jmil/makerbot/trunk/firmware/README

This source for the firmware moved to: http://github.com/makerbot/G3Firmware

This directory instead now contains the firmware.makerbot.com website.
