jmil/makerbot/tags/filament-spindle-mk1/readme.txt

For full instructions, see: http://wiki.makerbot.com/spindle-mk1
