jmil/makerbot/tags/firmware-1.6/dist/readme.txt

For more info, see this page: http://wiki.makerbot.com/burn-custom-firmware-using-arduino
