jmil/makerbot/tags/firmware-1.6/SanguinoMaster/Readme.txt

=========================
SANGUINO 3G FIRMWARE v1.2
=========================

This is the v1.2 release of the firmware for Sanguino-based RepRap
motherboards and derivatives.  Right now, this includes:

* RepRap Motherboard v1.1
* RepRap Motherboard v1.2

============
INSTALLATION
============

Complete installation instructions can be found here:
http://www.reprap.org/bin/view/Main/Generation3Firmware

The important points to note are:
* You must have the Sanguino extensions to the Arduino software
properly installed
* Remember to install the libraries
* The RepRap Motherboards v1.1 and v1.2 have a flaw which prevents
them from resetting themselves when the Arduino software tries to
program them.  It's tricky to get the timing right; you may need to
try multiple times.  See the following link for more information:
http://wiki.makerbot.com/tips-and-tricks#rrmb-uploading

=======
LICENSE
=======

This program is free software; you can redistribute it and/or
modify it under the terms of the GNU General Public License
as published by the Free Software Foundation; either version 2
of the License, or (at your option) any later version.

This program is distributed in the hope that it will be useful,
but WITHOUT ANY WARRANTY; without even the implied warranty of
MERCHANTABILITY or FITNESS FOR A PARTICULAR PURPOSE.  See the
GNU General Public License for more details.

You should have received a copy of the GNU General Public License
along with this program; if not, write to the Free Software
Foundation, Inc., 51 Franklin Street, Fifth Floor, Boston, MA  02110-1301, USA.
