jmil/makerbot/users/charles/bowden/retainingMechanism-0.1.png

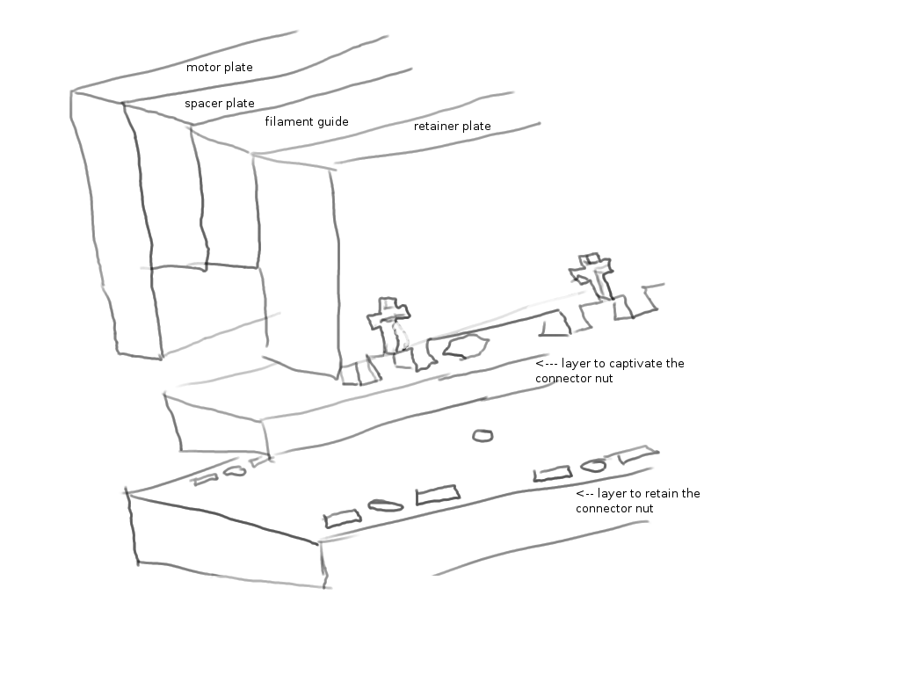
users/charles/bowden/retainingMechanism-0.1.png
