jmil/makerbot/users/charles/bowden/retainingMechanism-0.2.png

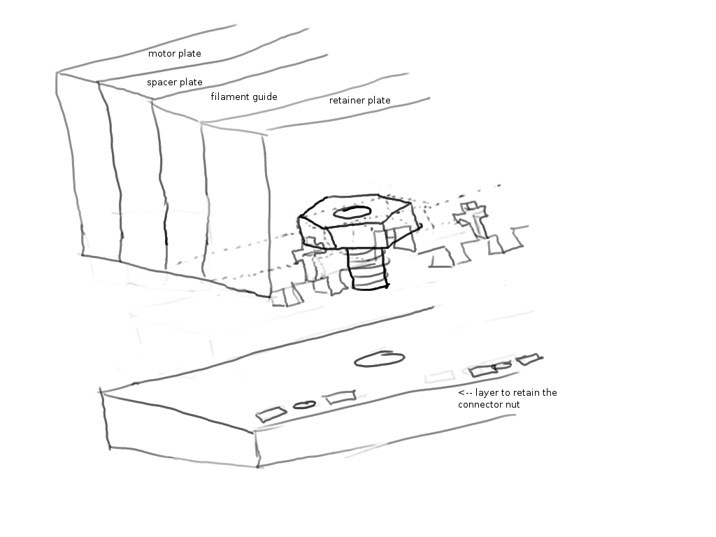
users/charles/bowden/retainingMechanism-0.2.png
