jmil/makerbot/tags/electronics/motherboard-2.4/motherboard-1.2.xls

RepRap Motherboard v1.2
Item # | Quantity | Designator | Part Number | Description | Package | Type
1 | 1 | IC1 | mouser: 595-SN75176AD | SN75176A SOIC | SOIC | SMT
2 | 1 | IC2 | digikey: ATMEGA644P-20AU-ND | Atmega644p tqfp | TQFP | fine pitch
3 | 2 | C1, C2 | mouser: 77-VJ12A100V150J | 15pF ceramic capacitor 1206 | 1206 | SMT
4 | 3 | C3, C5, C8 | mouser: 80-C1206C104K5R | 100nF ceramic capacitor 1206 | 1206 | SMT
5 | 1 | C6 | mouser: 647-UUT1H100MCL1GS | 10uF electrolytic capacitor | ??? | SMT
6 | 1 | DEBUG | mouser: 645-598-8210-107F | Red LED 1206 | 1206 | SMT
7 | 1 | POWER | mouser: 645-598-8270-107F | Green LED 1206 | 1206 | SMT
8 | 1 | Q2 | mouser: 695-HC49US-16-U | 16Mhz crystal | crystal | Thru-hole
9 | 4 | R1, R13, R14, R18 | mouser: 290-10K-RC | 10K ohm resistor 1206 | 1206 | SMT
10 | 2 | R2, R3 | mouser: 290-1.0K-RC | 1K ohm resistor 1206 | 1206 | SMT
11 | 5 | R4, R5, R6, R11, R12 | mouser: 263-1.8K-RC | 1.8K ohm resistor 1206 | 1206 | SMT
12 | 3 | R7, R8, R9 | mouser: 263-3.3K-RC | 3.3K ohm resistor 1206 | 1206 | SMT
13 | 2 | R10, R15 | mouser: 263-4.7K-RC | 4.7K ohm resistor 1206 | 1206 | SMT
14 | 1 | R16 | mouser: 263-180-RC | 180 ohm resistor 1206 | 1206 | DNS
15 | 1 | R17 | digikey: 30W-5-ND | 30 ohm resistor 5W | resistor | Thru-hole
16 | 4 | X, Y, Z, JTAG | mouser: 649-75869-101LF | 10 pin IDC header | header | Thru-hole
17 | 1 | ICSP | mouser: 649-75869-131LF | 6 pin IDC header | header | Thru-hole
18 | 1 | SD CARD | digikey: 3M5646CT-ND | 3M sd card socket | ??? | SMT
19 | 1 | Reset | mouser: 653-B3F-1000 | Omron B3F-1000 Button | button | Thru-hole
20 | 4 | J1-J4 | Mouser: 571-5555164-1 | RJ45 Jack | connector | Thru-hole
21 | 1 | ON/OFF | mouser: 10SP001 | SPDT switch | switch | Thru-hole
22 | 6 | Serial | Mouser: 571-9-146304-0 | .100 breakaway header (right-angle) | header | Thru-hole
23 | 4 |  | digikey: S7008-ND | 10 pin female header | header | DNS
24 | 4 |  | digikey: S7037-ND | 4 pin female header | header | DNS
25 | 1 |  | Mouser: 538-39-29-3206 | ATX Motherboard Header | header | Thru-hole
