jmil/makerbot/tags/electronics/stepper-motor-driver-3.3/stepper-motor-driver-2.3.xls

Stepper Motor Driver v2.3
Item # | Quantity | Designator | Part Number | Description | Package | Type
1 | 1 | DRIVER | digikey: 620-1082-ND | A3982 | SOIC | SMT
2 | 1 | C2 | mouser: 80-C1206C102K5R | 1nF ceramic capacitor 1206 | 1206 | SMT
3 | 5 | C1, C4, C6, C8, C12 | mouser: 80-C1206C104K5R | 100nF ceramic capacitor 1206 | 1206 | SMT
4 | 1 | C3 | mouser: 80-C1206C224K5R | .22uF ceramic capacitor 1206 | 1206 | SMT
5 | 2 | C10, C11 | mouser: 647-UUX1H101MNL1GS | 100uF electrolytic capacitor D55 |  | SMT
6 | 2 | J1, J2 | mouser: 571-5555164-1 | RJ45 Jack | JACK | Thru-hole
7 | 1 | IC3 | mouser: 863-MC7805CDTRKG | 7805DT | DPAK | SMT
8 | 3 | LED1, LED2, LED3 | mouser: 645-598-8270-107F | Green LED 1206 | 1206 | SMT
9 | 2 | LED4, LED5 | mouser: 645-598-8210-107F | Red LED 1206 | 1206 | SMT
10 | 1 | POWER | mouser: 538-15-24-4745 | 4 pin molex connector | HEADER | Thru-hole
11 | 1 | R2 | mouser: 290-10K-RC | 10K ohm resistor 1206 | 1206 | SMT
12 | 2 | R3, R16 | mouser: 66-LR2512LF-01-R250 | 0.25 ohm resistor 2512 | 2512 | SMT
13 | 4 | R5, R7, R8, R17 | mouser: 290-1.0K-RC | 1K ohm resistor 1206 | 1206 | SMT
14 | 1 | R6 | mouser: 263-2.2K-RC | 2.2K ohm resistor 1206 | 1206 | SMT
15 | 1 | R15 | mouser: 72-T70YE-10K | 10K trimpot |  | Thru-hole
16 | 1 | INTERFACE | mouser: 649-75869-101LF | 10 pin IDC header | HEADER | Thru-hole
17 | 1 | ABCD | mouser: 538-26-48-1245 | .156" header | HEADER | Thru-hole
