jmil/makerbot/tags/automated-build-platform-v1/automated-build-platform.dxf

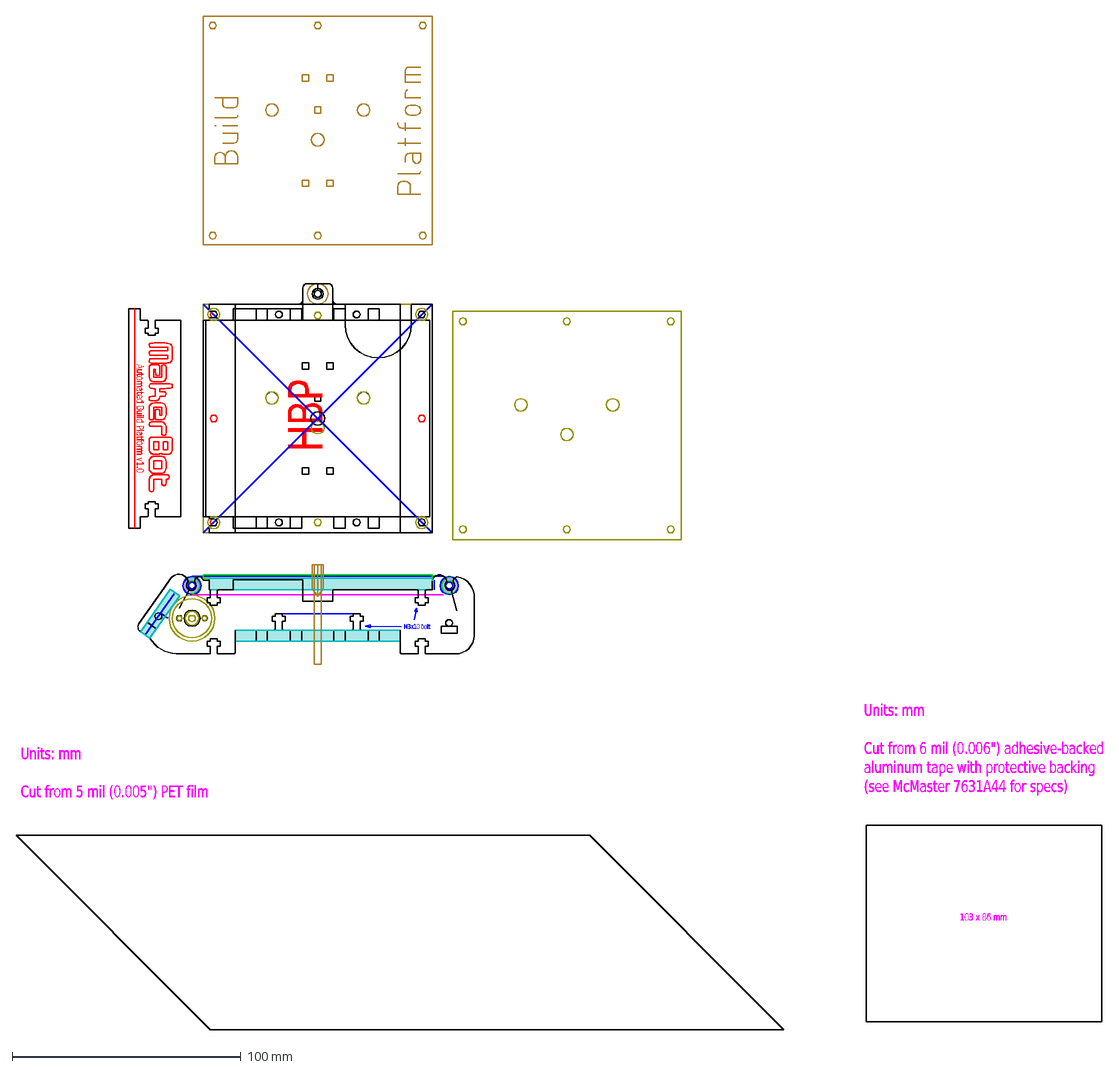
[picture p5: CAD file, 2010-09-10]
tags/automated-build-platform-v1/automated-build-platform.dxf
HBP
M3x10\~bolt
Units:\~mm Cut\~from\~5\~mil\~(0.005")\~PET\~film
Units:\~mm Cut\~from\~6\~mil\~(0.006")\~adhesive-backed aluminum\~tape\~with\~protective\~backing (see\~McMaster\~7631A44\~for\~specs)
103\~x\~86\~mm
Automated\~Build\~Platform\~v1.0
