jmil/makerbot/tags/cupcake-cnc-batch-3-4/build-surface.dxf

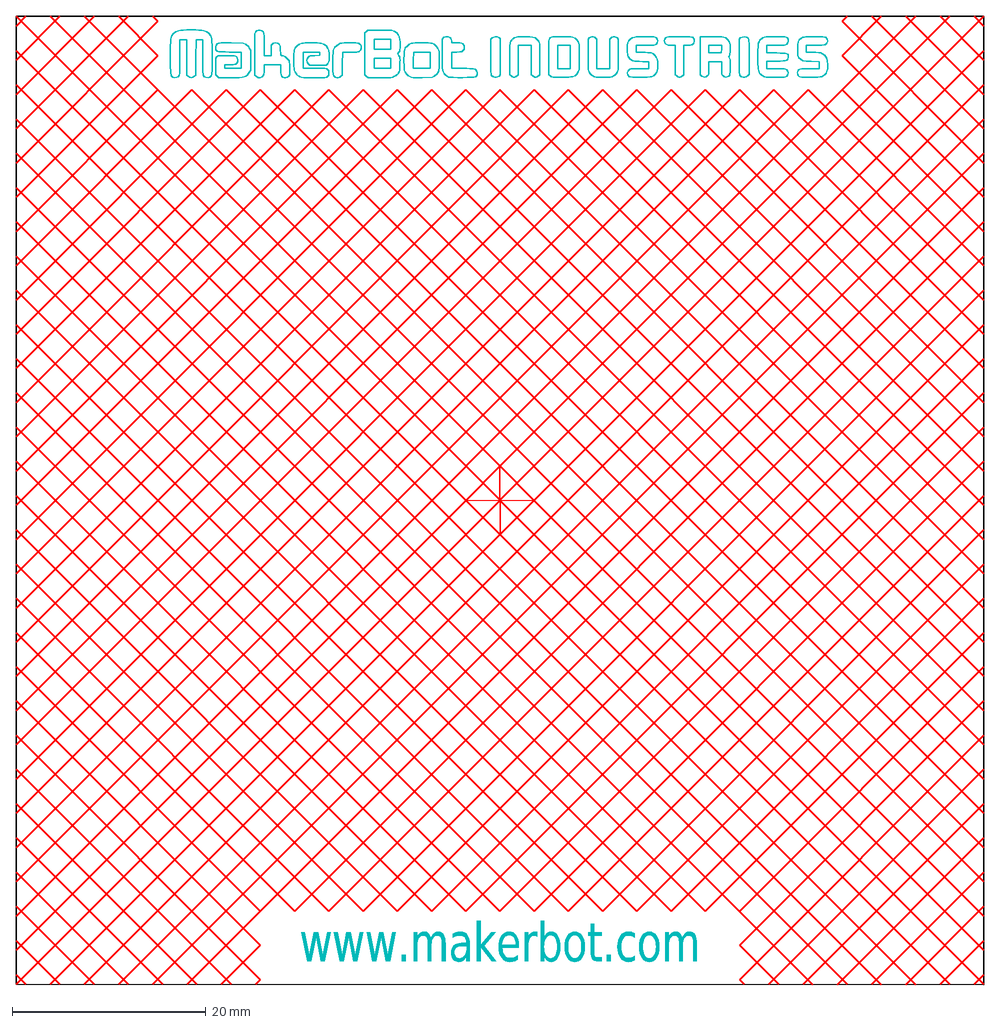
[picture p6: CAD file, 2009-05-25]
tags/cupcake-cnc-batch-3-4/build-surface.dxf
www.makerbot.com
