jmil/makerbot/tags/cupcake-cnc-batch-3-4/cutting_layouts/build-surfaces.dxf

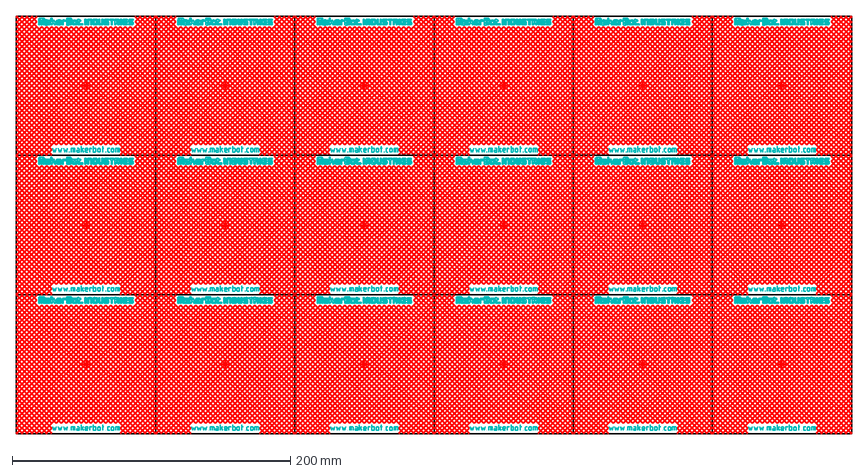
[picture p7: CAD file, 2009-05-25]
tags/cupcake-cnc-batch-3-4/cutting_layouts/build-surfaces.dxf
600.0 x 300.0 mm
