jmil/makerbot/tags/cupcake-cnc-batch-3-4/guides/bearing-sleeve-holes.dxf

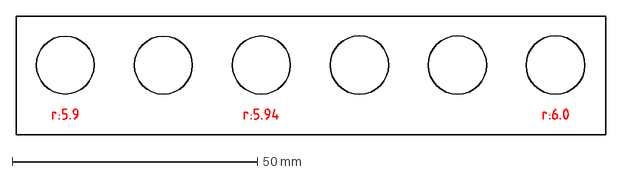
[picture p8: CAD file, 2009-04-12]
tags/cupcake-cnc-batch-3-4/guides/bearing-sleeve-holes.dxf
120.2 x 24.2 mm
