jmil/makerbot/tags/filament-spindle-mk1/filament-spindle.dxf

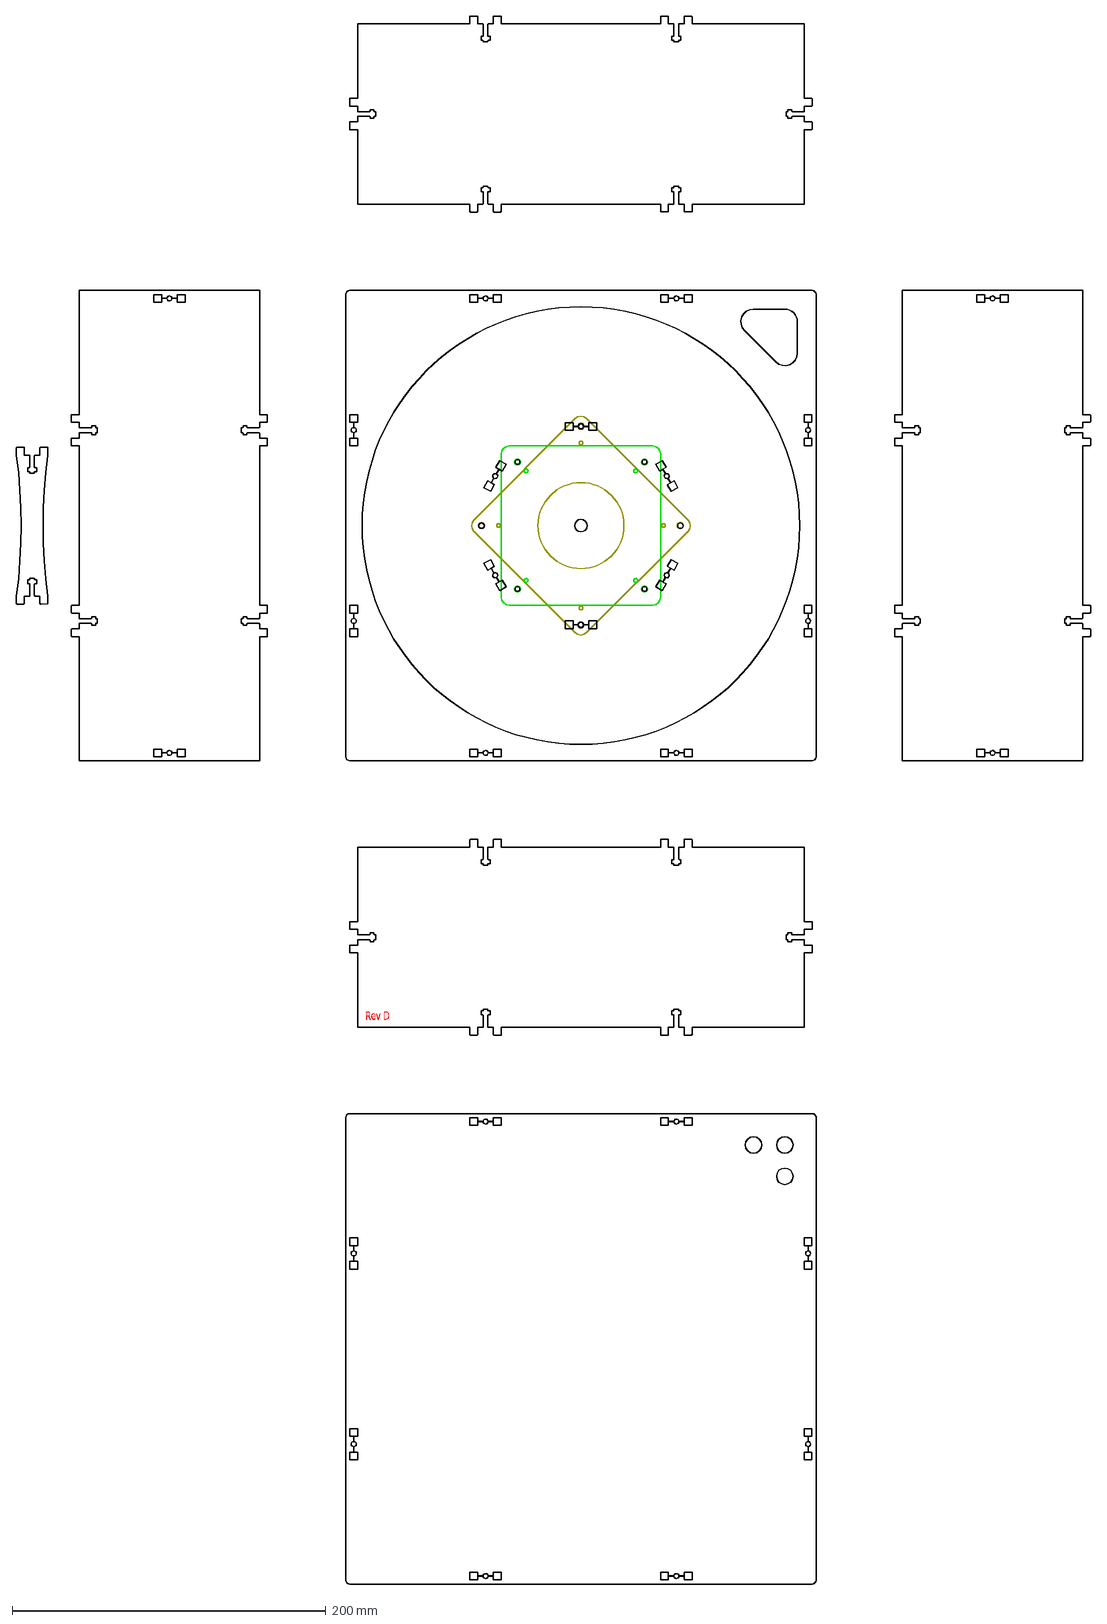
[picture p9: CAD file, 2010-05-13]
tags/filament-spindle-mk1/filament-spindle.dxf
Rev\~D
