jmil/makerbot/tags/frostruder-mk2/clamp.dxf

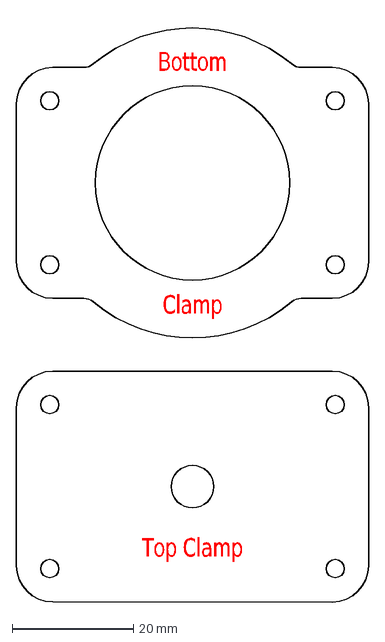
[picture p10: CAD file, 2009-11-02]
tags/frostruder-mk2/clamp.dxf
Top\~Clamp
Bottom
Clamp
