jmil/makerbot/tags/plastruder-mk5/filament-drive/filament-drive.dxf

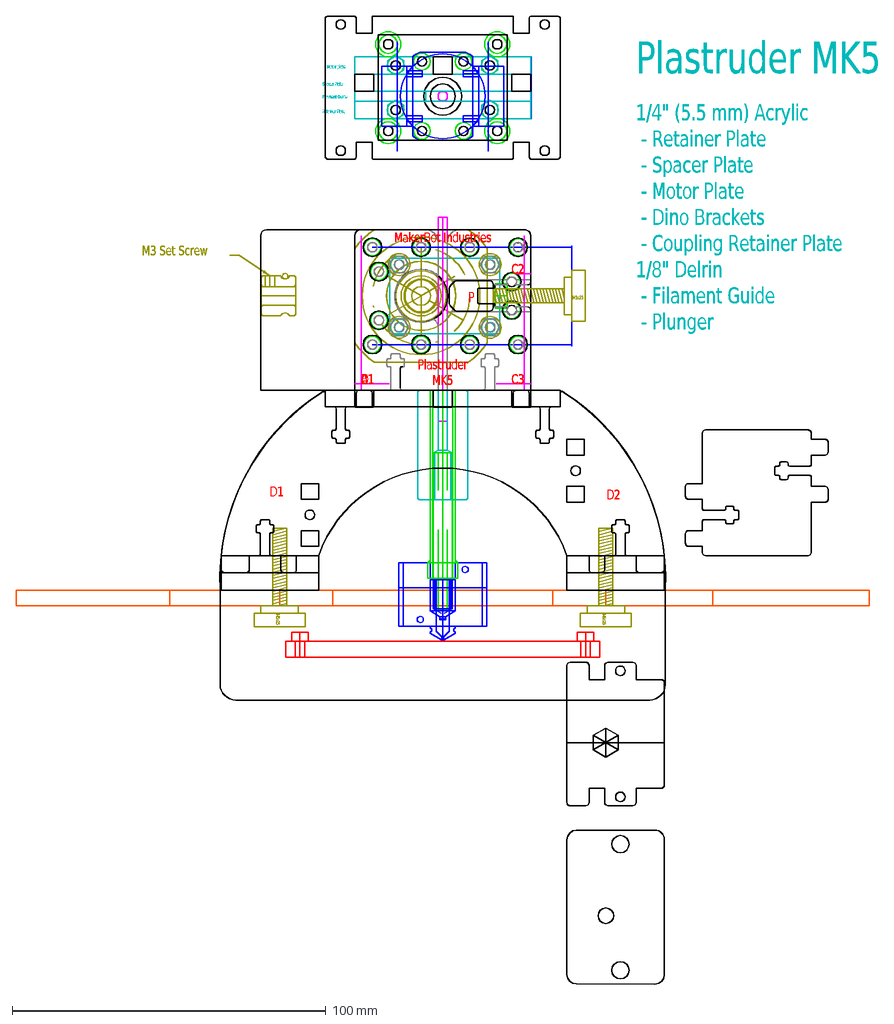
[picture p11: CAD file, 2010-06-04]
tags/plastruder-mk5/filament-drive/filament-drive.dxf
M5x25
M3\~Set\~Screw
Filament\~Guide
Spacer\~Plate
Retainer\~Plate
Motor\~plate
Plastruder\~MK5
1/4"\~(5.5\~mm)\~Acrylic \~-\~Retainer\~Plate \~-\~Spacer\~Plate \~-\~Motor\~Plate \~-\~Dino\~Brackets \~-\~Coupling\~Retainer\~Plate 1/8"\~Delrin \~-\~Filament
A
B
C1
C3
C2
P
D
MakerBot\~Industries
Plastruder MK5
D1
D2
