jmil/makerbot/tags/plastruder-mk5/hot-end/heater-block.dxf

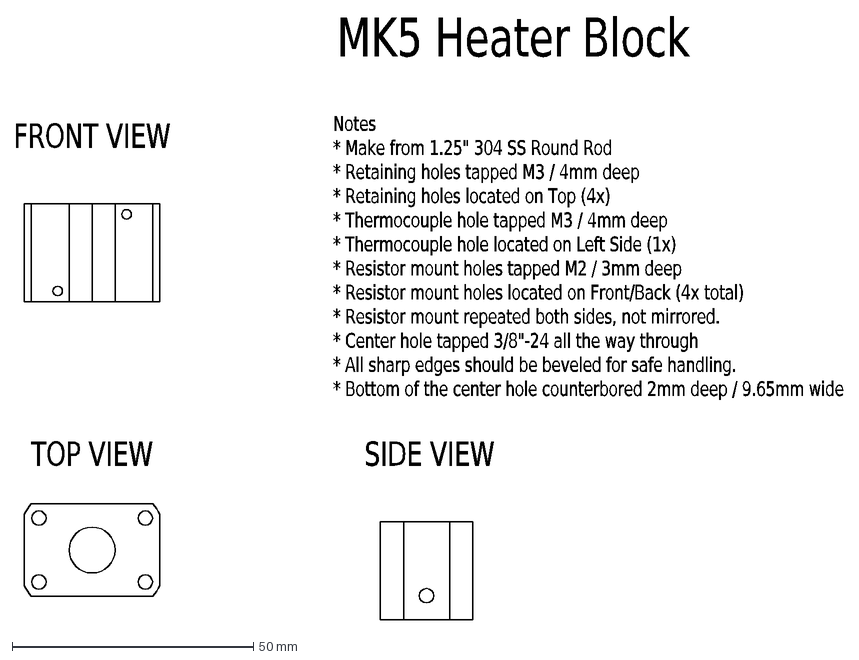
[picture p12: CAD file, 2010-06-06]
tags/plastruder-mk5/hot-end/heater-block.dxf
FRONT\~VIEW
TOP\~VIEW
SIDE\~VIEW
MK5\~Heater\~Block
Notes *\~Make\~from\~1.25"\~304\~SS\~Round\~Rod *\~Retaining\~holes\~tapped\~M3\~/\~4mm\~deep *\~Retaining\~holes\~located\~on\~Top\~(4x) *\~Thermocouple\~hole\
