jmil/makerbot/tags/thingomatic/primary-stage.dxf

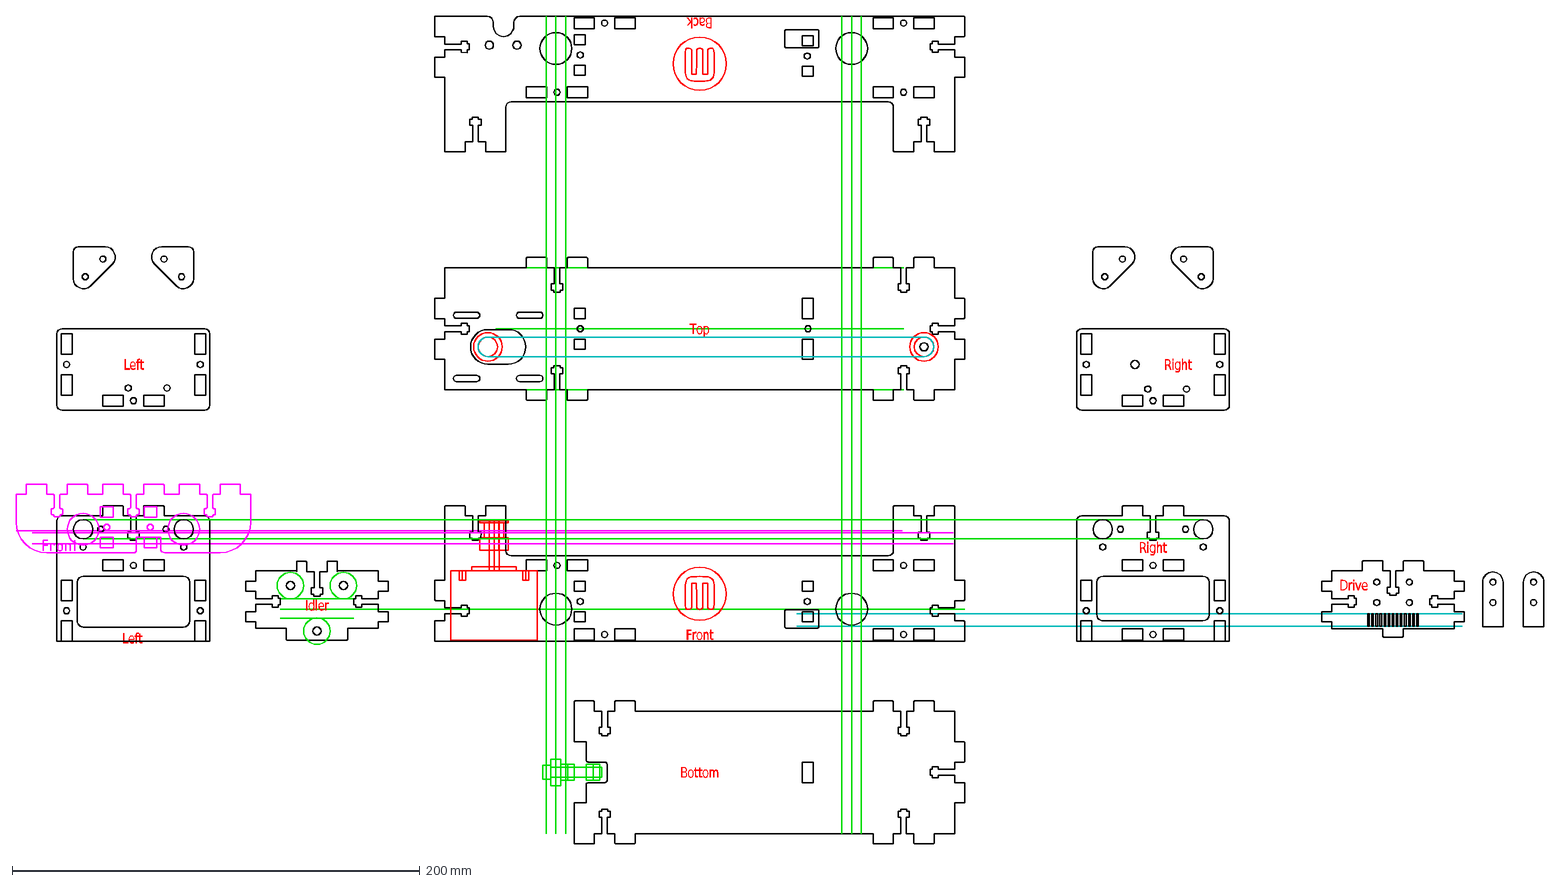
[picture p13: CAD file, 2010-11-30]
tags/thingomatic/primary-stage.dxf
Top
Bottom
Right
Left
Drive
Idler
Front
Back
