jmil/makerbot/trunk/cupcake/idler-pulley-608-cut.dxf

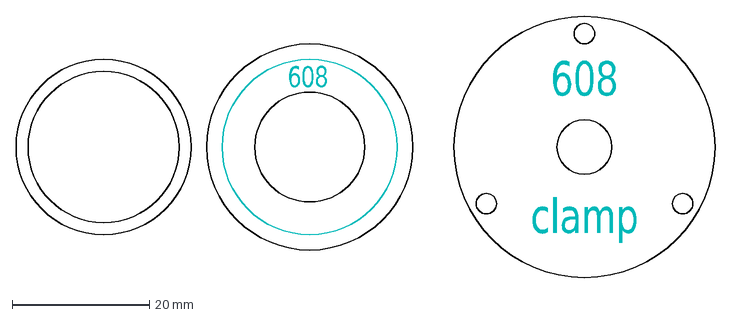
[picture p14: CAD file, 2009-04-04]
trunk/cupcake/idler-pulley-608-cut.dxf
608
clamp
