jmil/makerbot/trunk/cupcake/lasercut-parts/x-stage/cap-back.dxf

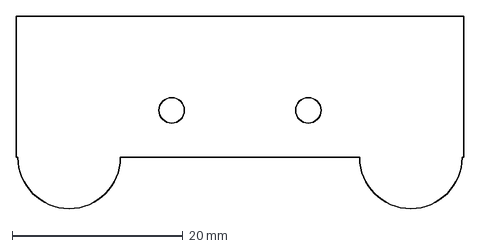
[picture p15: CAD file, 2010-04-20]
trunk/cupcake/lasercut-parts/x-stage/cap-back.dxf
52.4 x 22.5 mm
