jmil/makerbot/trunk/cupcake/lasercut-parts/y-stage/build-platform.dxf

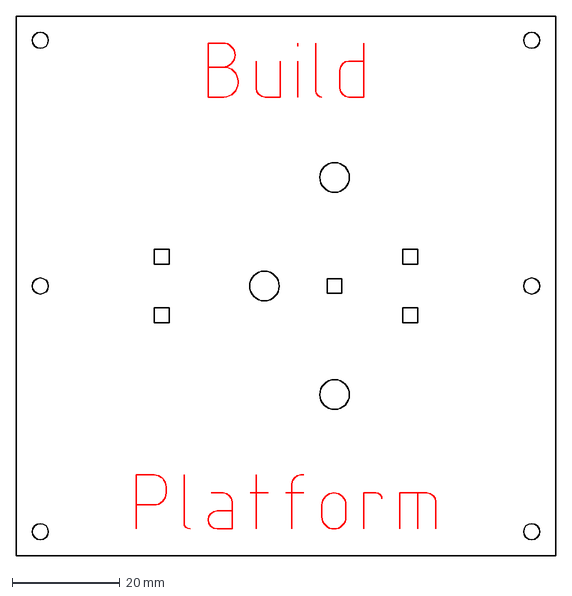
[picture p16: CAD file, 2010-04-16]
trunk/cupcake/lasercut-parts/y-stage/build-platform.dxf
100.0 x 100.0 mm
