jmil/makerbot/trunk/electronics/cupcake-heater-board/pre-batch 5 build platform.dxf

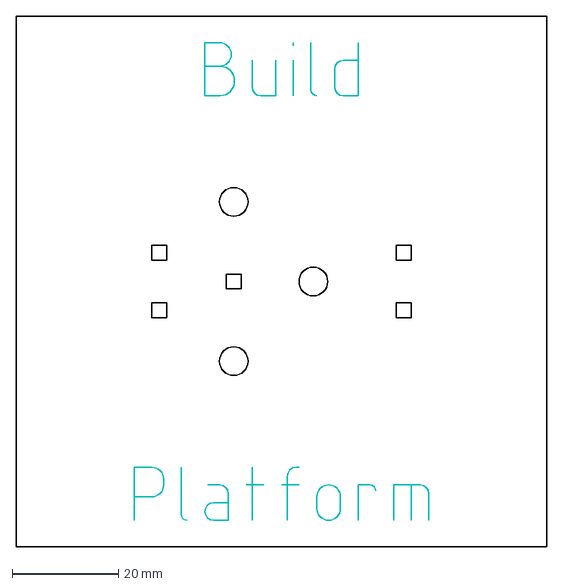
[picture p17: CAD file, 2010-04-20]
trunk/electronics/cupcake-heater-board/pre-batch 5 build platform.dxf
100.0 x 100.0 mm
