jmil/makerbot/trunk/electronics/dc-servo-controller/test-rig.dxf

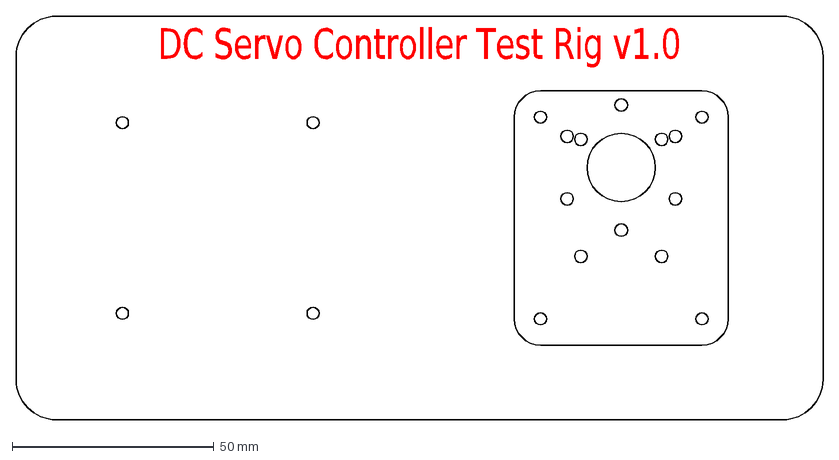
[picture p18: CAD file, 2010-08-24]
trunk/electronics/dc-servo-controller/test-rig.dxf
DC\~Servo\~Controller\~Test\~Rig\~v1.0
