jmil/makerbot/trunk/electronics/noise-suppressor/noise-suppressor.dxf

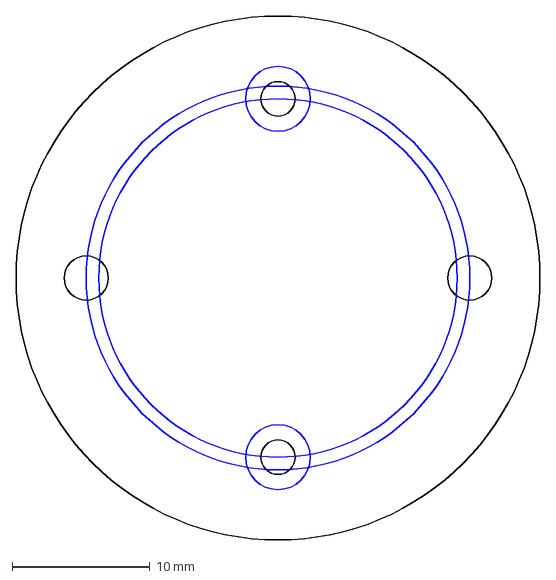
[picture p19: CAD file, 2010-05-26]
trunk/electronics/noise-suppressor/noise-suppressor.dxf
38.0 x 38.0 mm
