jmil/makerbot/trunk/frostruder/clamp.dxf

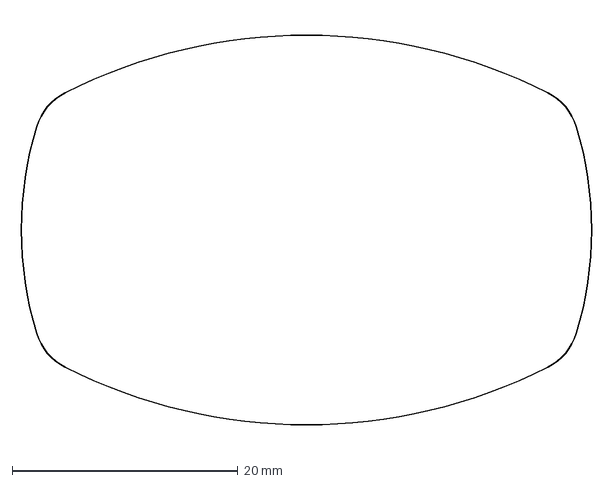
[picture p20: CAD file, 2009-11-16]
trunk/frostruder/clamp.dxf
51.4 x 37.9 mm
