jmil/makerbot/trunk/makerscan/test_platform.dxf

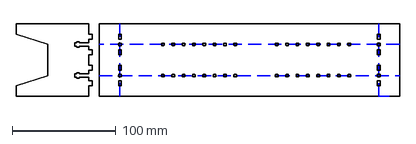
[picture p21: CAD file, 2009-11-14]
trunk/makerscan/test_platform.dxf
370.0 x 70.0 mm
