jmil/makerbot/users/bre/double-tall/doubletall.dxf

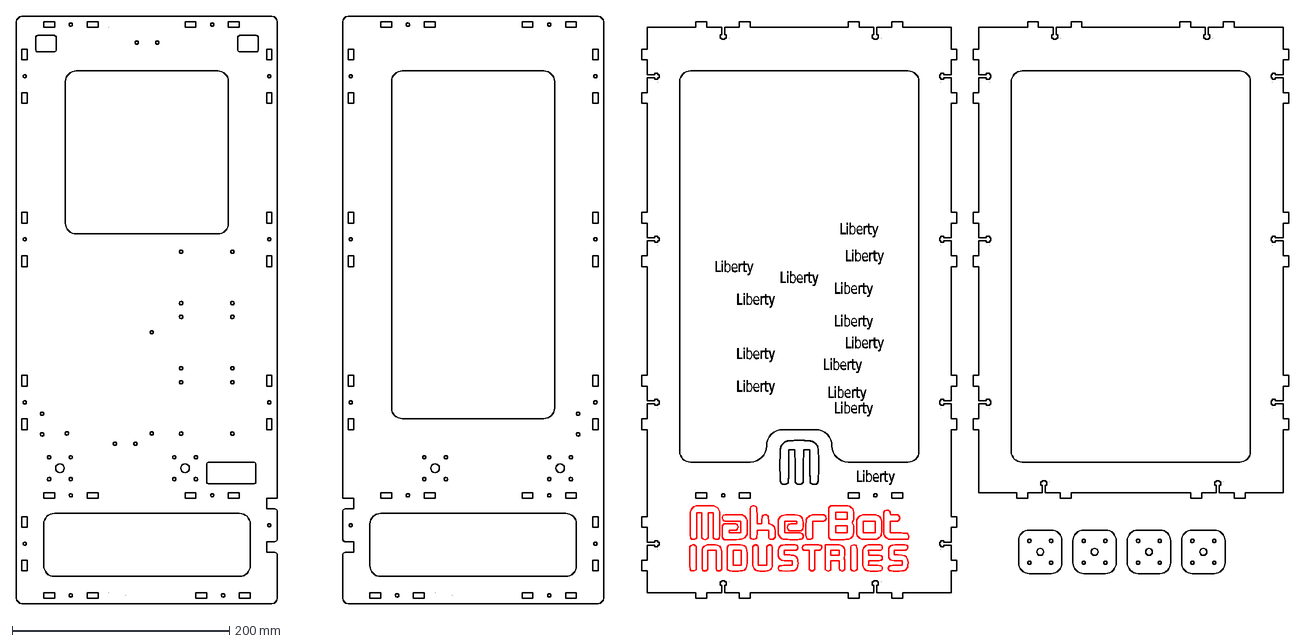
[picture p22: CAD file, 2009-09-01]
users/bre/double-tall/doubletall.dxf
Liberty
