jmil/makerbot/users/bre/double-wide/doublewide.dxf

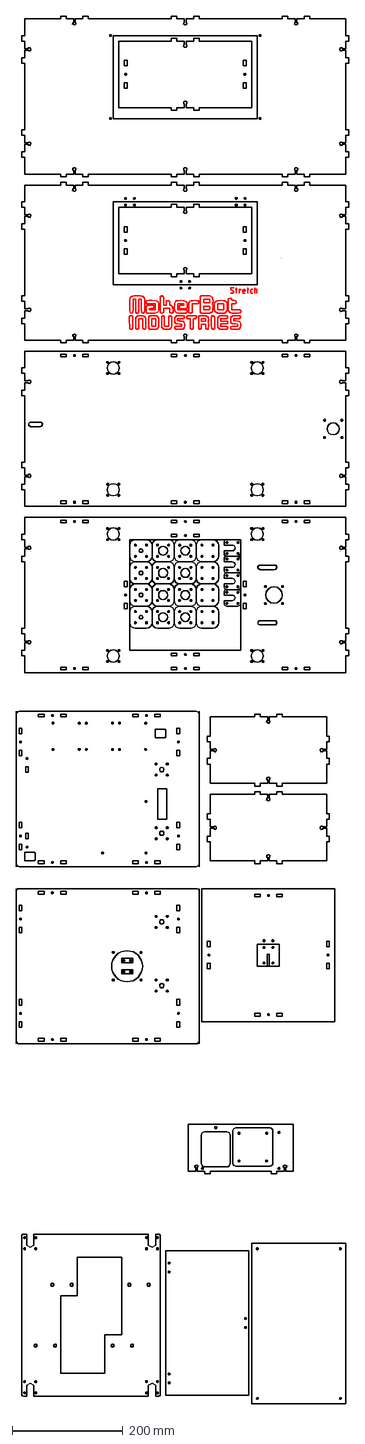
[picture p23: CAD file, 2009-09-01]
users/bre/double-wide/doublewide.dxf
600.0 x 2505.0 mm
