jmil/makerbot/users/bre/watchcase.dxf

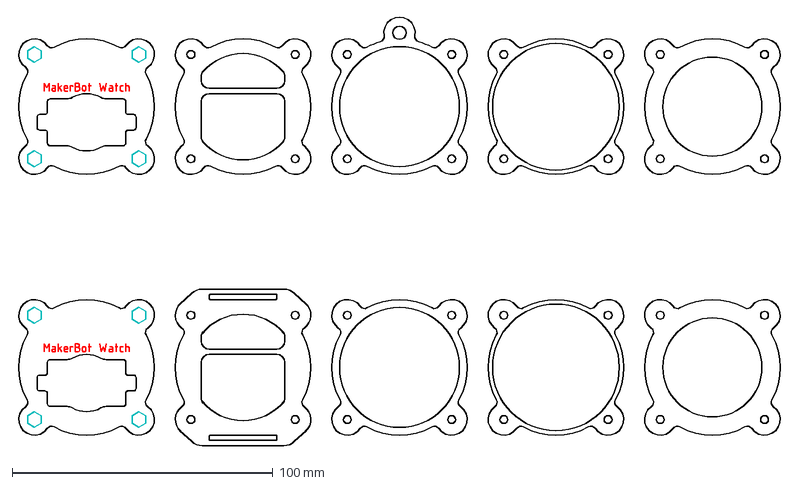
[picture p24: CAD file, 2009-12-07]
users/bre/watchcase.dxf
294.1 x 164.6 mm
