jmil/makerbot/users/charles/paxtruder/Paxtruder-0.4-2009.11.22.2233.dxf

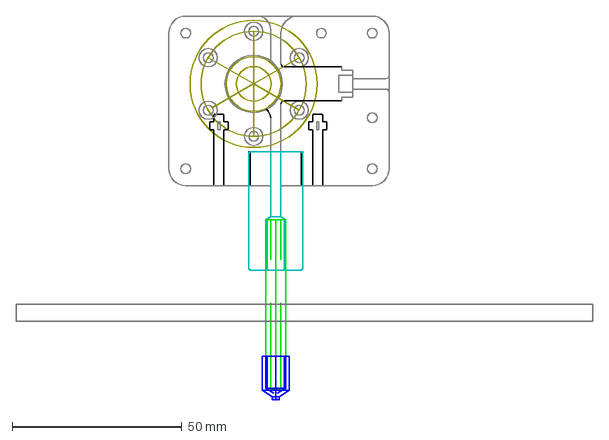
[picture p25: CAD file, 2010-02-21]
users/charles/paxtruder/Paxtruder-0.4-2009.11.22.2233.dxf
170.0 x 113.2 mm
