jmil/makerbot/users/charles/relay-adapter/relay-controller-adapter.dxf

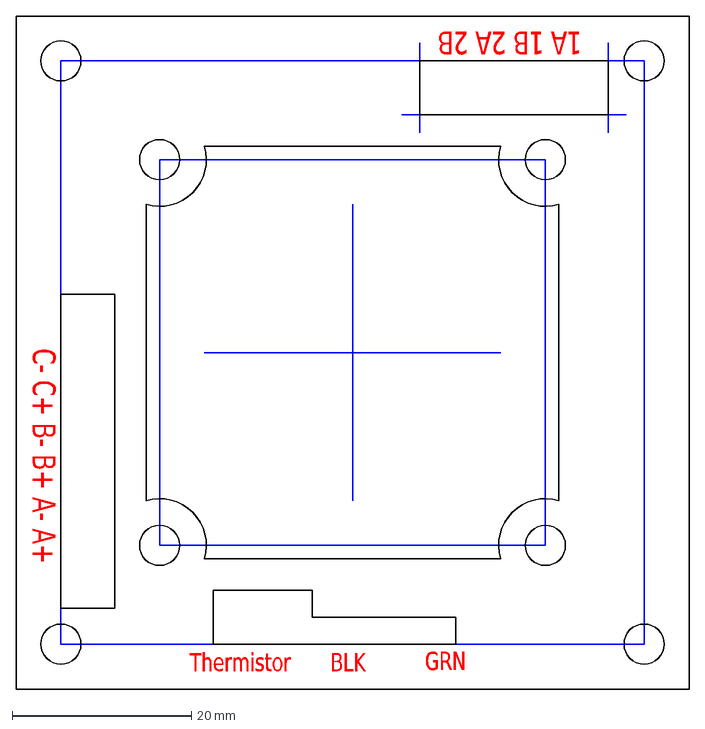
[picture p26: CAD file, 2010-09-17]
users/charles/relay-adapter/relay-controller-adapter.dxf
C-\~C+\~B-\~B+\~A-\~A+
Thermistor
GRN
BLK
1A\~1B\~2A\~2B
