jmil/makerbot/users/charles/test-rigs/gear-motor-test-rig.dxf

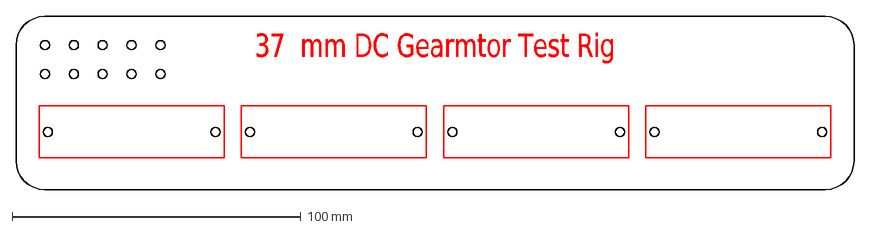
[picture p27: CAD file, 2010-10-28]
users/charles/test-rigs/gear-motor-test-rig.dxf
37\~\~mm\~DC\~Gearmtor\~Test\~Rig
