jmil/makerbot/users/hoeken/art/rose.dxf

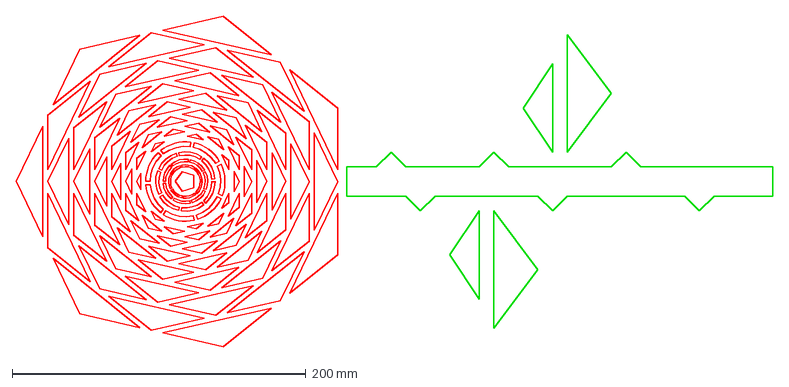
[picture p28: CAD file, 2010-05-12]
users/hoeken/art/rose.dxf
515.2 x 224.7 mm
