jmil/makerbot/users/hoeken/conveyor-table/arm.dxf

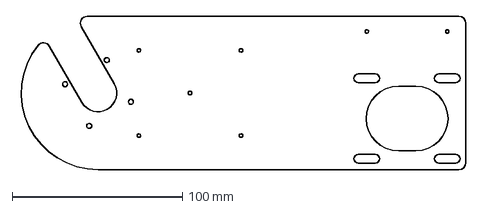
[picture p29: CAD file, 2010-03-30]
users/hoeken/conveyor-table/arm.dxf
264.0 x 90.0 mm
