jmil/makerbot/users/hoeken/flipped-b/x-stage.dxf

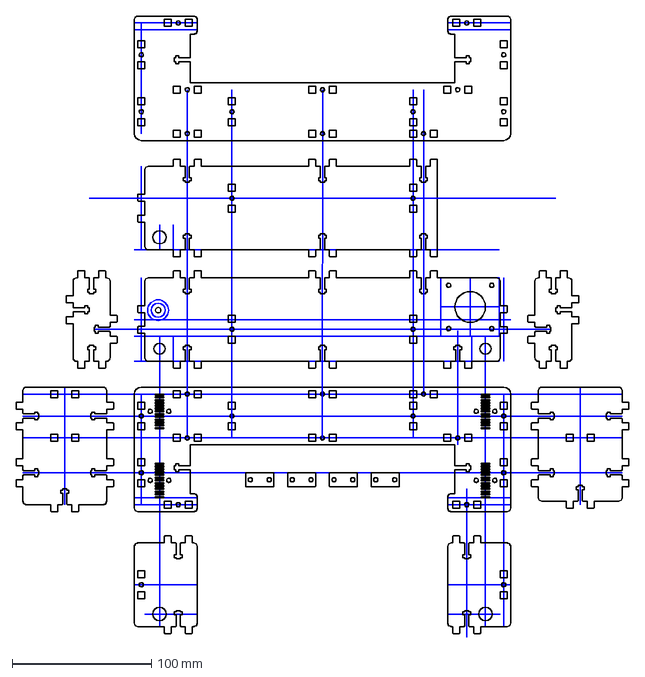
[picture p30: CAD file, 2009-11-30]
users/hoeken/flipped-b/x-stage.dxf
440.0 x 445.8 mm
