jmil/makerbot/users/hoeken/frostruder-mk2/frostruder.dxf

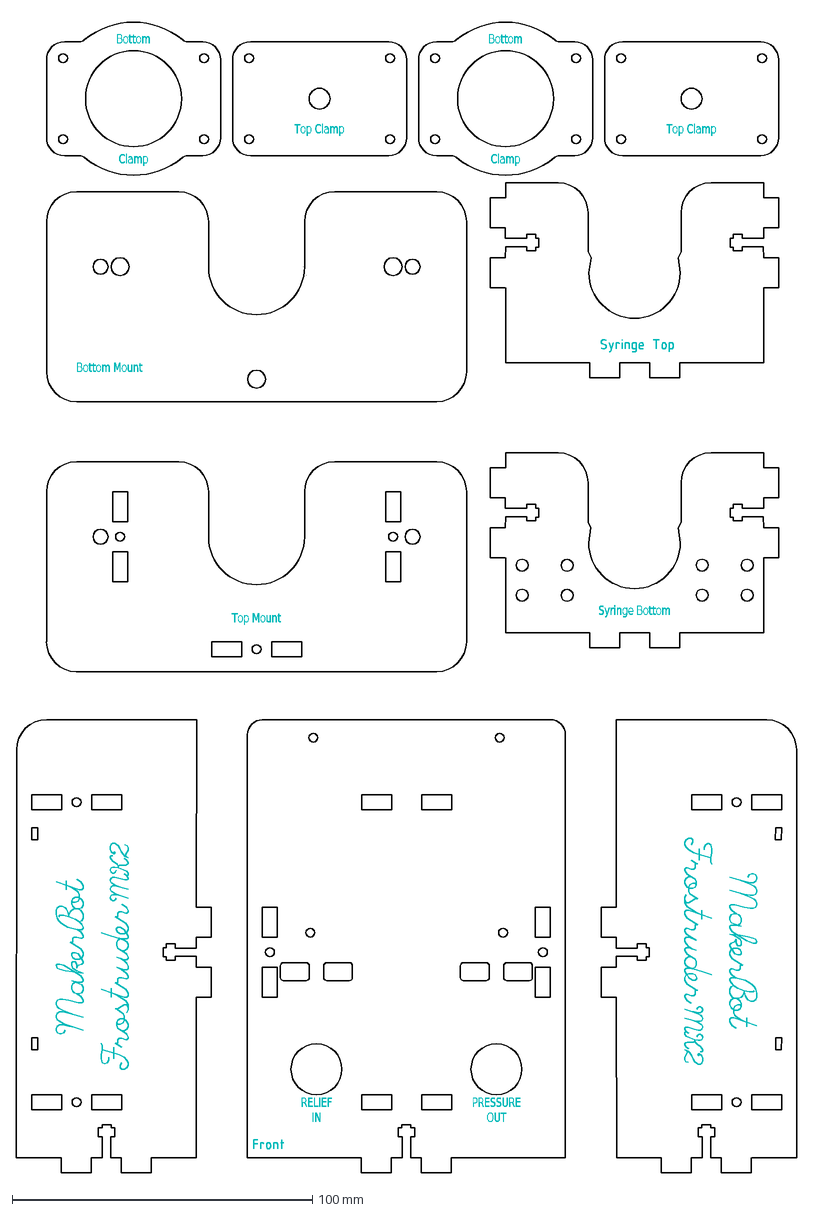
[picture p31: CAD file, 2009-10-11]
users/hoeken/frostruder-mk2/frostruder.dxf
Bottom\~Mount
Syringe\~Bottom
Top\~Mount
RELIEF IN
PRESSURE OUT
Bottom
Clamp
Top\~Clamp
