jmil/makerbot/users/hoeken/gen5/magnetic-rotary-encoder/magnetic-rotary-encoder.dxf

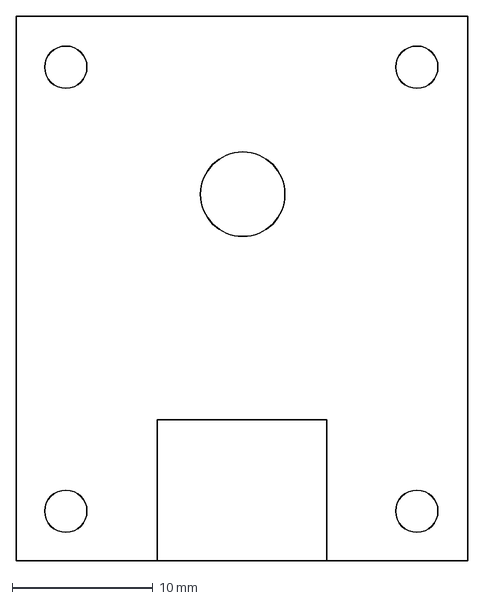
[picture p32: CAD file, 2009-10-25]
users/hoeken/gen5/magnetic-rotary-encoder/magnetic-rotary-encoder.dxf
32.0 x 38.6 mm
