jmil/makerbot/users/hoeken/kitten/sdp-si-xy-stage.dxf

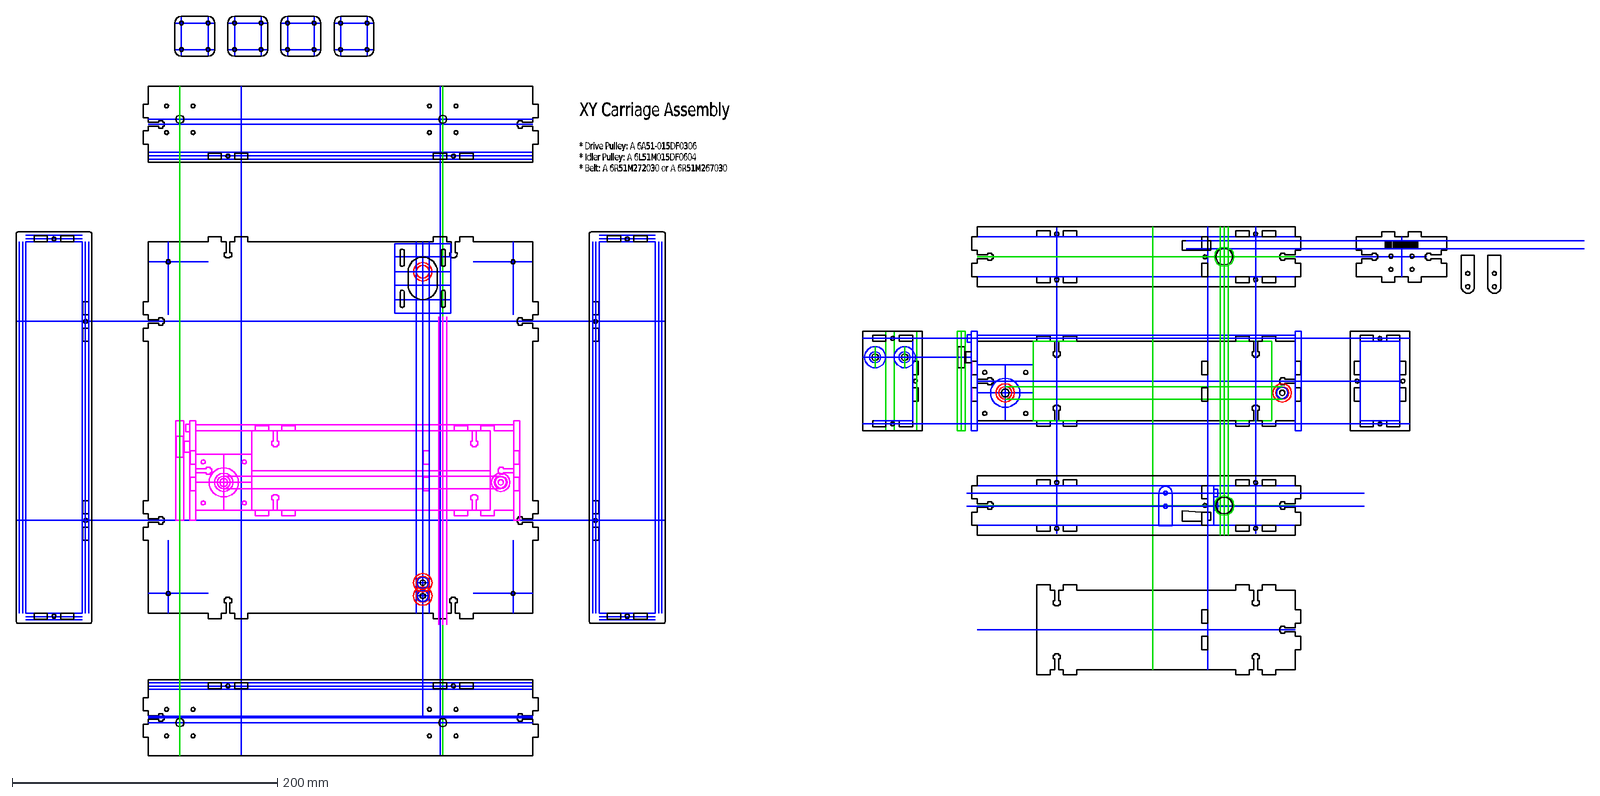
[picture p33: CAD file, 2010-06-18]
users/hoeken/kitten/sdp-si-xy-stage.dxf
*\~Drive\~Pulley:\~A\~6A51-015DF0306 *\~Idler\~Pulley:\~A\~6L51M015DF0604 *\~Belt:\~A\~6R51M272030\~or\~A\~6R51M267030
XY\~Carriage\~Assembly
