jmil/makerbot/users/hoeken/micro-cnc/micro-layout.dxf

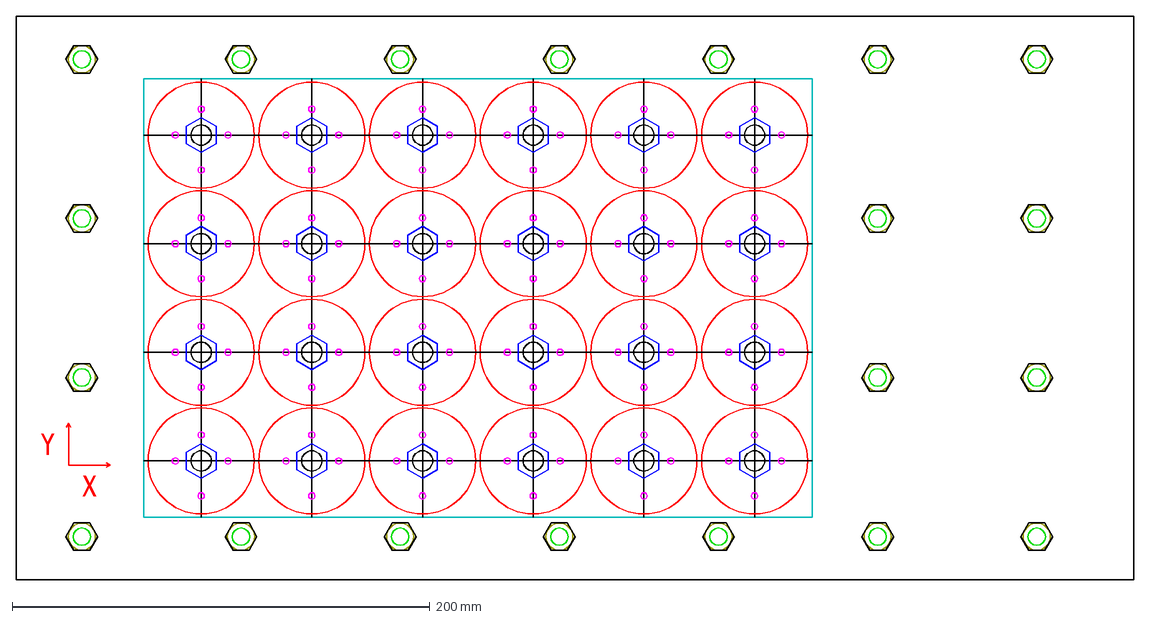
[picture p34: CAD file, 2009-09-17]
users/hoeken/micro-cnc/micro-layout.dxf
X
Y
