jmil/makerbot/users/hoeken/mk5-hot-end/hex-heater-block.dxf

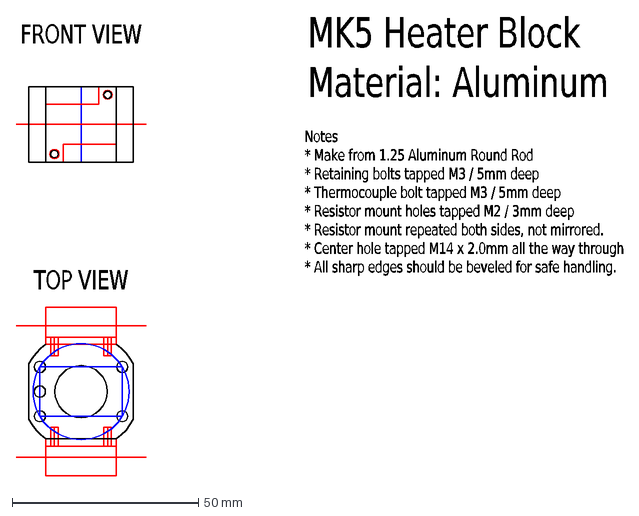
[picture p35: CAD file, 2010-02-26]
users/hoeken/mk5-hot-end/hex-heater-block.dxf
FRONT\~VIEW
TOP\~VIEW
MK5\~Heater\~Block Material:\~Aluminum
Notes *\~Make\~from\~1.25\~Aluminum\~Round\~Rod *\~Retaining\~bolts\~tapped\~M3\~/\~5mm\~deep *\~Thermocouple\~bolt\~tapped\~M3\~/\~5mm\~deep *\~Resistor\~mount
