jmil/makerbot/users/hoeken/openscad/botcube/cube.stl

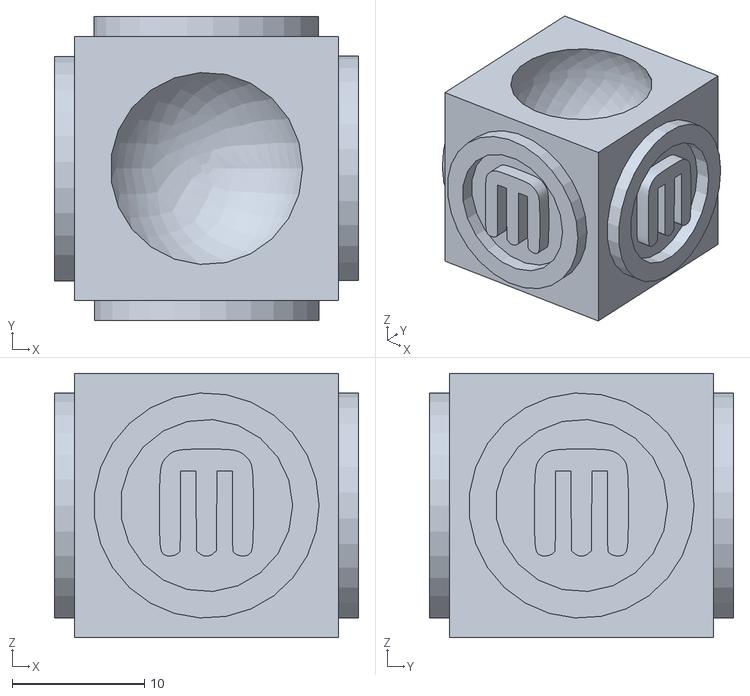
[picture p36: CAD file, 2010-05-23]
users/hoeken/openscad/botcube/cube.stl
23.0 x 23.0 x 20.0
