jmil/makerbot/users/hoeken/openscad/projector-mount/projector-mount.stl

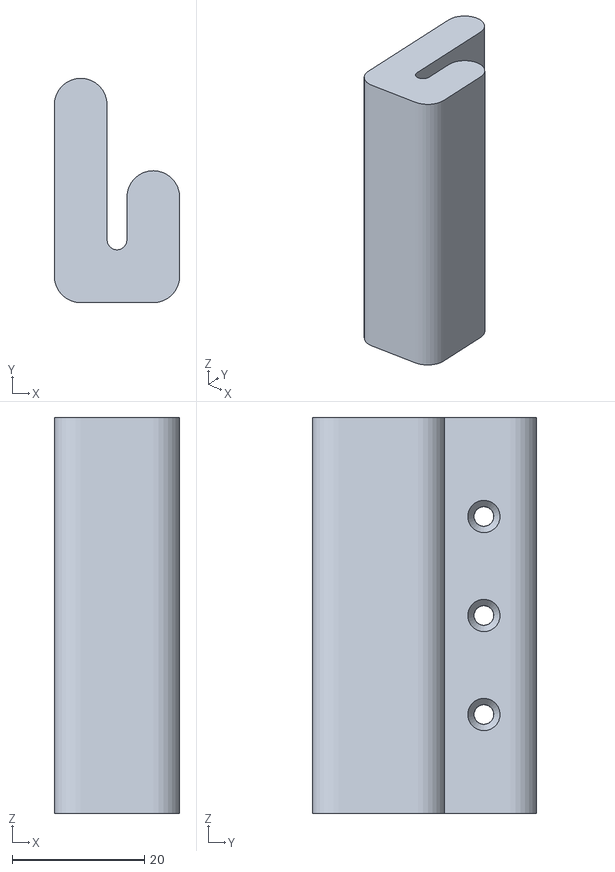
[picture p37: CAD file, 2010-05-12]
users/hoeken/openscad/projector-mount/projector-mount.stl
19.0 x 34.0 x 60.0
