jmil/makerbot/users/hoeken/openscad/tp-holder/inner-tube.stl

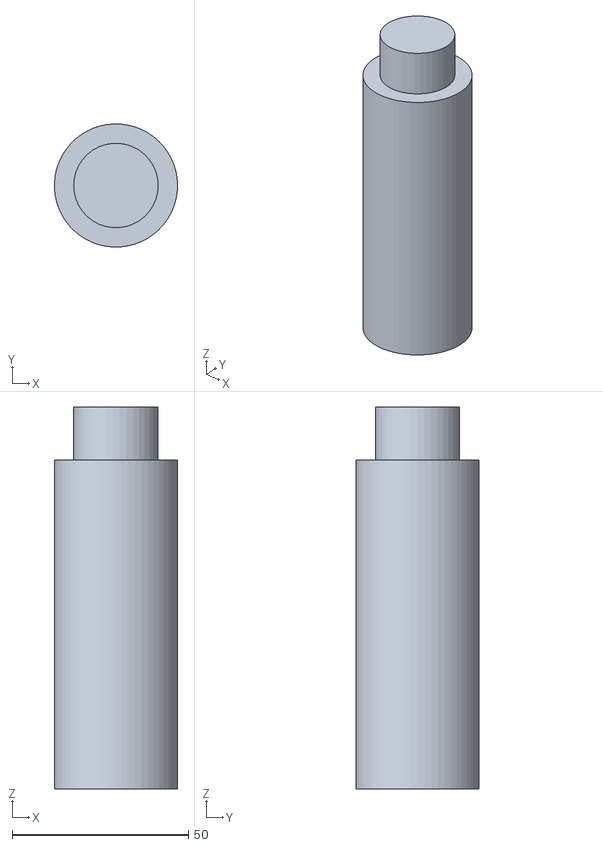
[picture p38: CAD file, 2010-05-12]
users/hoeken/openscad/tp-holder/inner-tube.stl
35.0 x 35.0 x 108.5
