jmil/makerbot/users/hoeken/openscad/wavy-shelf/strut-profile.dxf

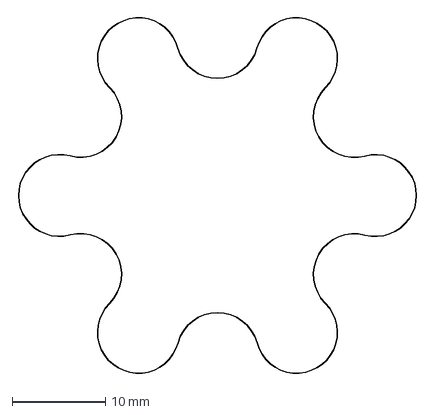
[picture p39: CAD file, 2010-05-12]
users/hoeken/openscad/wavy-shelf/strut-profile.dxf
43.2 x 38.5 mm
