jmil/makerbot/users/hoeken/parabola/foo.dxf

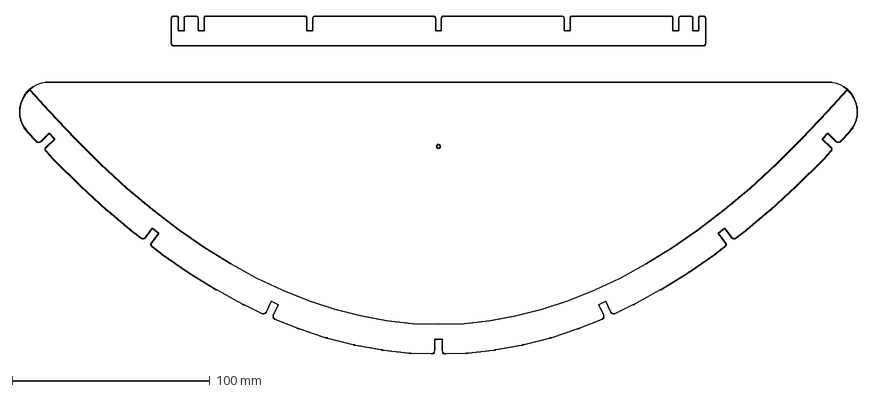
[picture p40: CAD file, 2010-04-15]
users/hoeken/parabola/foo.dxf
426.9 x 170.8 mm
