jmil/makerbot/users/hoeken/plastruder-mk6/sketch2.dxf

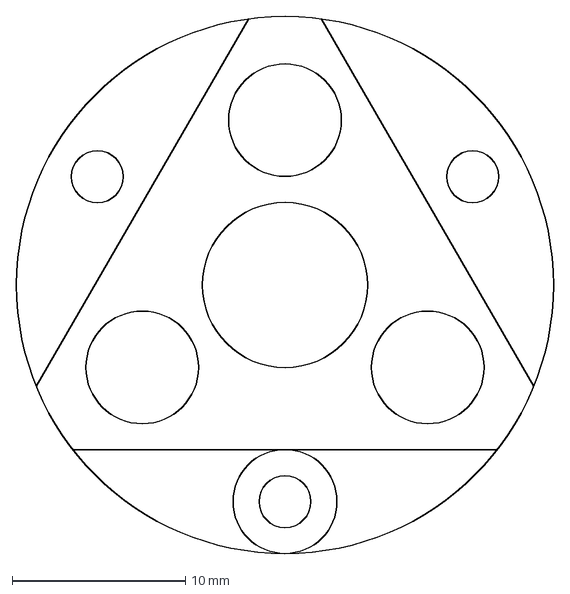
[picture p41: CAD file, 2010-05-12]
users/hoeken/plastruder-mk6/sketch2.dxf
31.0 x 31.0 mm
