jmil/makerbot/users/hoeken/plastruder-twindrive/totem-pole.dxf

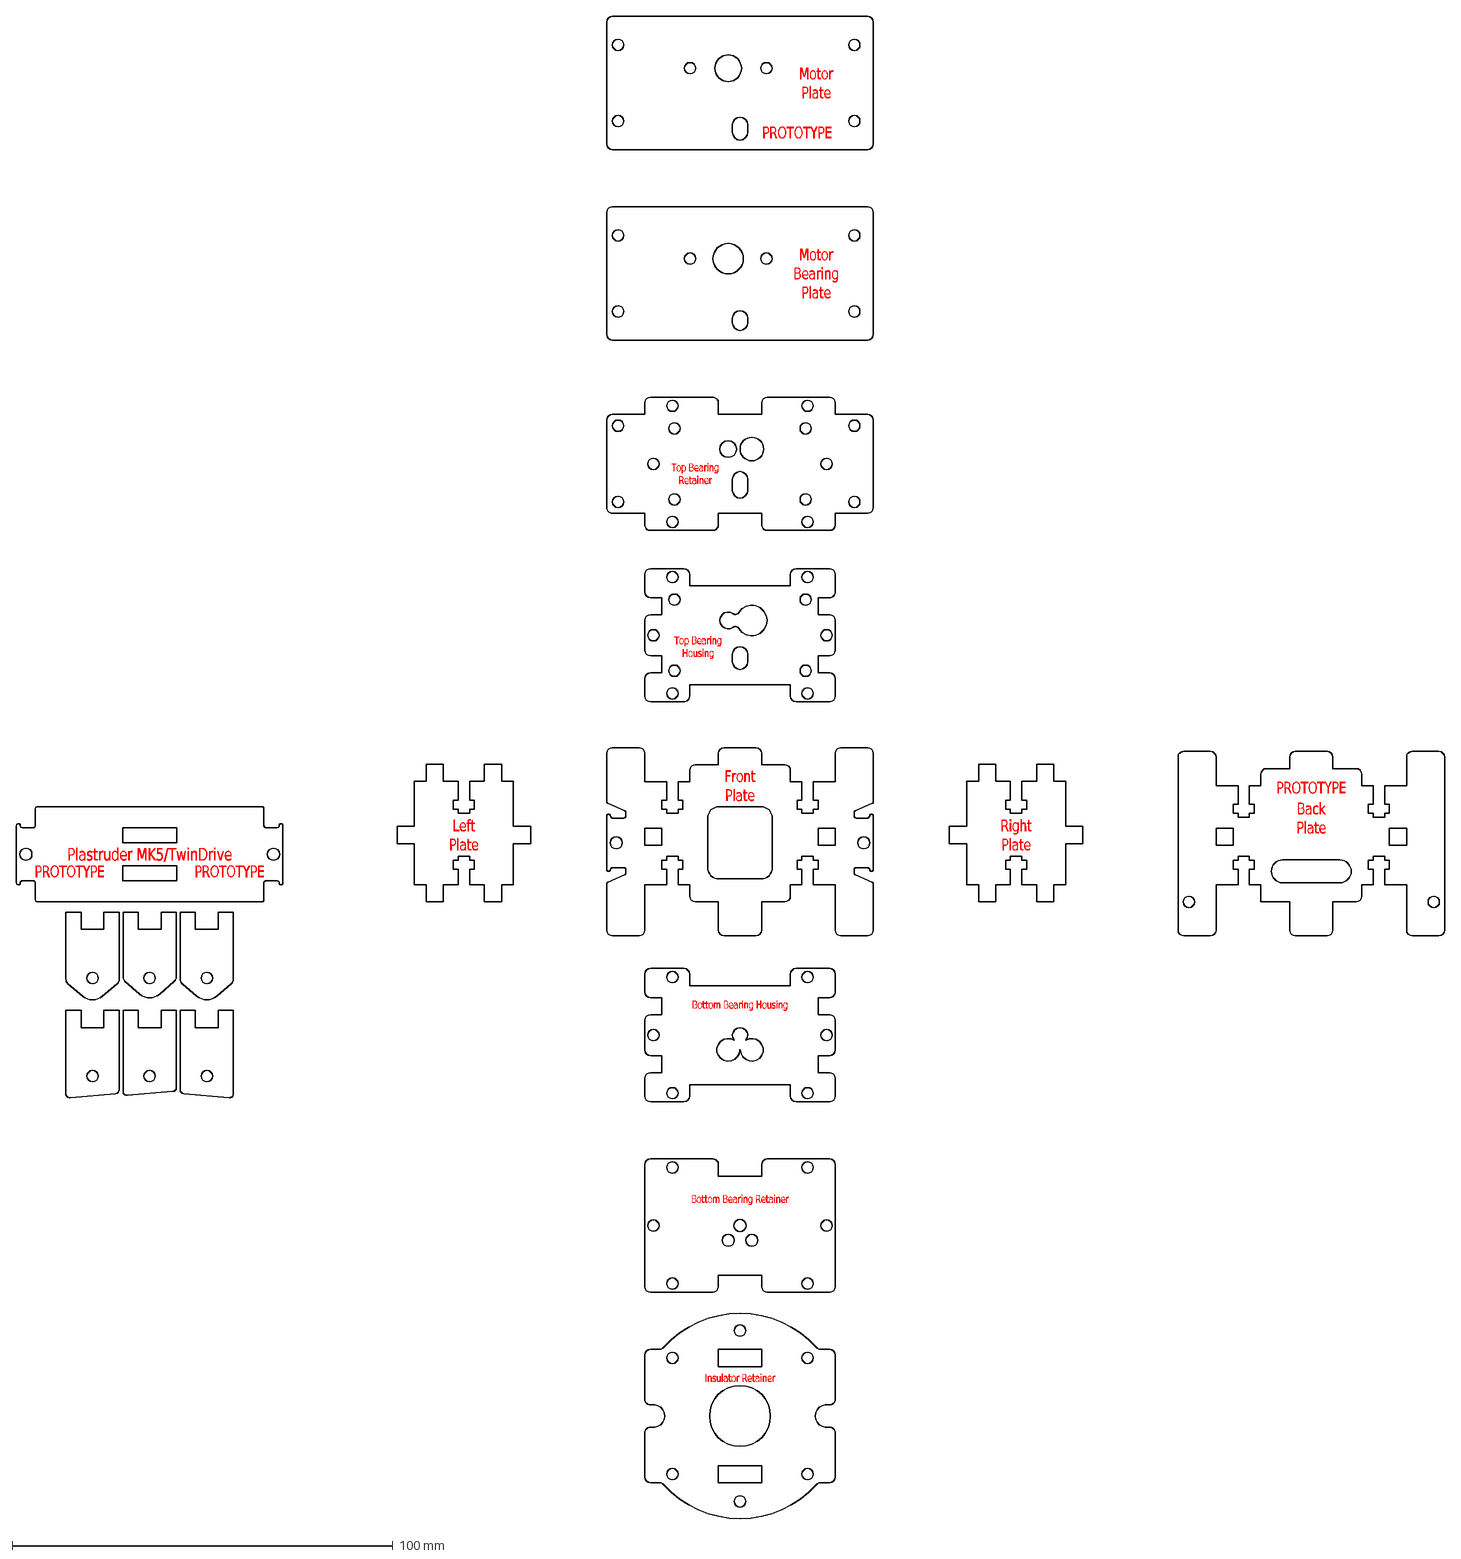
[picture p42: CAD file, 2009-10-12]
users/hoeken/plastruder-twindrive/totem-pole.dxf
Left Plate
Right Plate
Bottom\~Bearing\~Housing
Bottom\~Bearing\~Retainer
Insulator\~Retainer
Back Plate
Front Plate
Motor Plate
Motor Bearing Plate
Top\~Bearing Retainer
Top\~Bearing Housing
PROTOTYPE
Plastruder\~MK5/TwinDrive
