jmil/makerbot/users/hoeken/spindle/spindle.dxf

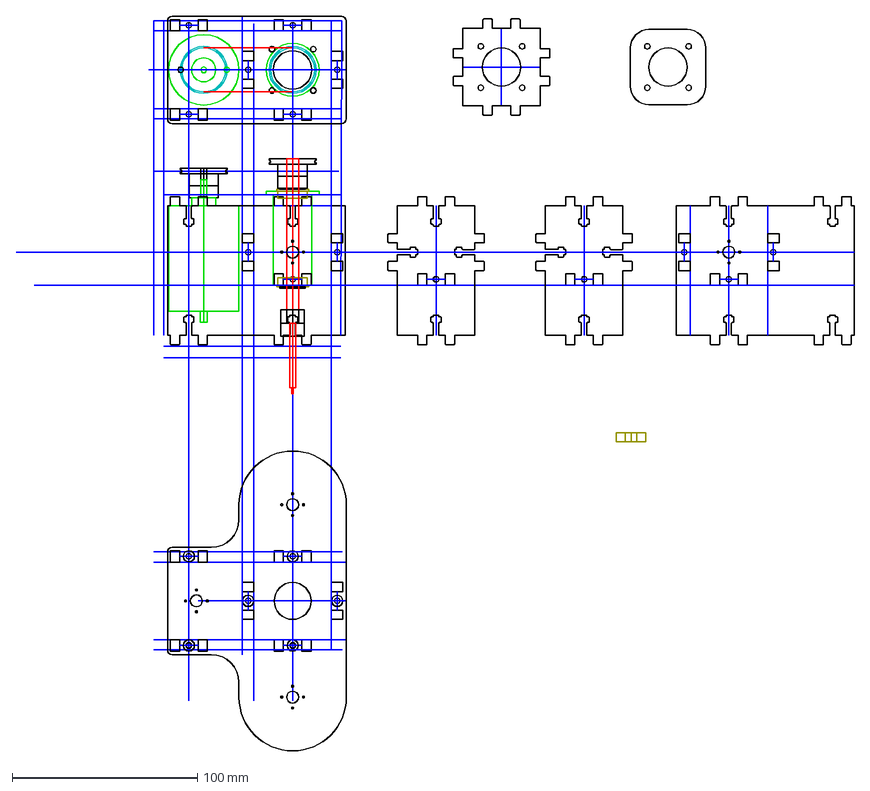
[picture p43: CAD file, 2010-08-06]
users/hoeken/spindle/spindle.dxf
452.9 x 397.0 mm
