jmil/makerbot/users/hoeken/templates/nema-17-gasket-layout.dxf

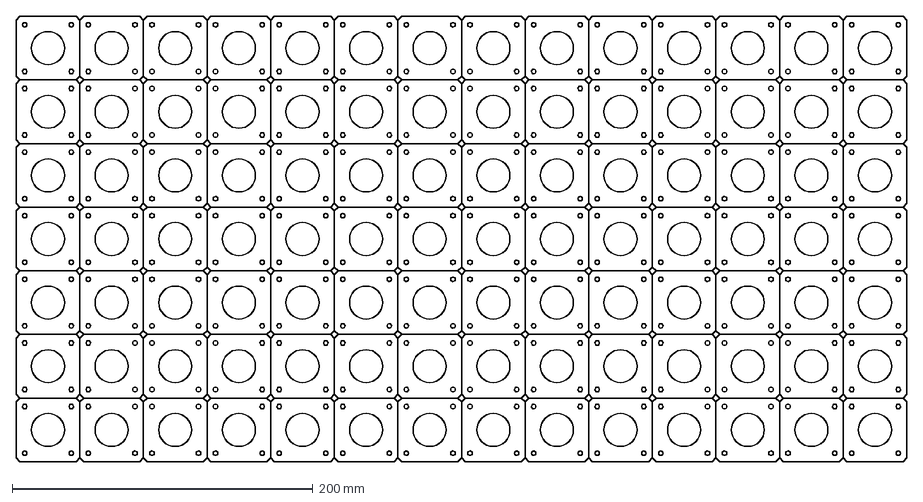
[picture p44: CAD file, 2010-07-13]
users/hoeken/templates/nema-17-gasket-layout.dxf
592.2 x 296.1 mm
