jmil/makerbot/users/hoeken/test-rigs/3mm-kerf-tester.dxf

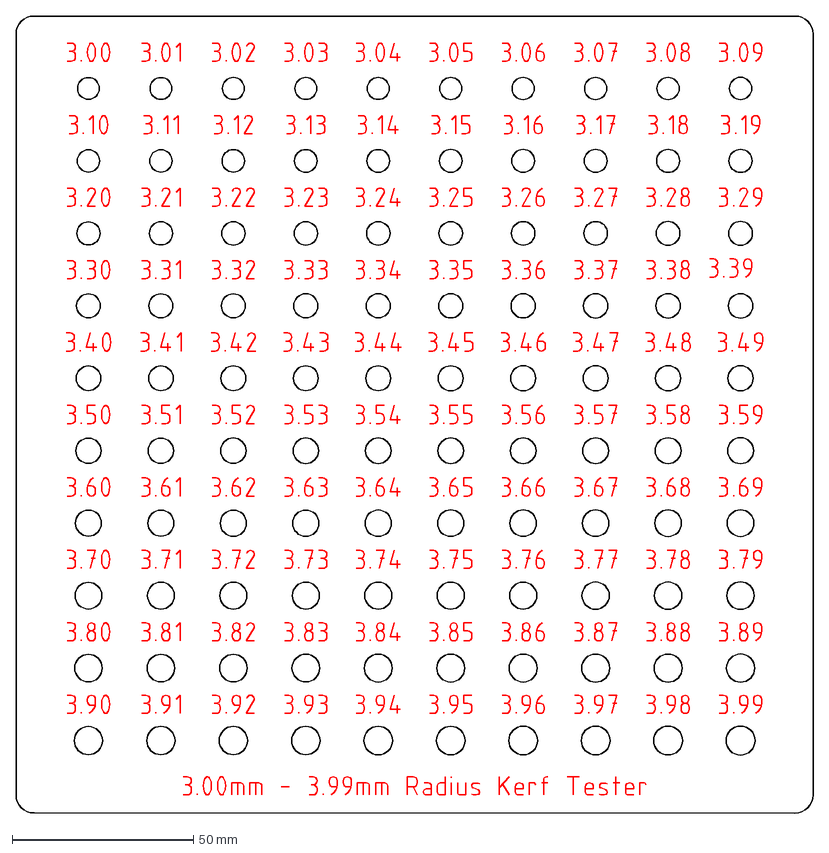
[picture p45: CAD file, 2010-06-17]
users/hoeken/test-rigs/3mm-kerf-tester.dxf
220.0 x 220.0 mm
