jmil/makerbot/users/phooky/rigs/endstop test rig.dxf

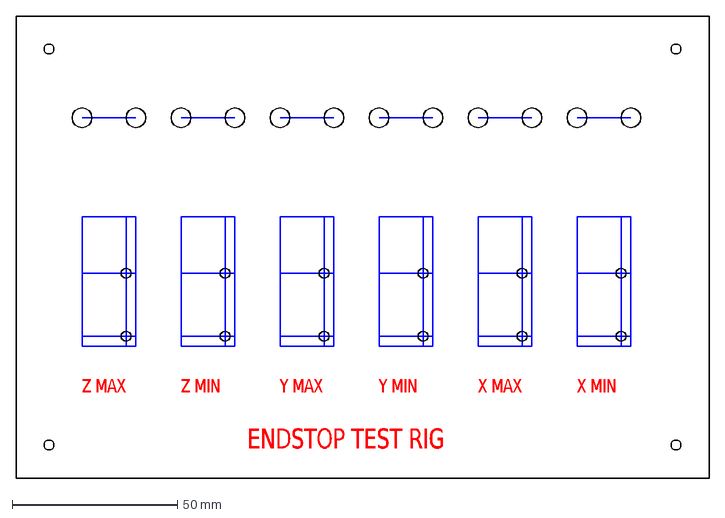
[picture p46: CAD file, 2010-04-07]
users/phooky/rigs/endstop test rig.dxf
Z\~MAX
Z\~MIN
Y\~MIN
X\~MIN
X\~MAX
Y\~MAX
ENDSTOP\~TEST\~RIG
