jmil/makerbot/tags/cupcake-cnc-batch-3-4/build-surface-2.5mm.dxf

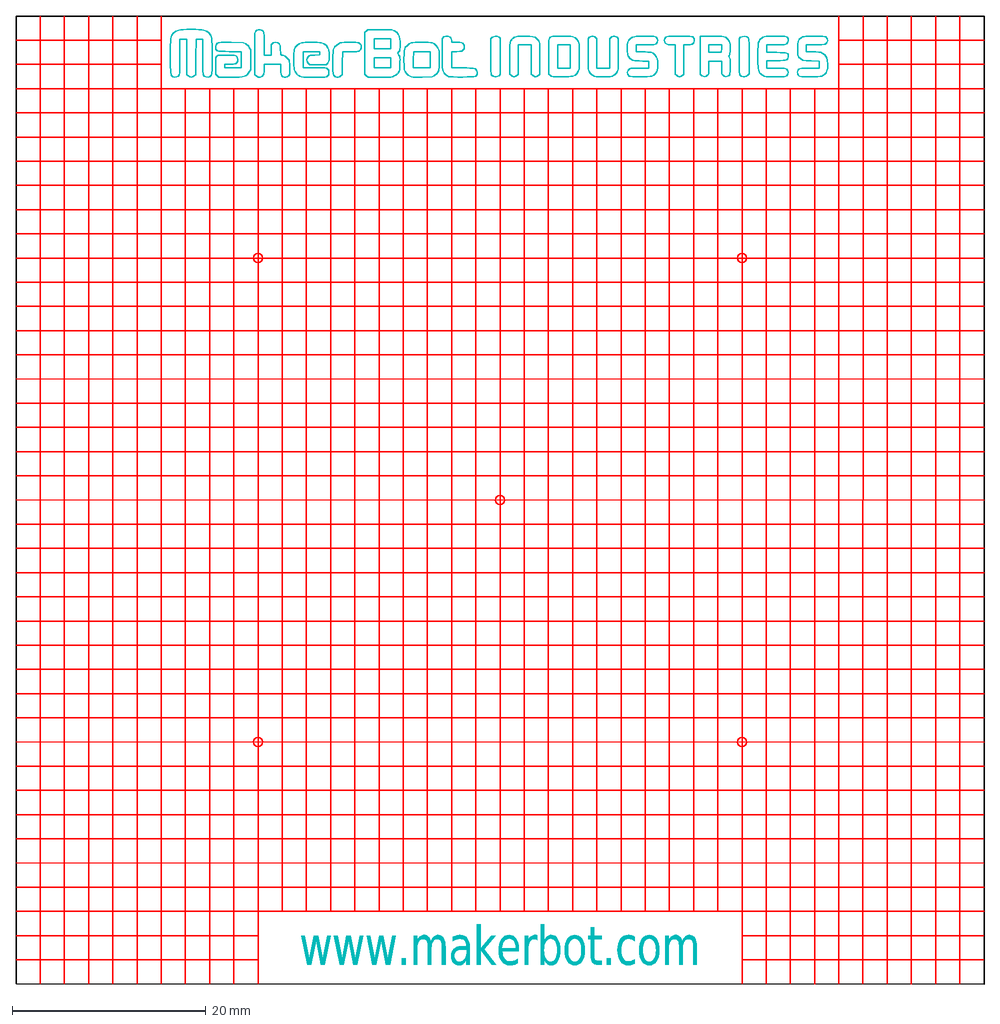
[picture p47: CAD file, 2009-05-20]
tags/cupcake-cnc-batch-3-4/build-surface-2.5mm.dxf
www.makerbot.com
