jmil/makerbot/tags/cupcake-cnc-batch-3-4/cutting_layouts/cupcake-xy-layout.dxf

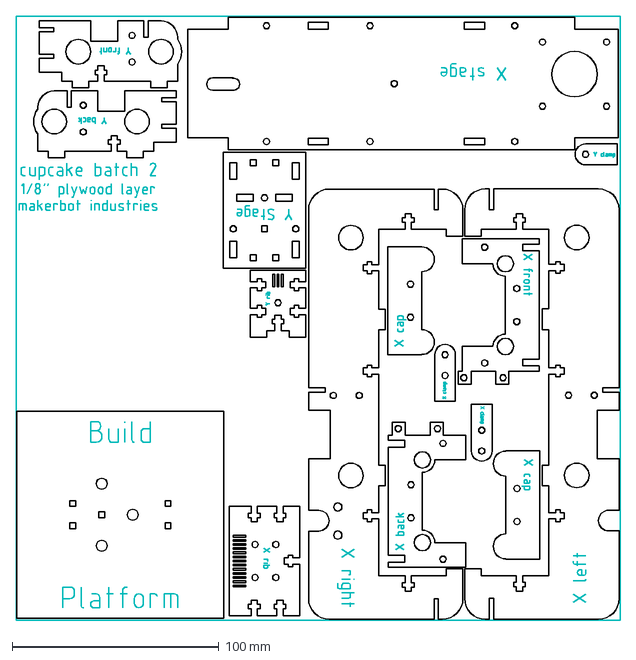
[picture p48: CAD file, 2009-05-19]
tags/cupcake-cnc-batch-3-4/cutting_layouts/cupcake-xy-layout.dxf
292.0 x 292.0 mm
