jmil/makerbot/tags/filament-spindle-mk1/layout.dxf

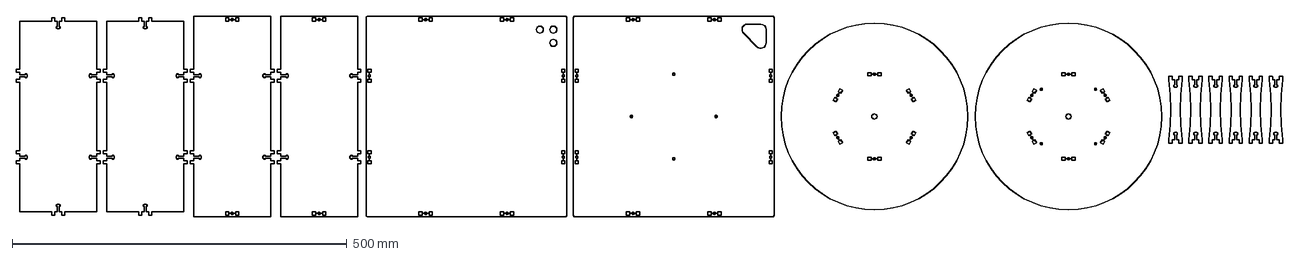
[picture p49: CAD file, 2010-05-10]
tags/filament-spindle-mk1/layout.dxf
1892.5 x 300.0 mm
