jmil/makerbot/tags/frostruder-mk2/frostruder.dxf

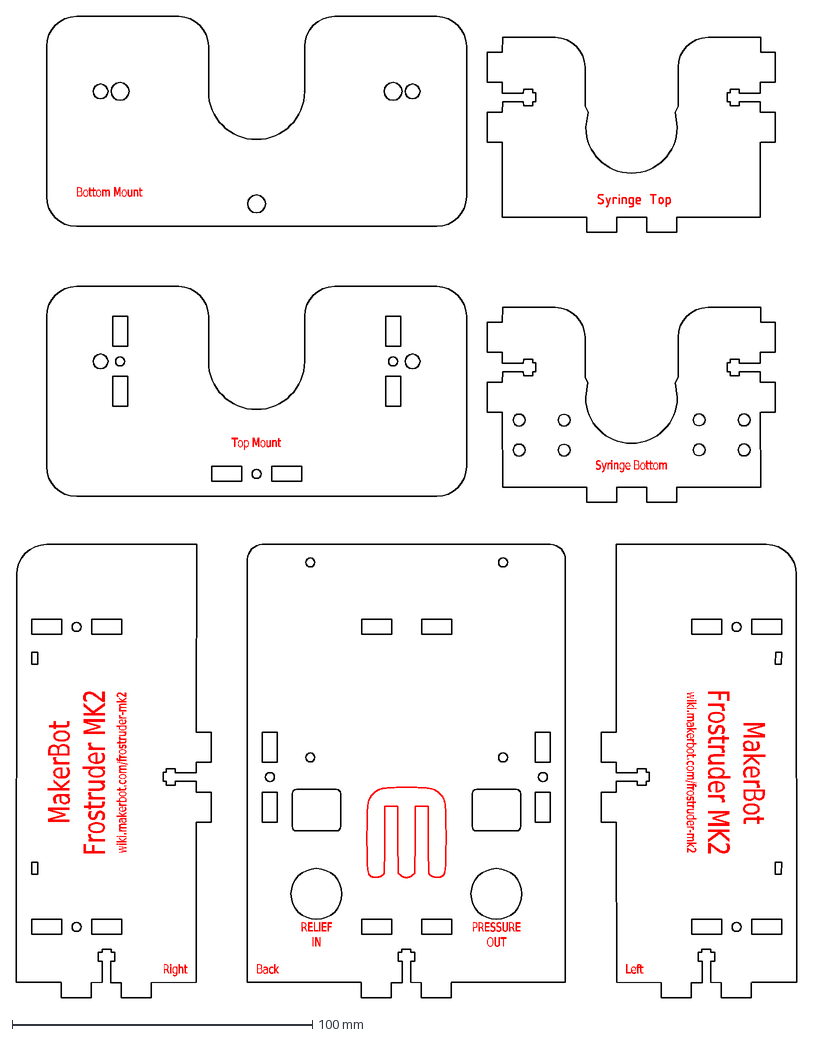
[picture p50: CAD file, 2009-11-02]
tags/frostruder-mk2/frostruder.dxf
Bottom\~Mount
Top\~Mount
RELIEF IN
PRESSURE OUT
MakerBot Frostruder\~MK2
wiki.makerbot.com/frostruder-mk2
Syringe\~Bottom
Left
Back
Right
