jmil/makerbot/tags/plastruder-mk5/filament-drive/layout-acrylic.dxf

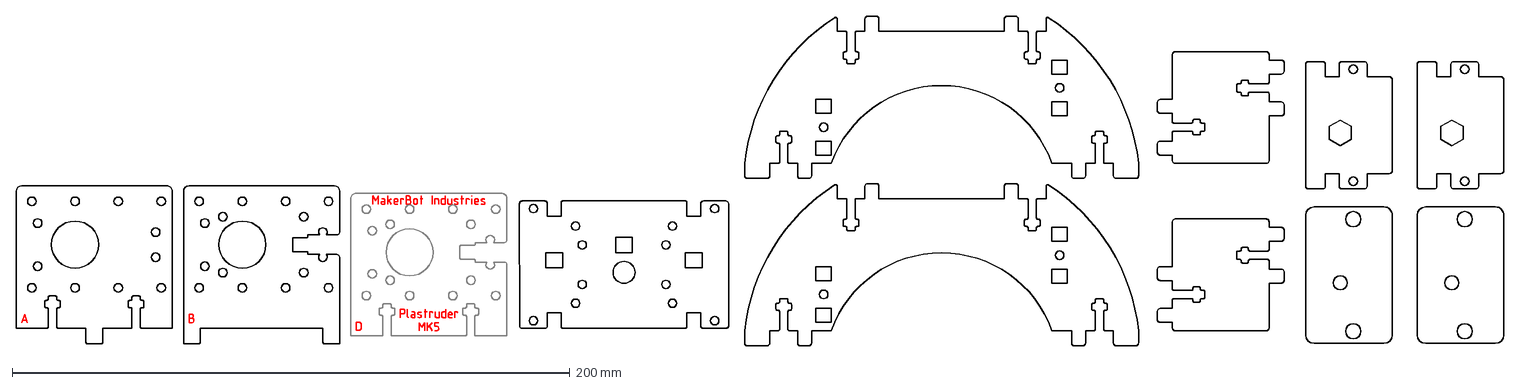
[picture p51: CAD file, 2010-05-28]
tags/plastruder-mk5/filament-drive/layout-acrylic.dxf
533.5 x 118.2 mm
