jmil/makerbot/tags/plastruder-mk5/hot-end/nozzle.dxf

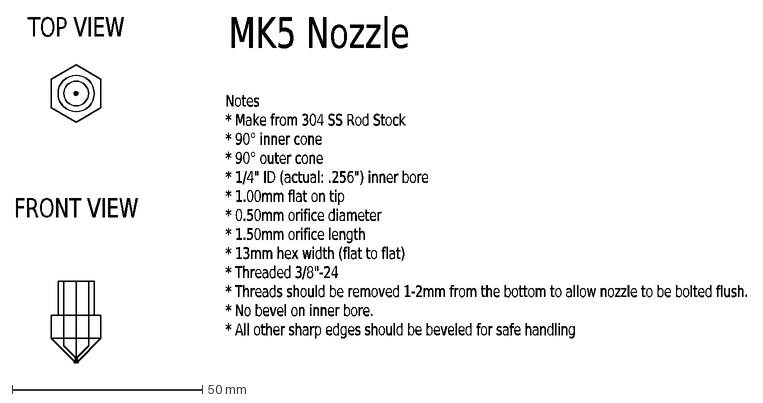
[picture p52: CAD file, 2010-05-24]
tags/plastruder-mk5/hot-end/nozzle.dxf
FRONT\~VIEW
TOP\~VIEW
MK5\~Nozzle
Notes *\~Make\~from\~304\~SS\~Rod\~Stock *\~90°\~inner\~cone *\~90°\~outer\~cone *\~1/4"\~ID\~(actual:\~.256")\~inner\~bore *\~1.00mm\~flat\~on\~tip *\~0.50mm\~
