jmil/makerbot/trunk/cupcake/idler-pulley-606-cut.dxf

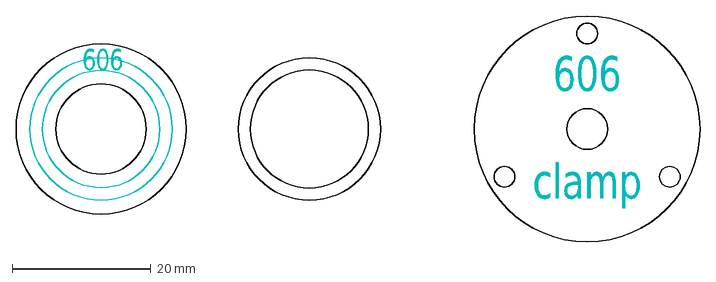
[picture p53: CAD file, 2009-04-04]
trunk/cupcake/idler-pulley-606-cut.dxf
606
clamp
