jmil/makerbot/trunk/cupcake/lasercut-parts/y-stage/kapton-diecut.dxf

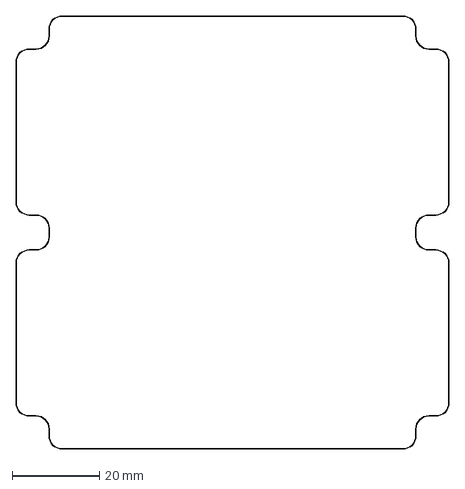
[picture p55: CAD file, 2010-03-05]
trunk/cupcake/lasercut-parts/y-stage/kapton-diecut.dxf
99.0 x 99.0 mm
