jmil/makerbot/trunk/filament-spindle/filament-spindle.dxf

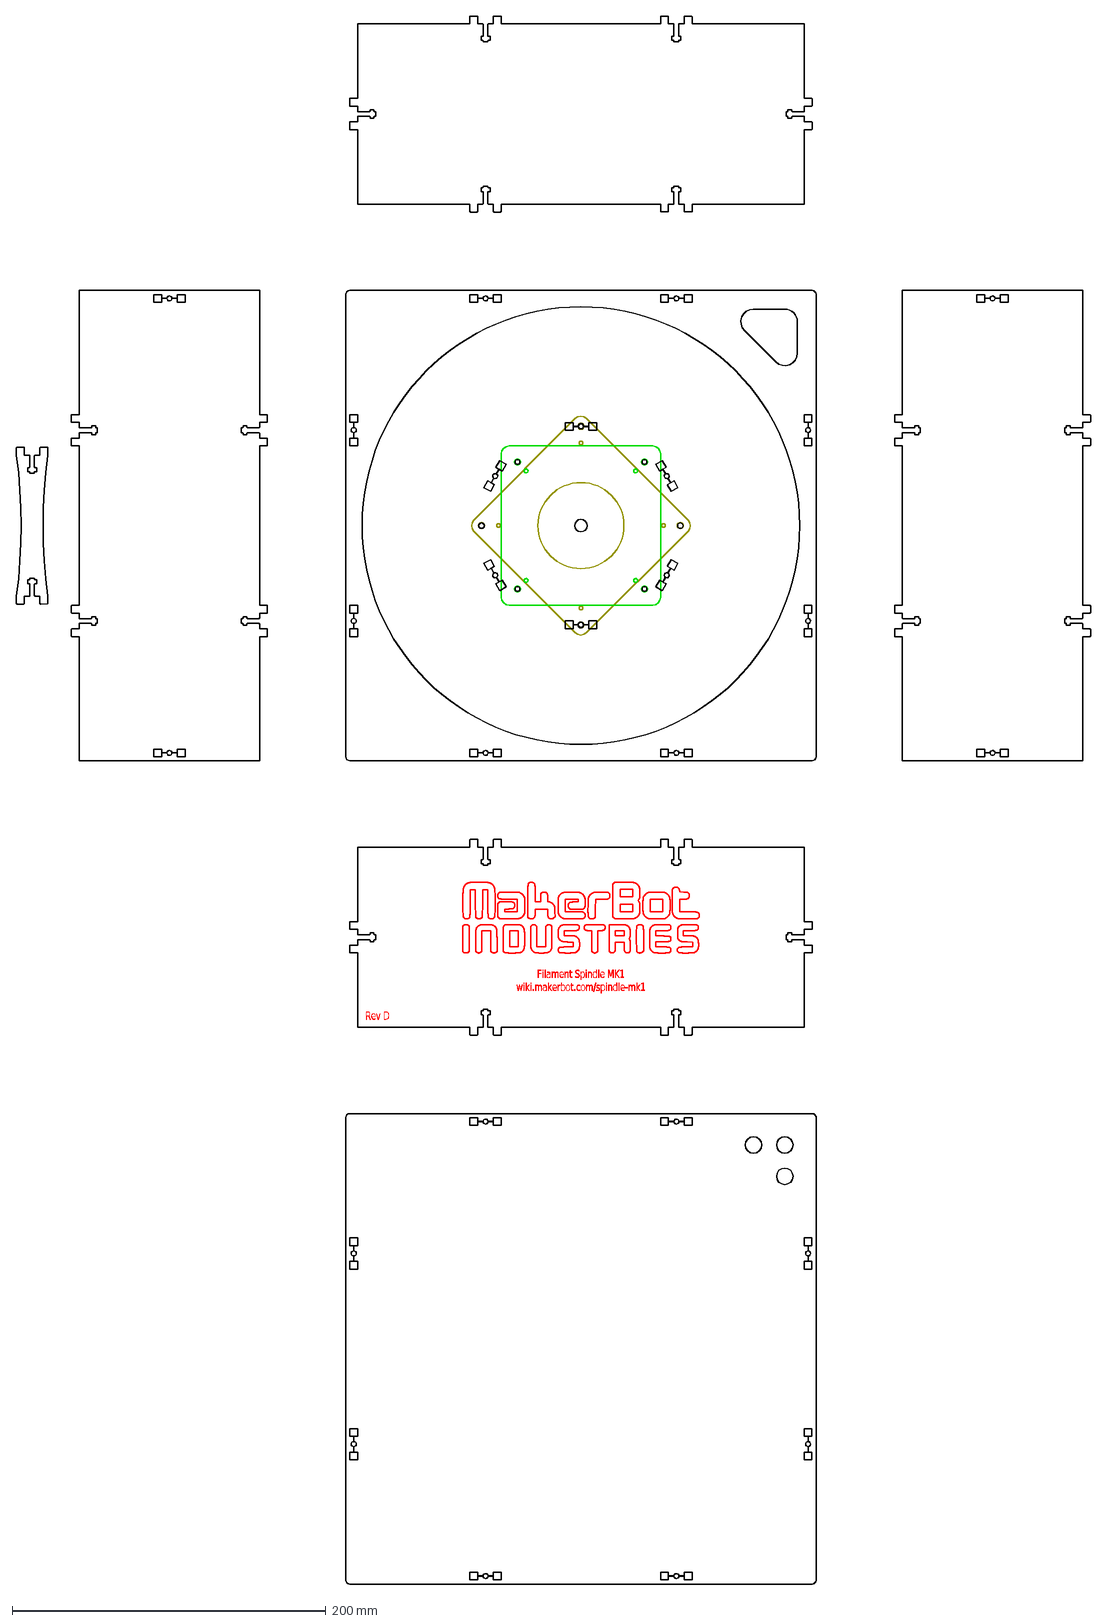
[picture p56: CAD file, 2010-05-14]
trunk/filament-spindle/filament-spindle.dxf
Rev\~D
Filament\~Spindle\~MK1 wiki.makerbot.com/spindle-mk1
