jmil/makerbot/trunk/frostruder/frostruder.dxf

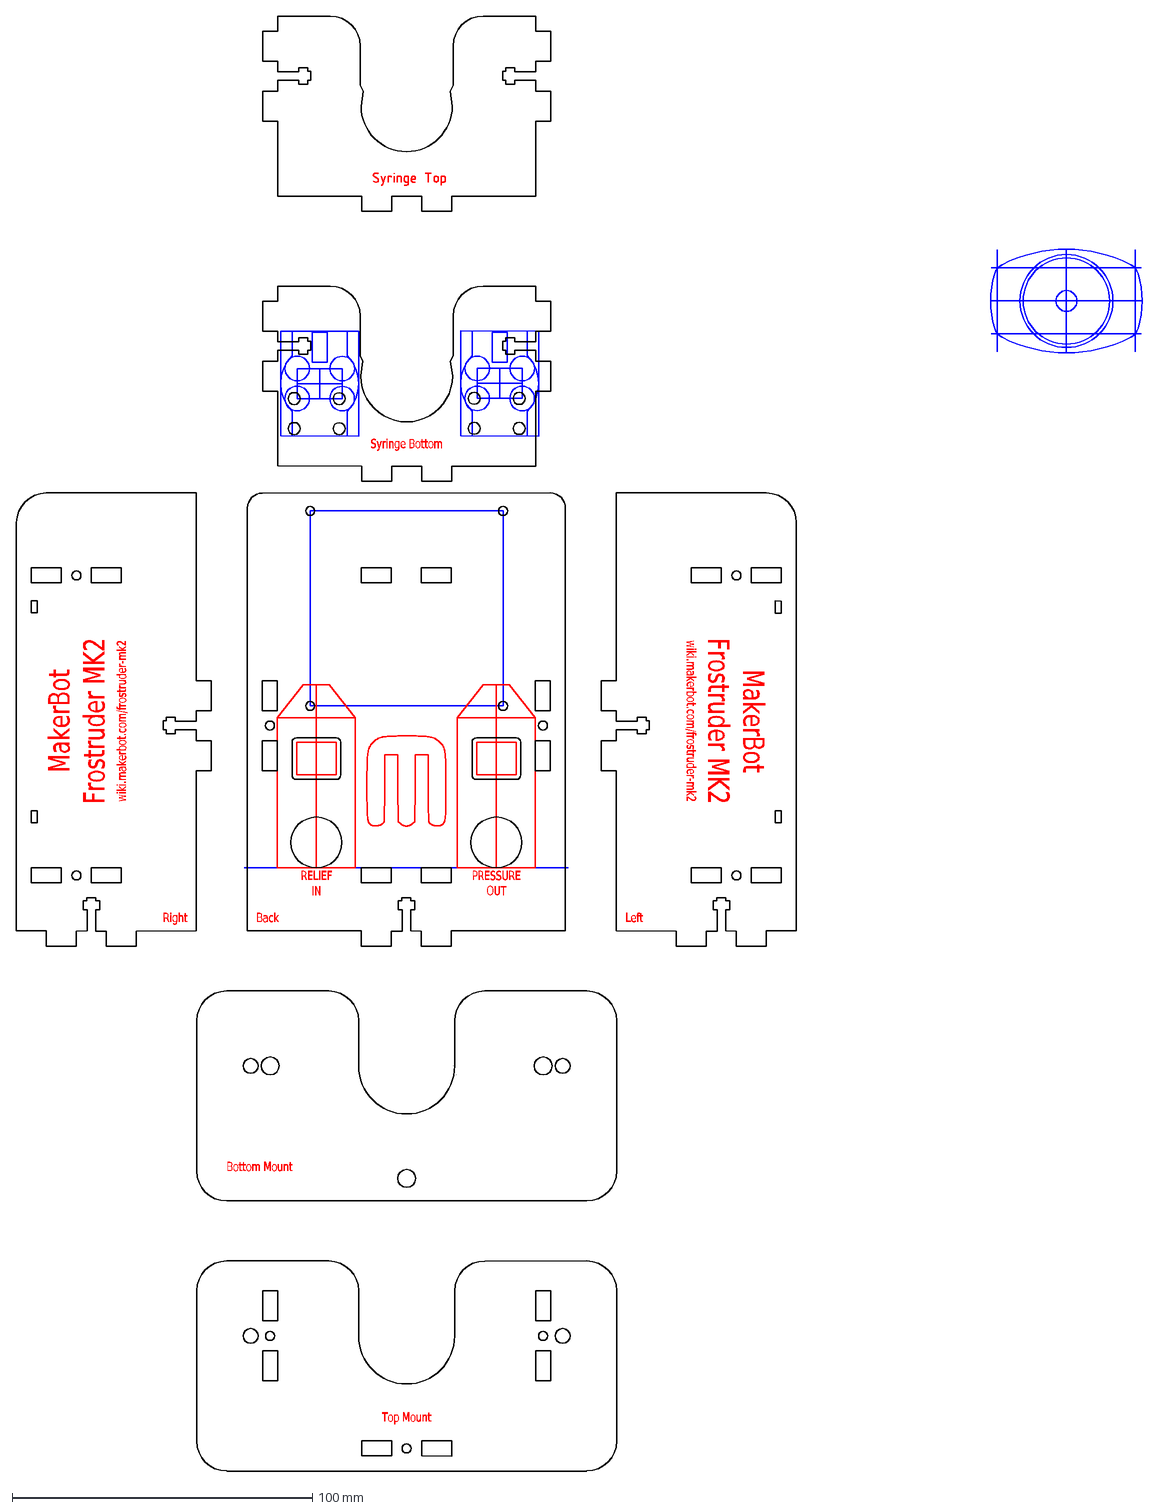
[picture p57: CAD file, 2009-11-16]
trunk/frostruder/frostruder.dxf
RELIEF IN
PRESSURE OUT
MakerBot Frostruder\~MK2
wiki.makerbot.com/frostruder-mk2
Left
Back
Right
Bottom\~Mount
Top\~Mount
Syringe\~Bottom
