jmil/makerbot/trunk/makerscan/makerscanbody.dxf

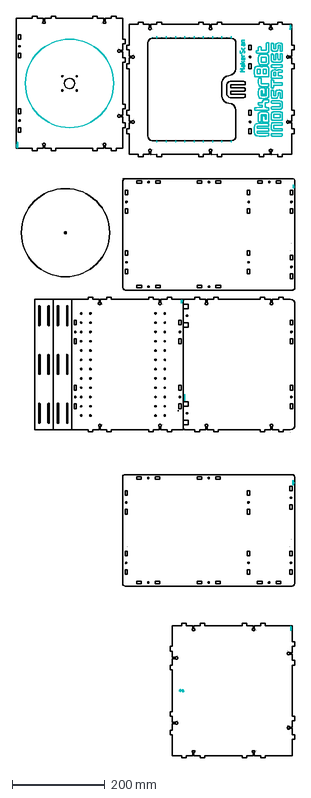
[picture p58: CAD file, 2009-06-14]
trunk/makerscan/makerscanbody.dxf
600.0 x 1597.0 mm
