jmil/makerbot/users/charles/bowden/bowden-layout.dxf

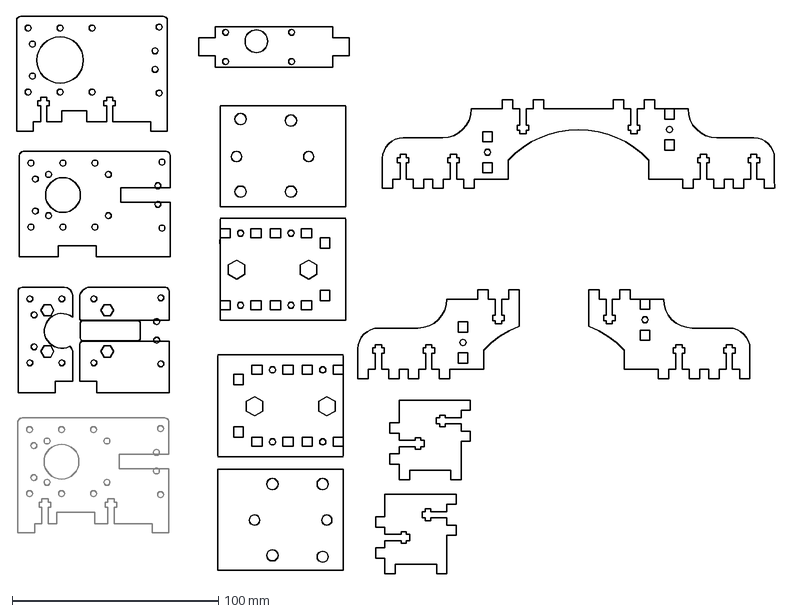
[picture p59: CAD file, 2010-03-23]
users/charles/bowden/bowden-layout.dxf
367.4 x 270.0 mm
