jmil/makerbot/users/charles/conveyor/bend-test.dxf

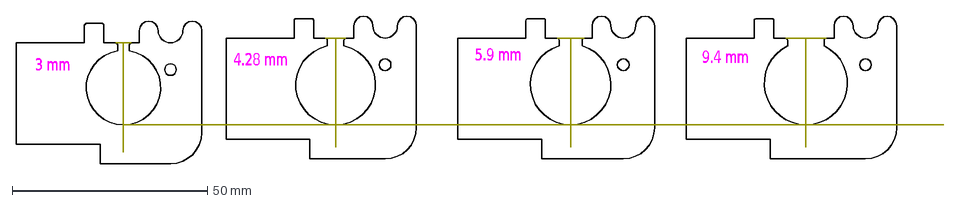
[picture p60: CAD file, 2010-05-13]
users/charles/conveyor/bend-test.dxf
3\~mm
4.28\~mm
5.9\~mm
9.4\~mm
