jmil/makerbot/users/charles/paxtruder/Paxtruder-0.3.dxf

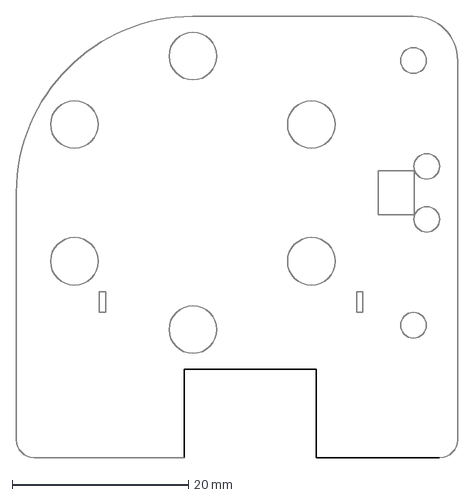
[picture p61: CAD file, 2010-02-21]
users/charles/paxtruder/Paxtruder-0.3.dxf
50.0 x 50.0 mm
