jmil/makerbot/users/charles/relay-adapter/relay-driver-adapter.dxf

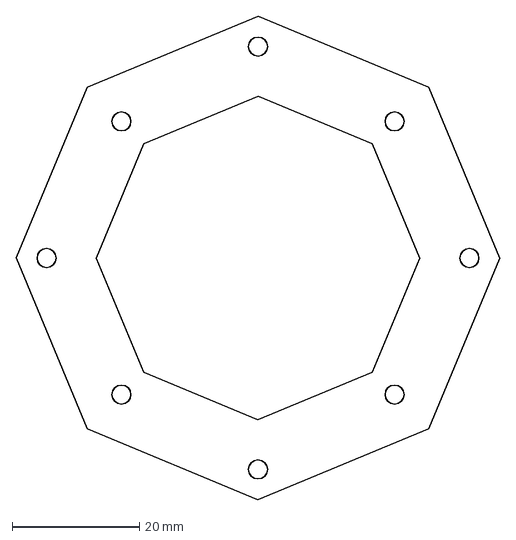
[picture p62: CAD file, 2010-09-17]
users/charles/relay-adapter/relay-driver-adapter.dxf
76.0 x 76.0 mm
