jmil/makerbot/users/charles/test-rigs/motherboard-test-rig.dxf

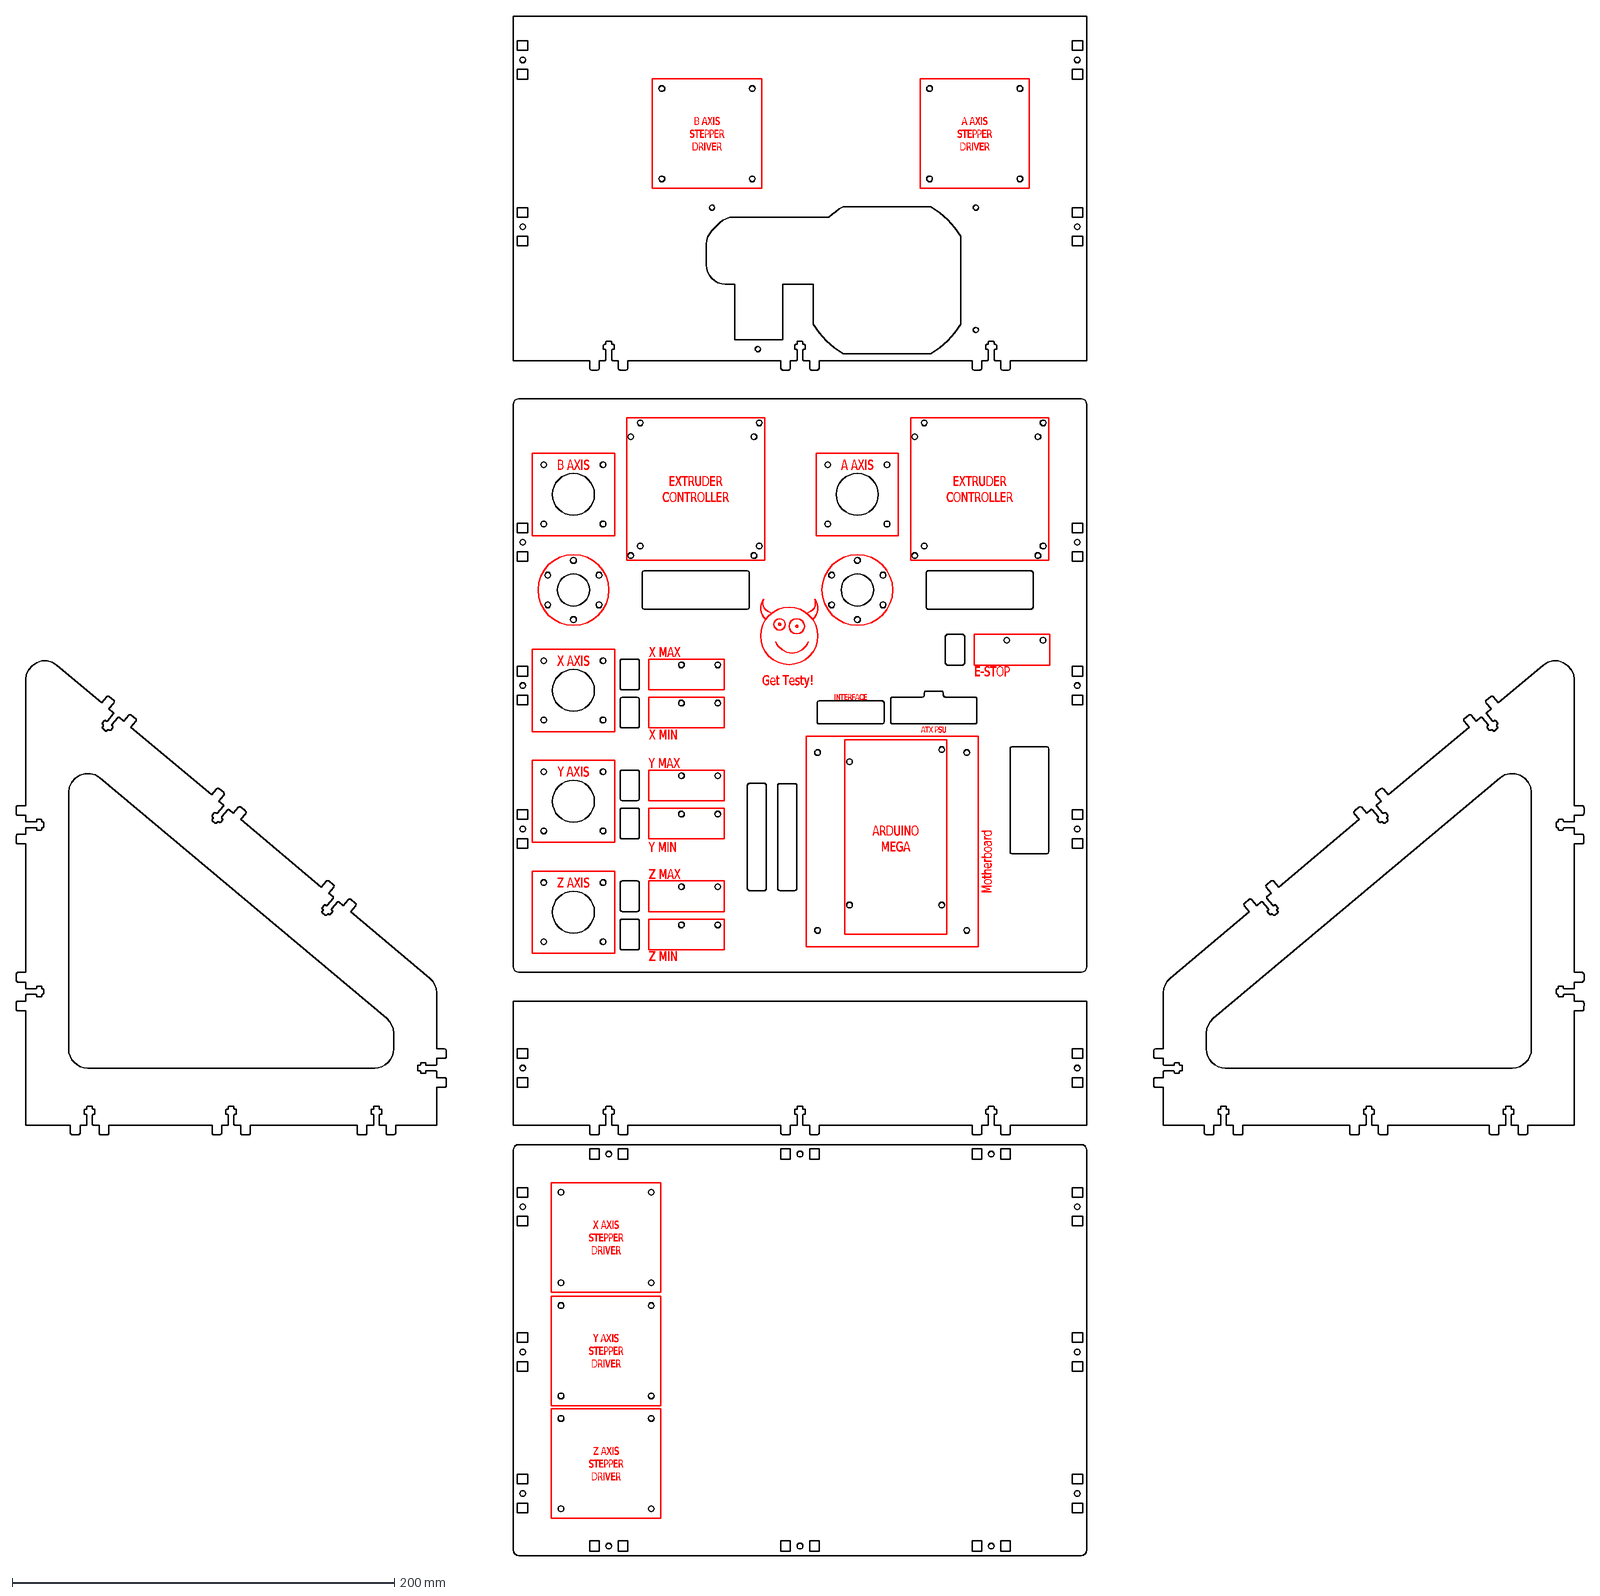
[picture p63: CAD file, 2010-10-28]
users/charles/test-rigs/motherboard-test-rig.dxf
X\~AXIS
Y\~AXIS
Z\~AXIS
X\~MAX
X\~MIN
Y\~MAX
Y\~MIN
Z\~MAX
Z\~MIN
EXTRUDER CONTROLLER
ARDUINO MEGA
Motherboard
ATX\~PSU
INTERFACE
Get\~Testy!
Y\~AXIS STEPPER DRIVER
Z\~AXIS STEPPER DRIVER
X\~AXIS STEPPER DRIVER
B\~AXIS STEPPER DRIVER
A\~AXIS STEPPER DRIVER
B\~AXIS
A\~AXIS
E-STOP
