jmil/makerbot/users/hoeken/art/harshicord.dxf

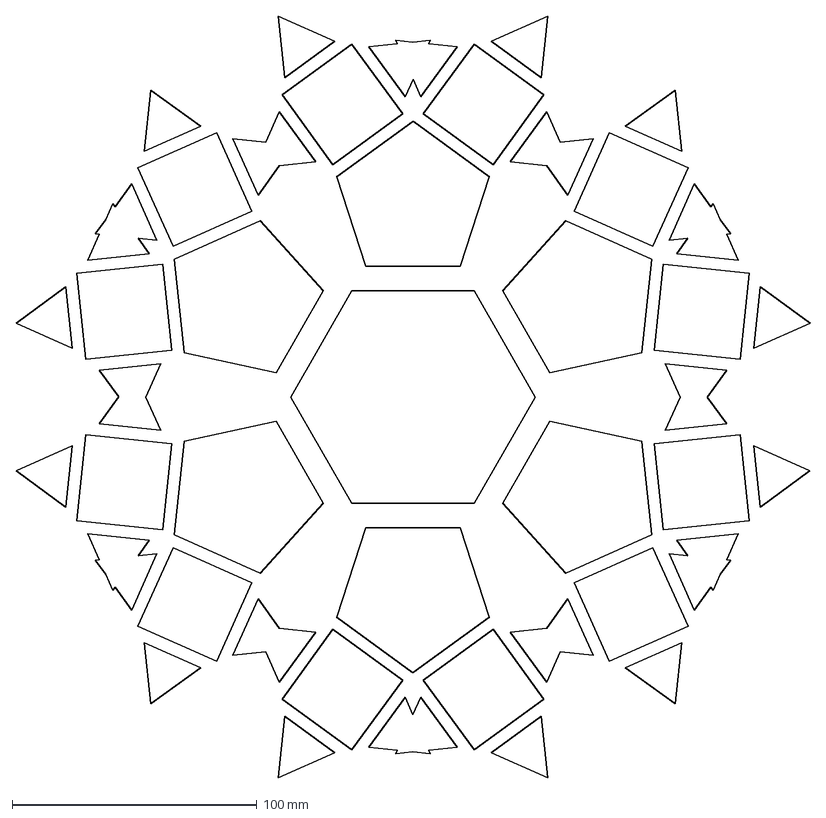
[picture p64: CAD file, 2010-05-12]
users/hoeken/art/harshicord.dxf
324.1 x 310.8 mm
