jmil/makerbot/users/hoeken/makerwave/y-axis.dxf

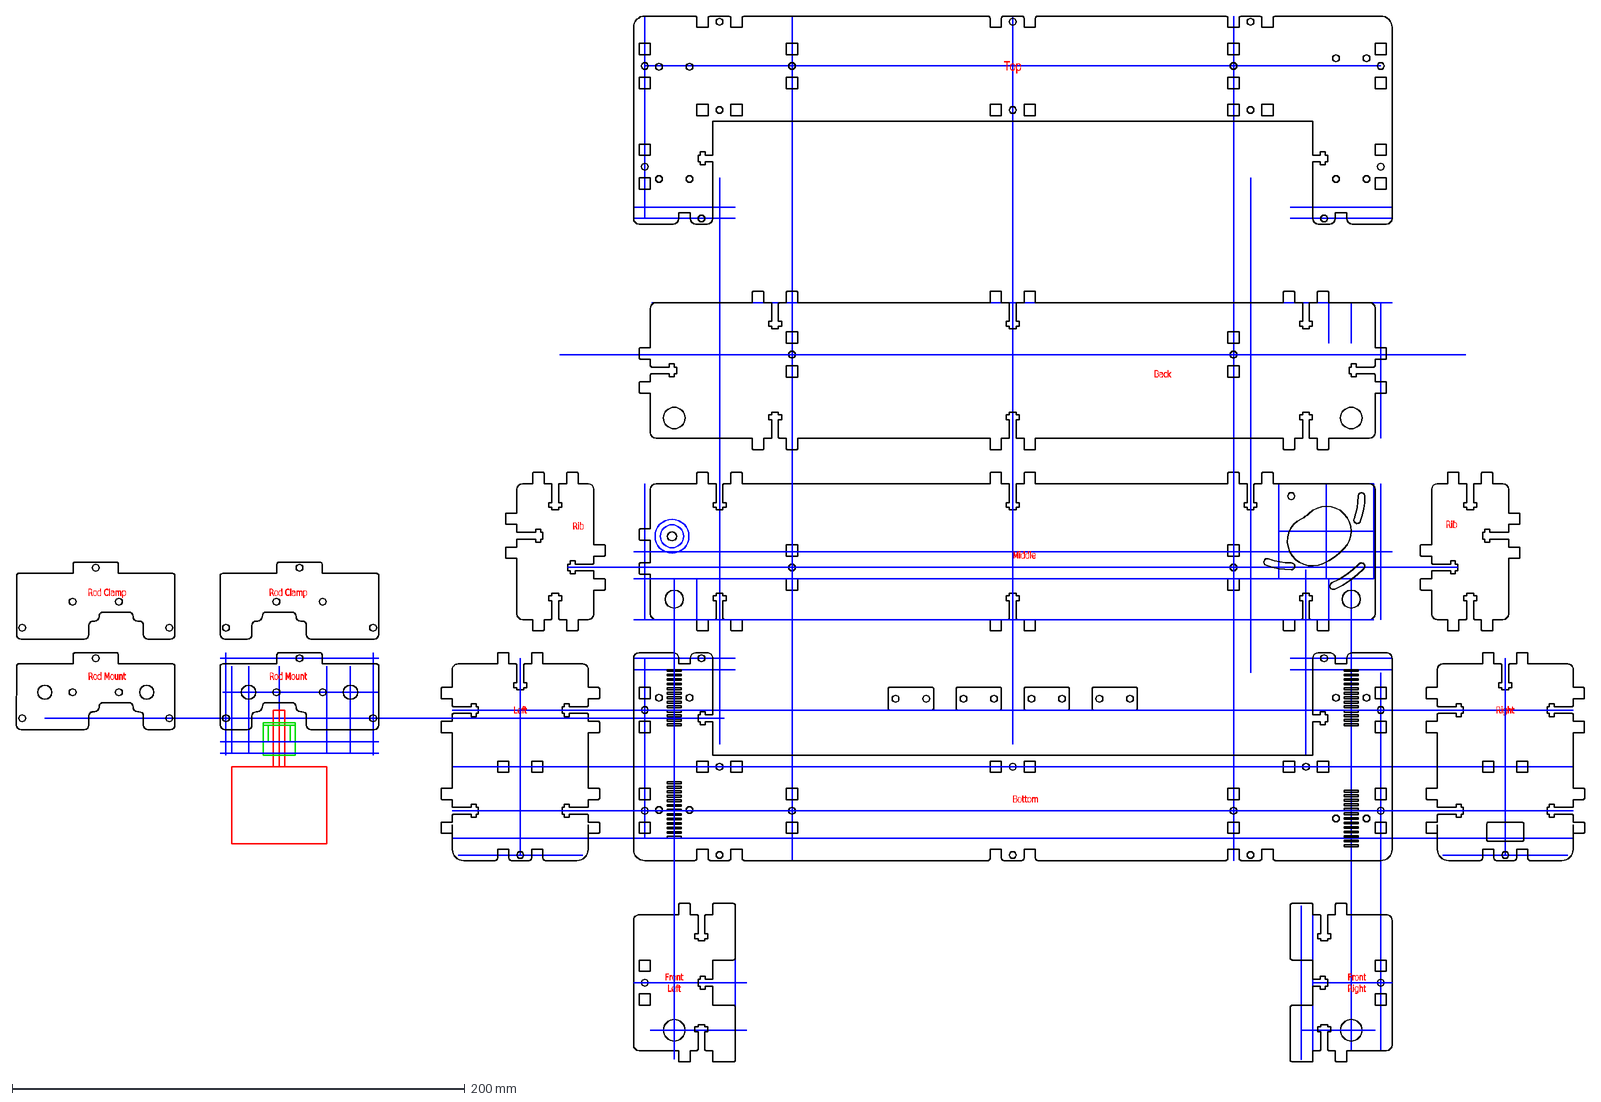
[picture p65: CAD file, 2009-12-15]
users/hoeken/makerwave/y-axis.dxf
Middle
Bottom
Left
Right
Rib
Front Left
Rod\~Mount
Rod\~Clamp
Front Right
Back
Top
