jmil/makerbot/users/hoeken/openscad/botcube/m.dxf

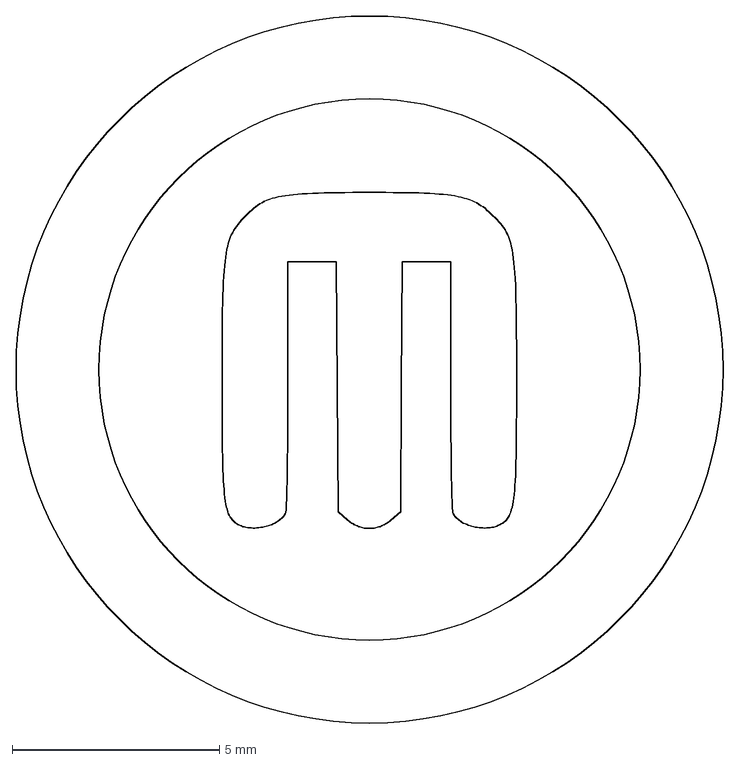
[picture p66: CAD file, 2010-05-23]
users/hoeken/openscad/botcube/m.dxf
17.0 x 17.0 mm
