jmil/makerbot/users/hoeken/openscad/tp-holder/arm.stl

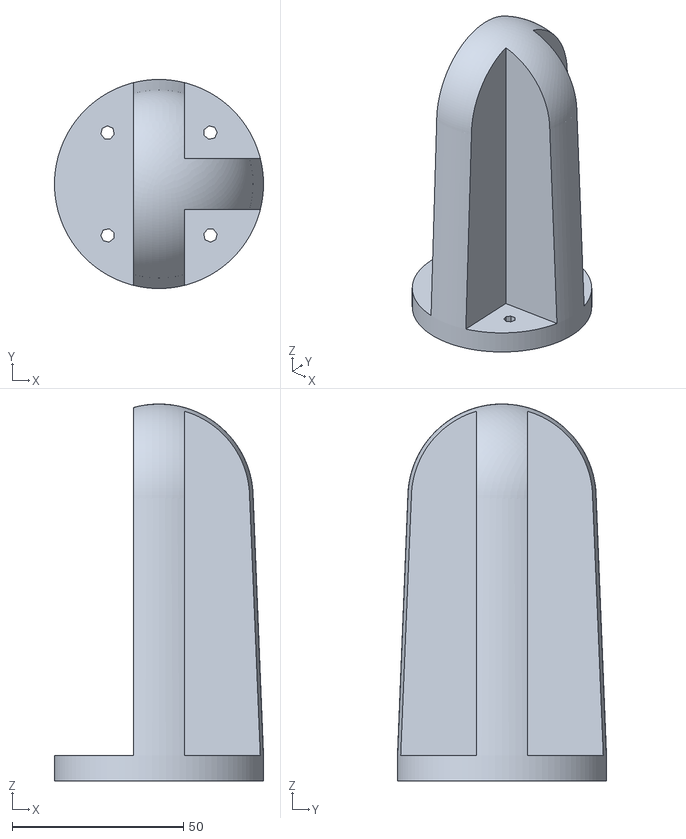
[picture p67: CAD file, 2010-05-12]
users/hoeken/openscad/tp-holder/arm.stl
61.0 x 61.0 x 110.0
