jmil/makerbot/users/hoeken/parabola/sheet-3.dxf

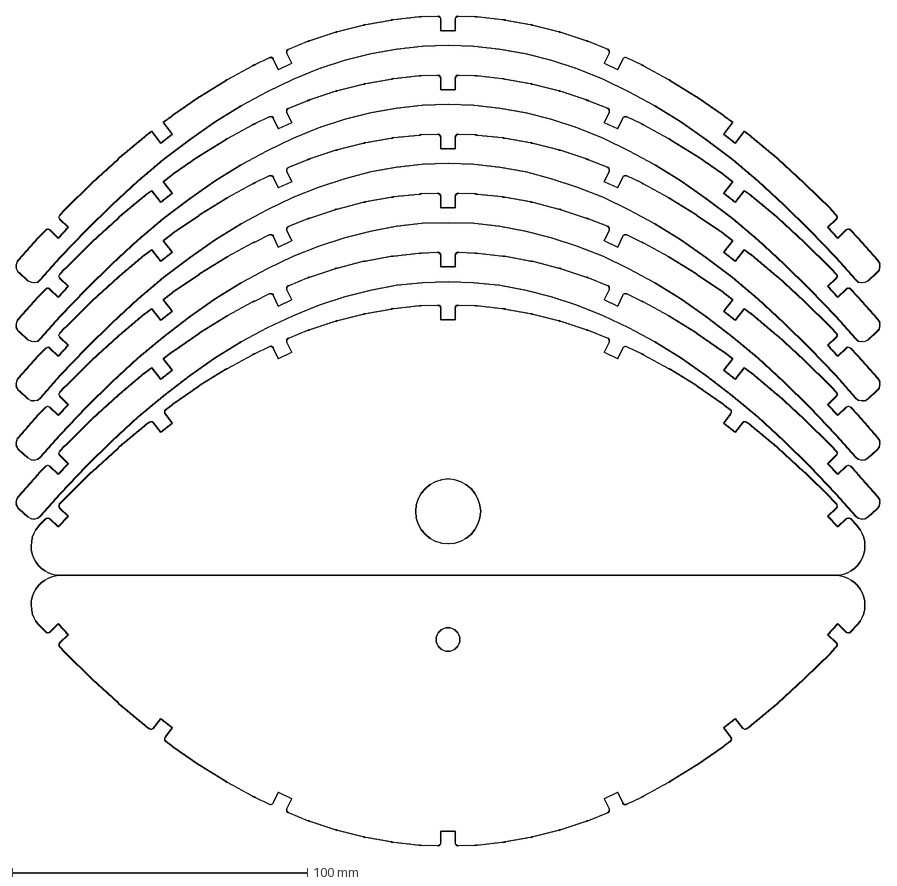
[picture p68: CAD file, 2010-04-11]
users/hoeken/parabola/sheet-3.dxf
292.9 x 280.9 mm
