jmil/makerbot/users/hoeken/plastruder-mk6/sketch1.dxf

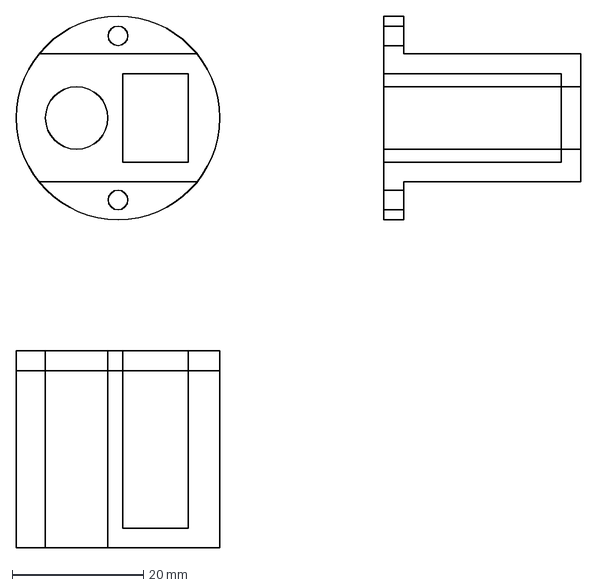
[picture p69: CAD file, 2010-05-12]
users/hoeken/plastruder-mk6/sketch1.dxf
86.0 x 81.0 mm
