jmil/makerbot/users/hoeken/plastruder-printable/insulator-retainer.dxf

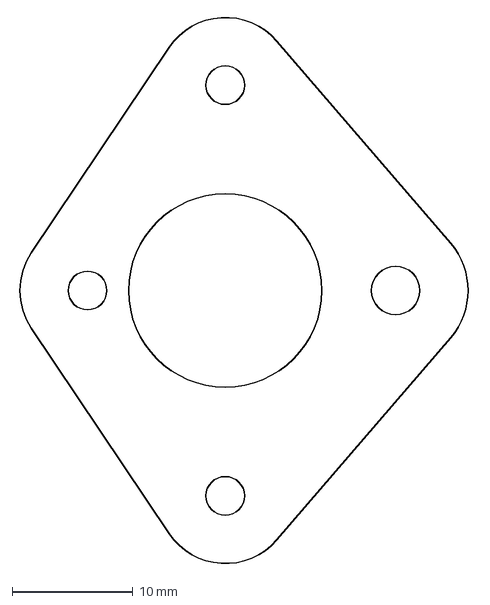
[picture p70: CAD file, 2009-06-04]
users/hoeken/plastruder-printable/insulator-retainer.dxf
37.9 x 45.4 mm
