jmil/makerbot/users/hoeken/templates/nema-17-gasket.dxf

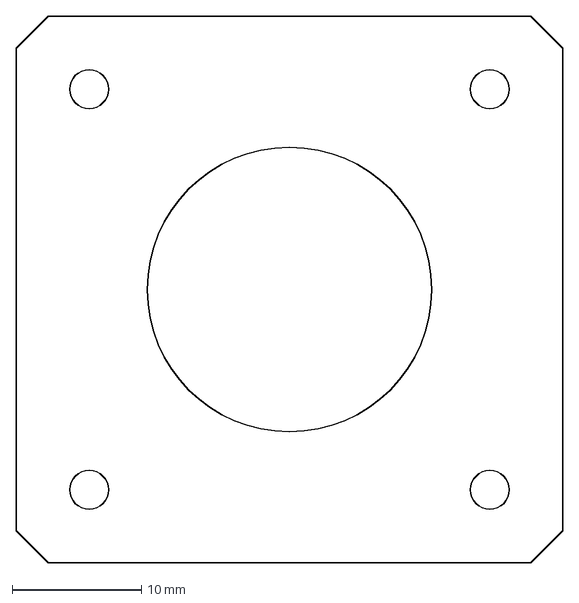
[picture p71: CAD file, 2010-07-13]
users/hoeken/templates/nema-17-gasket.dxf
42.3 x 42.3 mm
