jmil/makerbot/tags/cupcake-cnc-batch-3-4/cupcake-y-stage-5mm.dxf

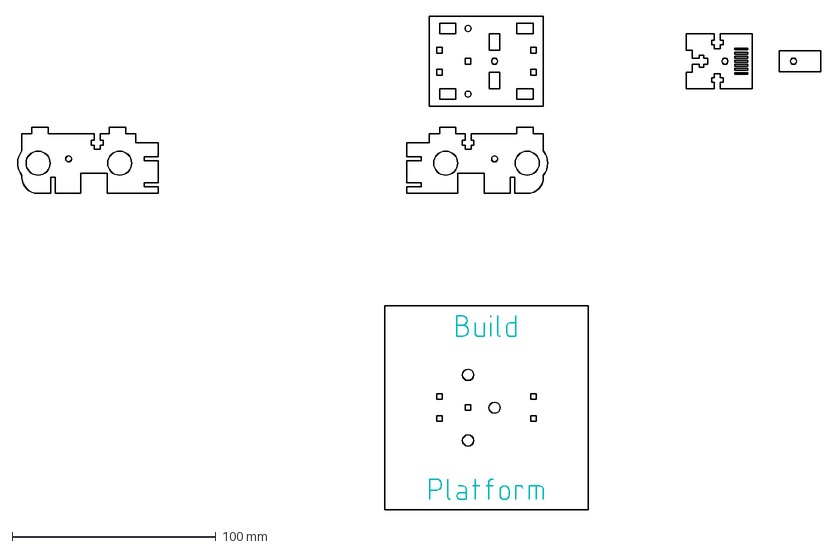
[picture p73: CAD file, 2009-05-19]
tags/cupcake-cnc-batch-3-4/cupcake-y-stage-5mm.dxf
394.7 x 242.0 mm
