jmil/makerbot/tags/cupcake-cnc-batch-3-4/cutting_layouts/cupcake-xy-layout-5mm.dxf

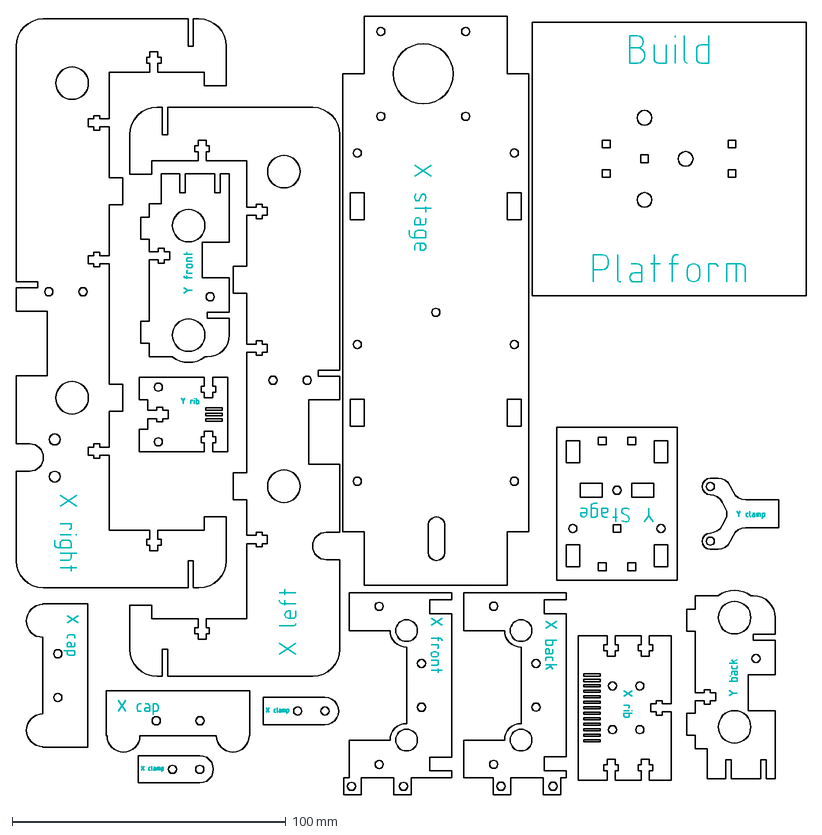
[picture p74: CAD file, 2009-05-15]
tags/cupcake-cnc-batch-3-4/cutting_layouts/cupcake-xy-layout-5mm.dxf
288.8 x 284.6 mm
