jmil/makerbot/tags/cupcake-cnc-batch-3-4/guides/test-pressfit-bearing-m8.dxf

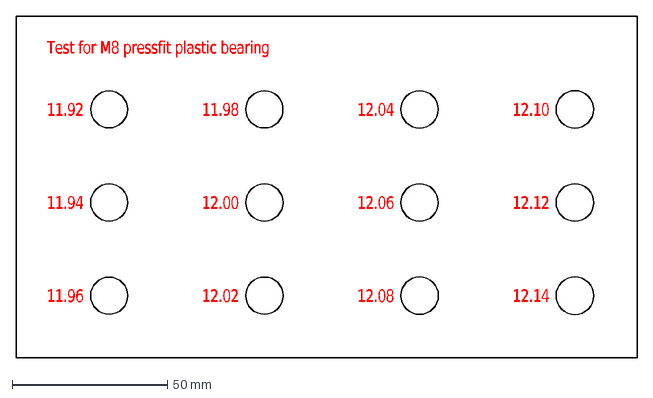
[picture p75: CAD file, 2009-03-10]
tags/cupcake-cnc-batch-3-4/guides/test-pressfit-bearing-m8.dxf
12.04
12.06
12.08
12.10
12.12
12.14
12.02
12.00
11.98
11.96
11.94
11.92
Test\~for\~M8\~pressfit\~plastic\~bearing
