jmil/makerbot/tags/plastruder-mk5/filament-drive/layout-delrin.dxf

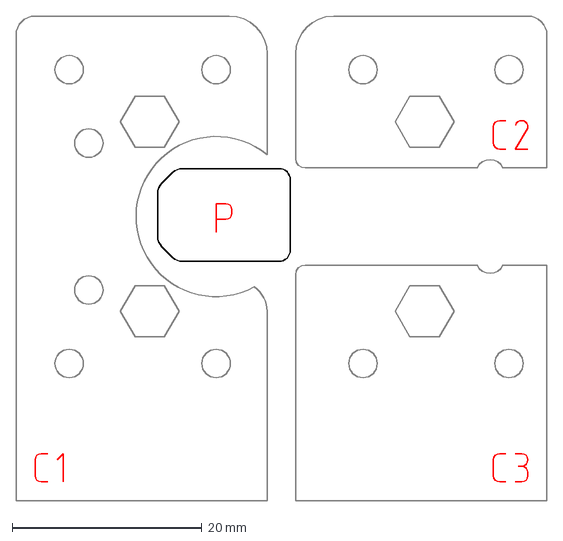
[picture p76: CAD file, 2010-05-28]
tags/plastruder-mk5/filament-drive/layout-delrin.dxf
56.0 x 51.2 mm
