jmil/makerbot/tags/plastruder-mk5/hot-end/thermal-barrier-tube.dxf

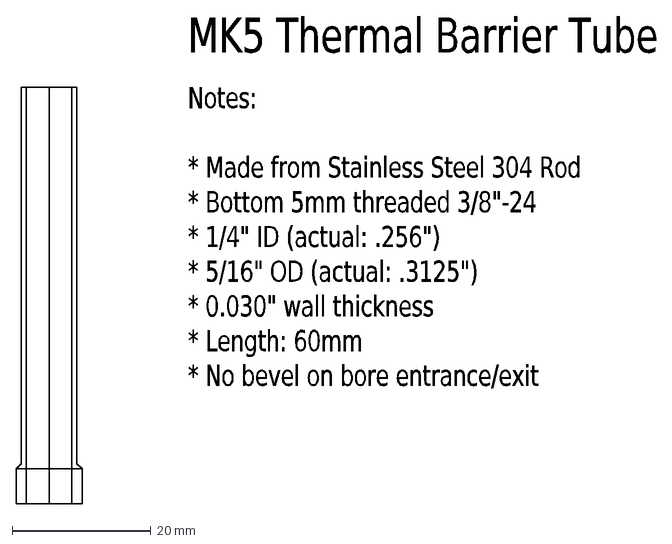
[picture p77: CAD file, 2010-05-24]
tags/plastruder-mk5/hot-end/thermal-barrier-tube.dxf
Notes: *\~Made\~from\~Stainless\~Steel\~304\~Rod *\~Bottom\~5mm\~threaded\~3/8"-24 *\~1/4"\~ID\~(actual:\~.256") *\~5/16"\~OD\~(actual:\~.3125") *\~0.030"\~wall
MK5\~Thermal\~Barrier\~Tube
