jmil/makerbot/trunk/cupcake/belt_latch.dxf

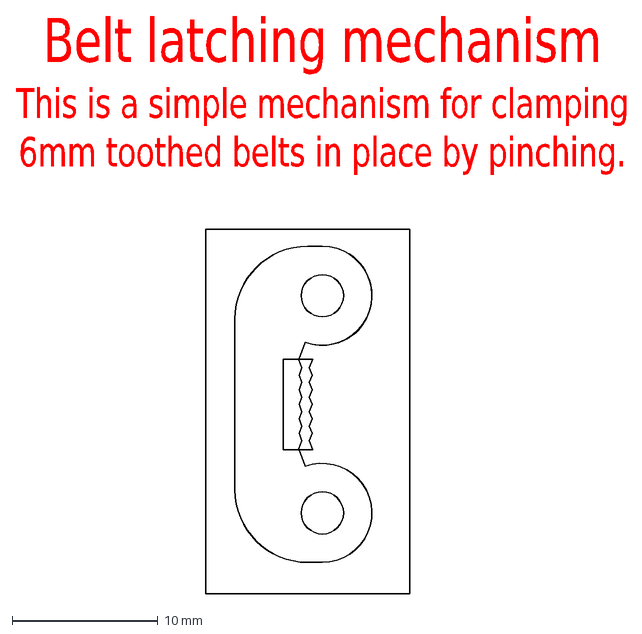
[picture p78: CAD file, 2009-03-18]
trunk/cupcake/belt_latch.dxf
Belt\~latching\~mechanism
This\~is\~a\~simple\~mechanism\~for\~clamping\~ 6mm\~toothed\~belts\~in\~place\~by\~pinching.
