jmil/makerbot/trunk/cupcake/lasercut-parts/y-stage/heat-spreader.dxf

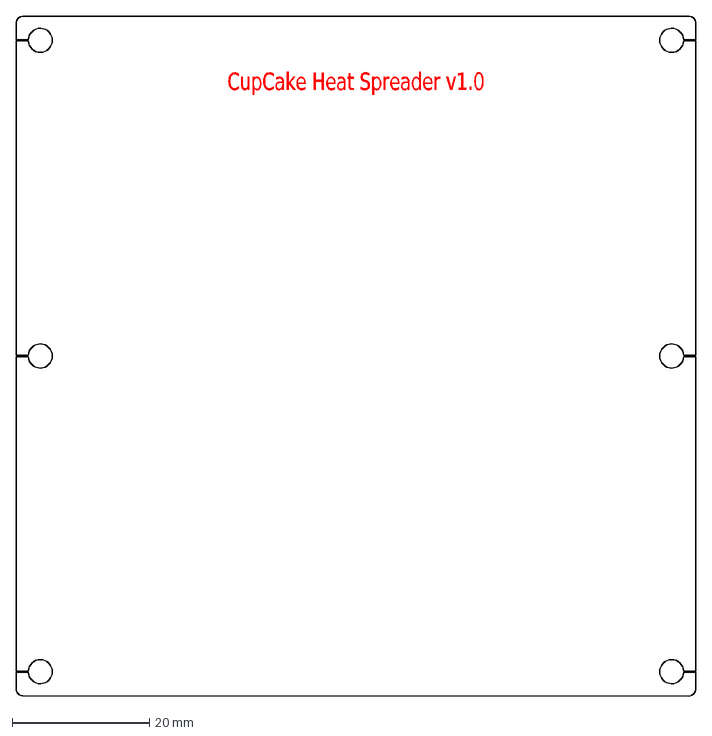
[picture p79: CAD file, 2010-02-24]
trunk/cupcake/lasercut-parts/y-stage/heat-spreader.dxf
CupCake\~Heat\~Spreader\~v1.0
