jmil/makerbot/trunk/frostruder/top-clamp.dxf

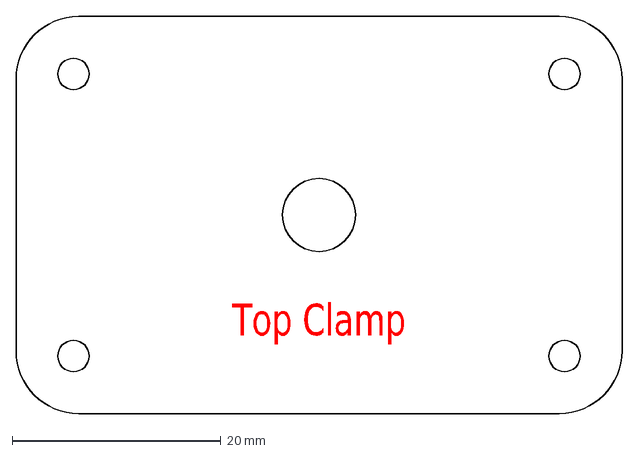
[picture p80: CAD file, 2009-10-18]
trunk/frostruder/top-clamp.dxf
Top\~Clamp
