jmil/makerbot/users/charles/bowden/spool.dxf

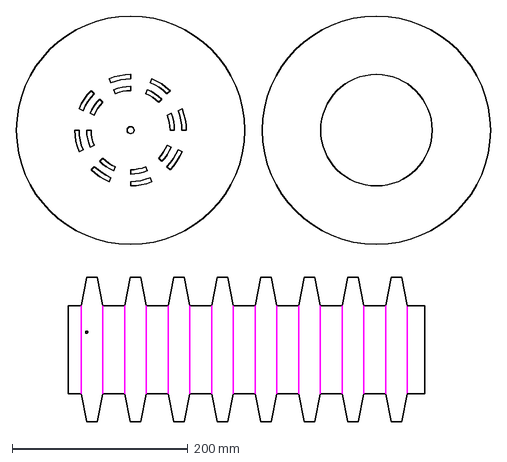
[picture p82: CAD file, 2010-03-22]
users/charles/bowden/spool.dxf
540.0 x 462.3 mm
