jmil/makerbot/users/charles/paxtruder/Paxtruder-0.2-pusher.dxf

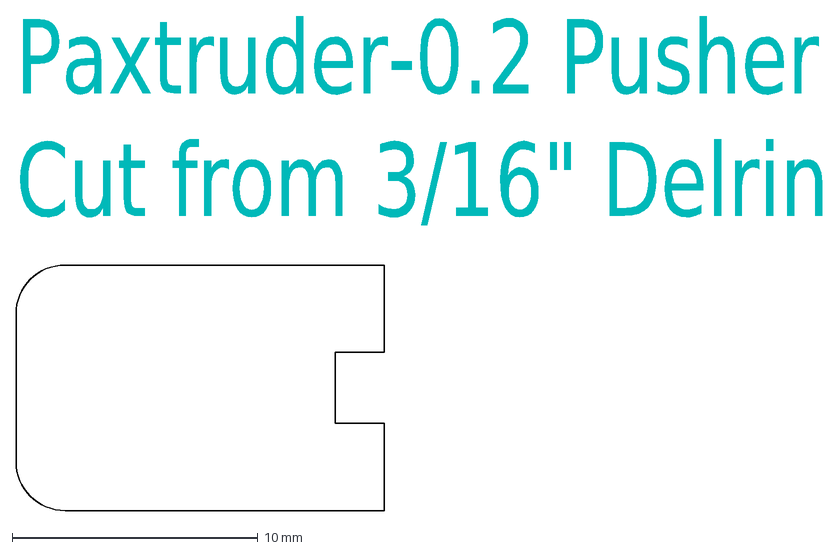
[picture p83: CAD file, 2010-02-21]
users/charles/paxtruder/Paxtruder-0.2-pusher.dxf
Paxtruder-0.2\~Pusher Cut\~from\~3/16"\~Delrin
