jmil/makerbot/users/charles/test-rigs/electronics-test-mount.dxf

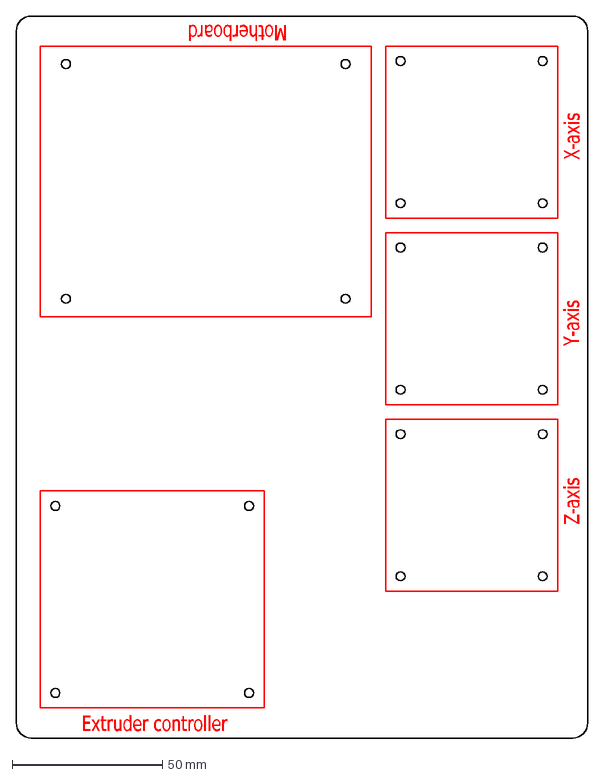
[picture p84: CAD file, 2010-10-27]
users/charles/test-rigs/electronics-test-mount.dxf
X-axis
Motherboard
Y-axis
Z-axis
Extruder\~controller
