jmil/makerbot/users/hoeken/art/resistorflake.dxf

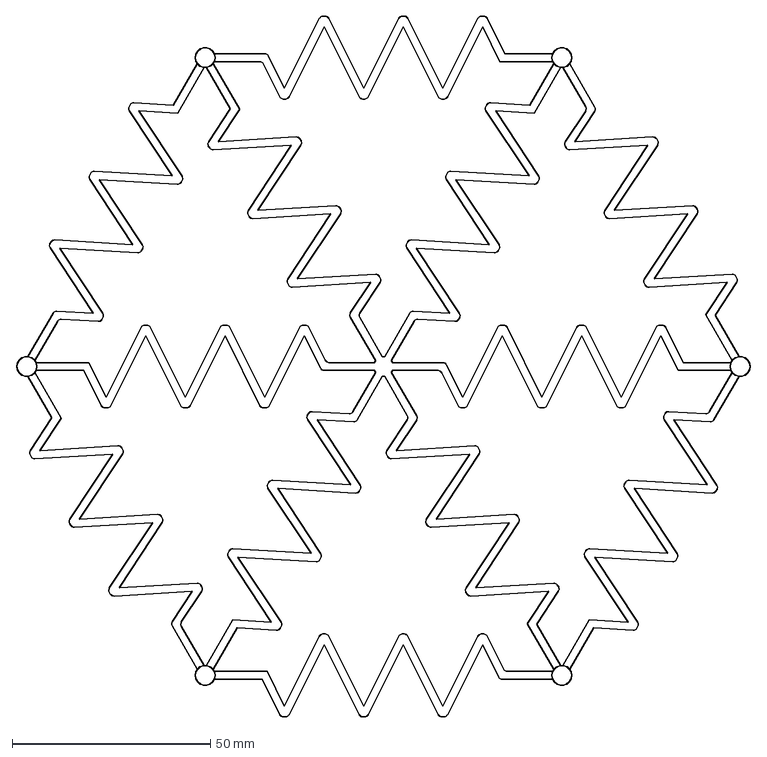
[picture p85: CAD file, 2010-04-18]
users/hoeken/art/resistorflake.dxf
185.5 x 176.8 mm
