jmil/makerbot/users/hoeken/makerwave/x-axis.dxf

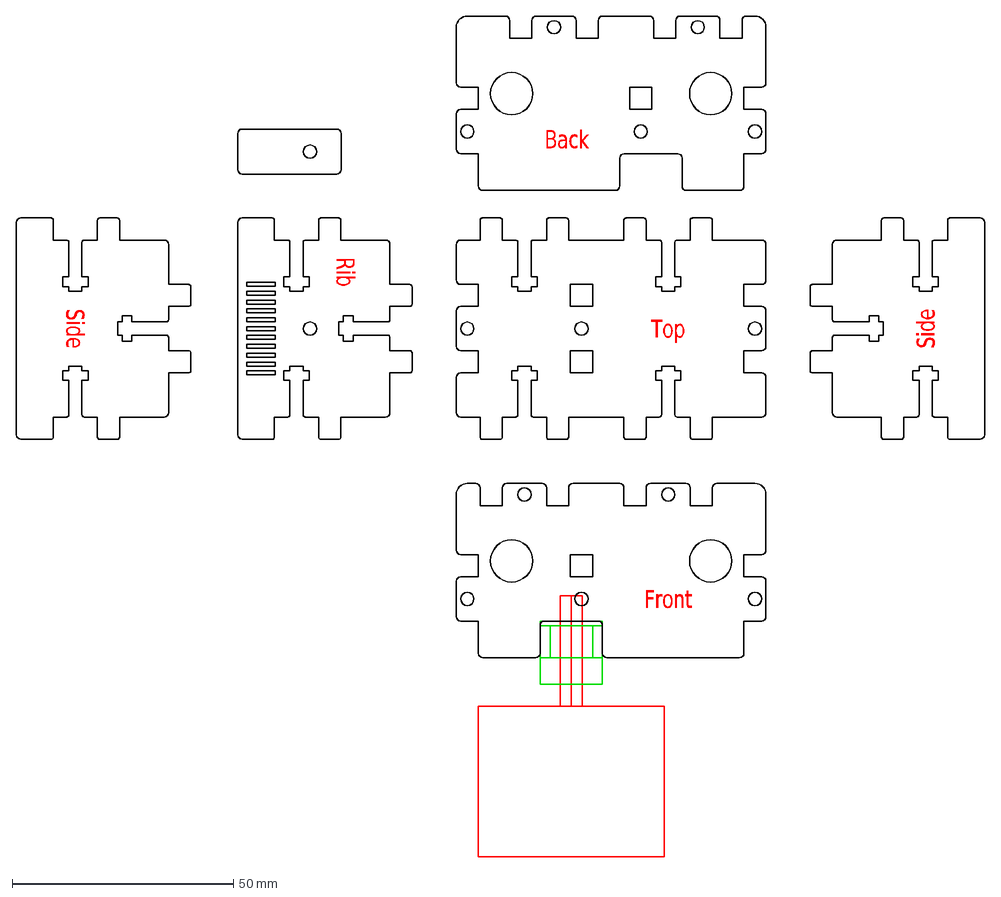
[picture p86: CAD file, 2009-12-14]
users/hoeken/makerwave/x-axis.dxf
Top
Front
Back
Side
Rib
