jmil/makerbot/users/hoeken/openscad/botcube/cuboid.stl

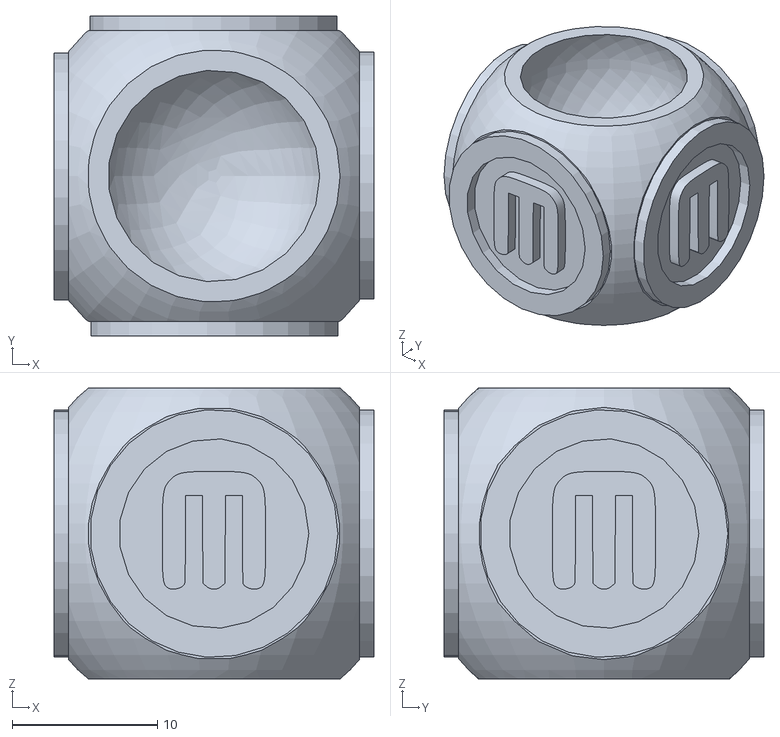
[picture p87: CAD file, 2010-05-23]
users/hoeken/openscad/botcube/cuboid.stl
22.0 x 22.0 x 20.0
