jmil/makerbot/users/hoeken/openscad/tp-holder/outer-tube.stl

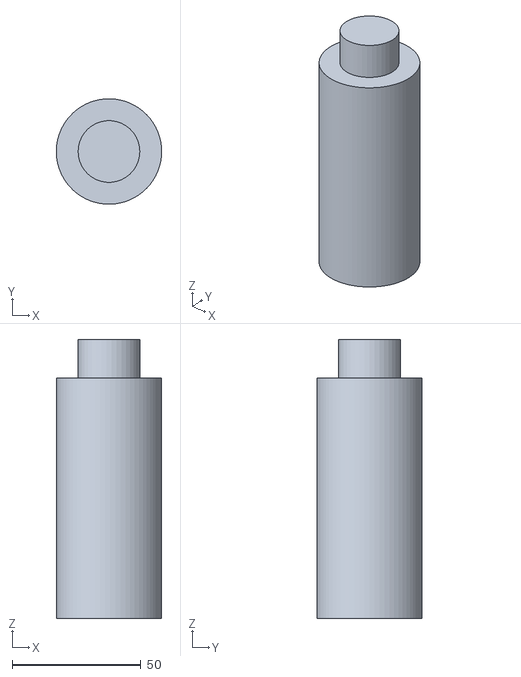
[picture p88: CAD file, 2010-05-12]
users/hoeken/openscad/tp-holder/outer-tube.stl
41.0 x 41.0 x 108.5
