jmil/makerbot/users/hoeken/parabola/trough.dxf

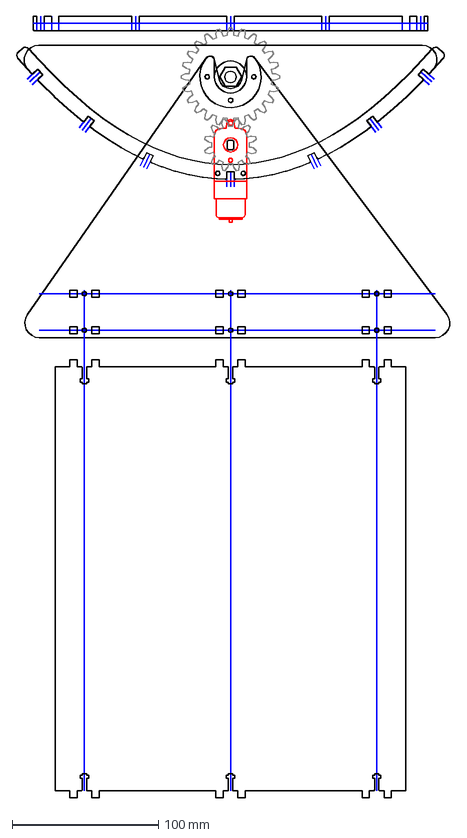
[picture p89: CAD file, 2010-04-11]
users/hoeken/parabola/trough.dxf
297.2 x 535.0 mm
