jmil/makerbot/users/hoeken/plastruder-printable/z-platform.dxf

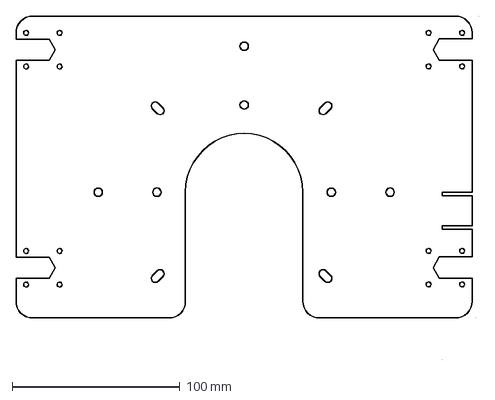
[picture p90: CAD file, 2009-06-04]
users/hoeken/plastruder-printable/z-platform.dxf
276.0 x 205.0 mm
