jmil/makerbot/users/hoeken/plastruder-twindrive/pressure-bearing-drawing.dxf

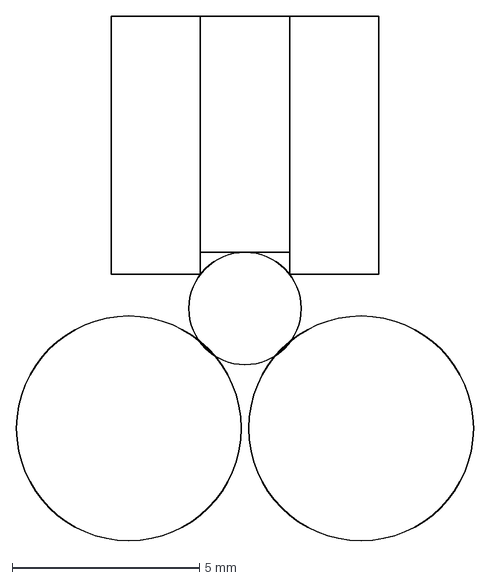
[picture p91: CAD file, 2009-09-24]
users/hoeken/plastruder-twindrive/pressure-bearing-drawing.dxf
12.2 x 14.0 mm
