jmil/makerbot/users/hoeken/templates/nema-17.dxf

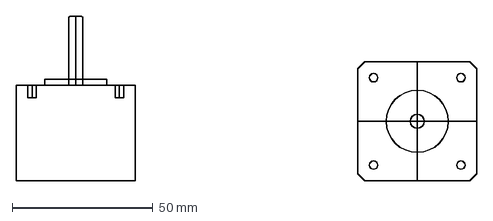
[picture p92: CAD file, 2010-06-20]
users/hoeken/templates/nema-17.dxf
163.5 x 58.5 mm
