jmil/makerbot/tags/cupcake-cnc-batch-3-4/cupcake-x-stage-5mm.dxf

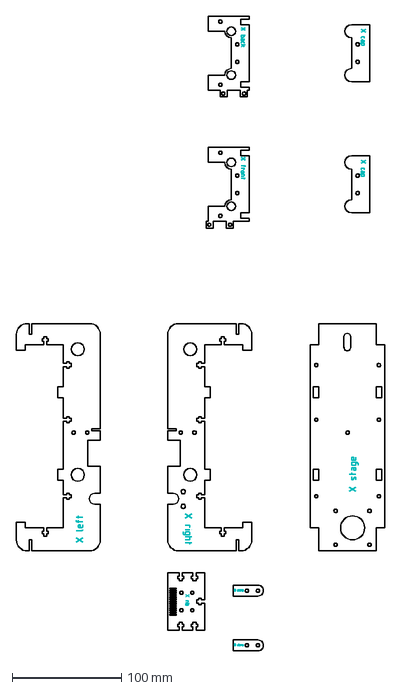
[picture p94: CAD file, 2009-05-19]
tags/cupcake-cnc-batch-3-4/cupcake-x-stage-5mm.dxf
337.1 x 580.6 mm
