jmil/makerbot/tags/cupcake-cnc-batch-3-4/cutting_layouts/build_platforms_6.dxf

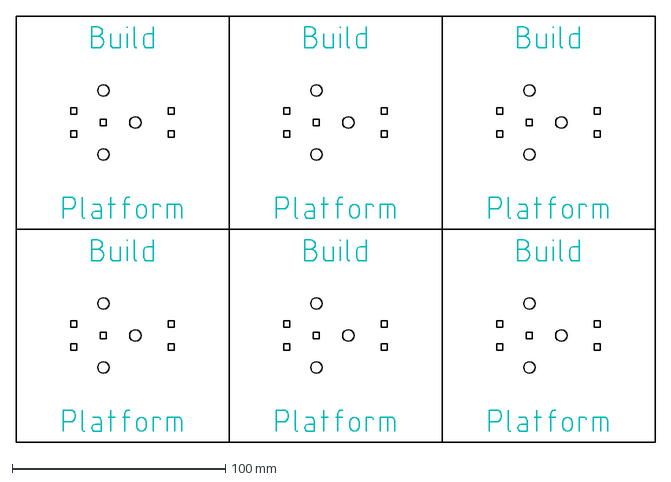
[picture p95: CAD file, 2009-04-14]
tags/cupcake-cnc-batch-3-4/cutting_layouts/build_platforms_6.dxf
300.0 x 200.0 mm
