jmil/makerbot/tags/plastruder-mk5/filament-drive/drive-gear.dxf

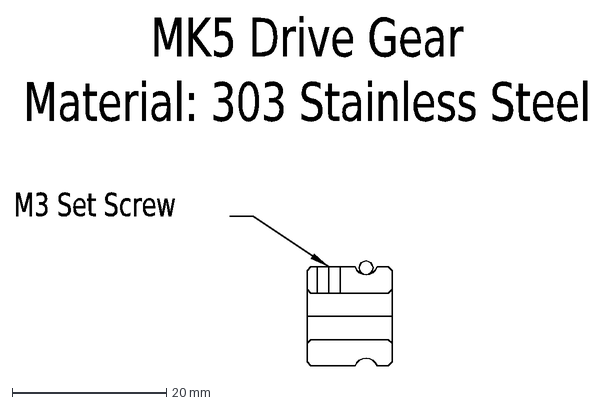
[picture p96: CAD file, 2010-04-05]
tags/plastruder-mk5/filament-drive/drive-gear.dxf
M3\~Set\~Screw
MK5\~Drive\~Gear Material:\~303\~Stainless\~Steel
