jmil/makerbot/tags/plastruder-mk5/hot-end/mk4-adaptor.dxf

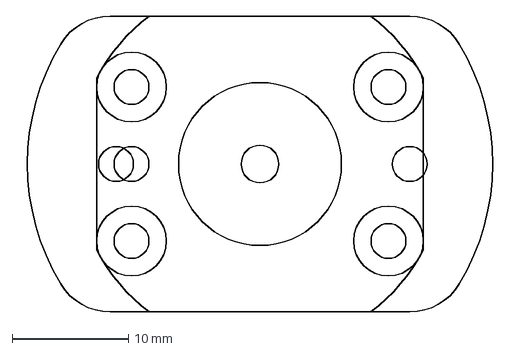
[picture p97: CAD file, 2010-03-30]
tags/plastruder-mk5/hot-end/mk4-adaptor.dxf
41.9 x 25.4 mm
