jmil/makerbot/trunk/cupcake/cc-y-axis-1-0.dxf

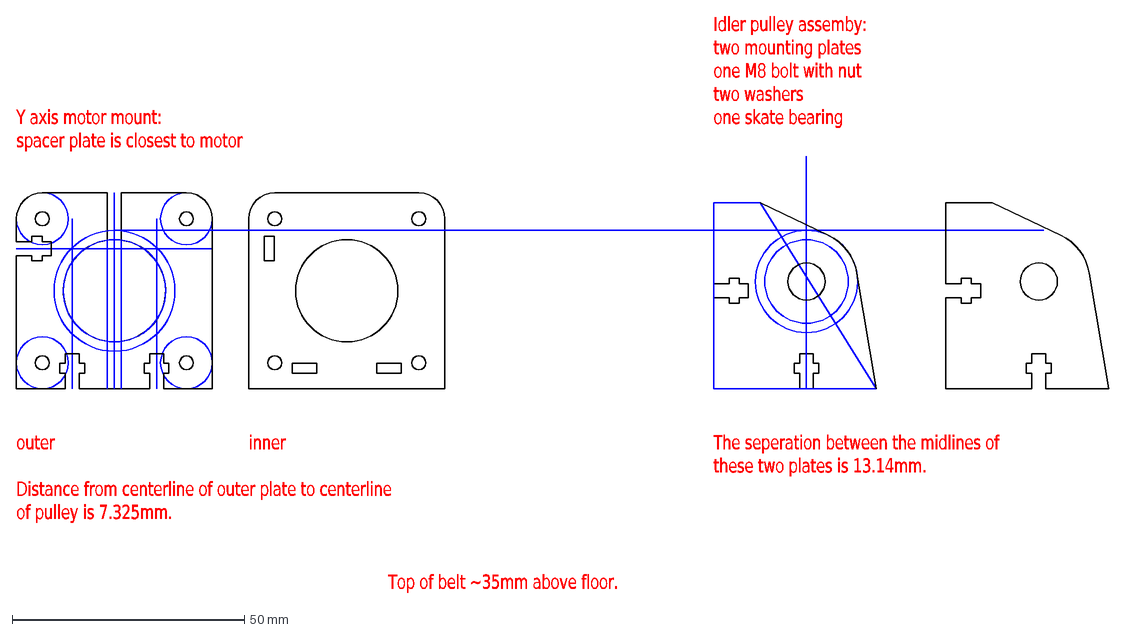
[picture p98: CAD file, 2009-03-04]
trunk/cupcake/cc-y-axis-1-0.dxf
The\~seperation\~between\~the\~midlines\~of\~ these\~two\~plates\~is\~13.14mm.
Idler\~pulley\~assemby: two\~mounting\~plates one\~M8\~bolt\~with\~nut two\~washers one\~skate\~bearing
Y\~axis\~motor\~mount: spacer\~plate\~is\~closest\~to\~motor
inner
outer
Top\~of\~belt\~~35mm\~above\~floor.
Distance\~from\~centerline\~of\~outer\~plate\~to\~centerline of\~pulley\~is\~7.325mm.
