jmil/makerbot/trunk/cupcake/lasercut-parts/y-stage/glass-build-surface.dxf

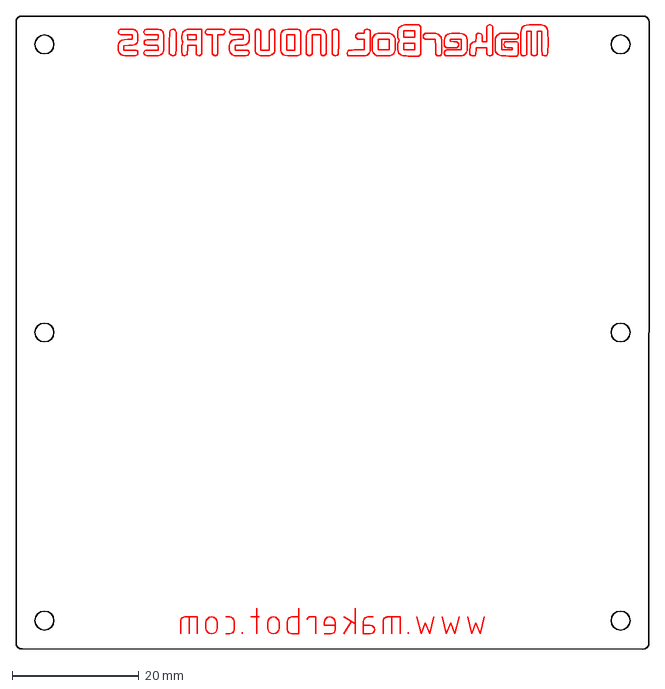
[picture p99: CAD file, 2010-01-25]
trunk/cupcake/lasercut-parts/y-stage/glass-build-surface.dxf
100.0 x 100.0 mm
