jmil/makerbot/users/charles/paxtruder/Paxtruder-0.3-layout.dxf

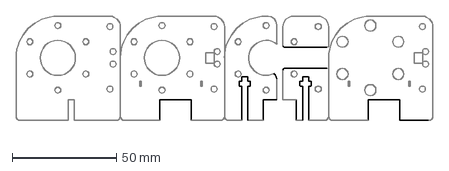
[picture p101: CAD file, 2010-02-21]
users/charles/paxtruder/Paxtruder-0.3-layout.dxf
200.0 x 55.0 mm
