jmil/makerbot/users/hoeken/art/resistor.dxf

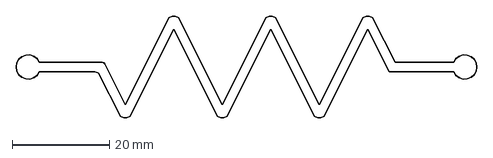
[picture p102: CAD file, 2010-04-18]
users/hoeken/art/resistor.dxf
95.0 x 20.9 mm
