jmil/makerbot/users/hoeken/makerwave/z-axis.dxf

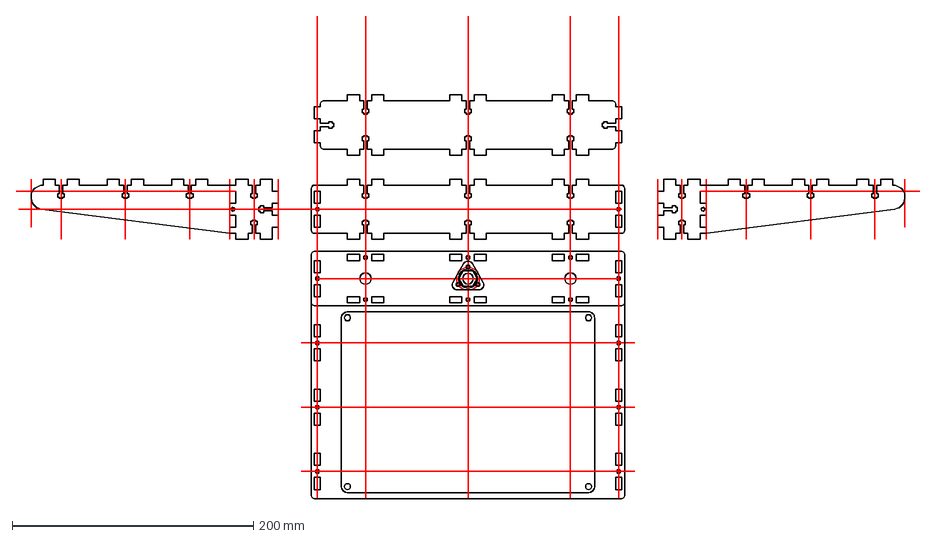
[picture p103: CAD file, 2009-12-08]
users/hoeken/makerwave/z-axis.dxf
749.5 x 400.0 mm
