jmil/makerbot/users/hoeken/parabola/sheet-2.dxf

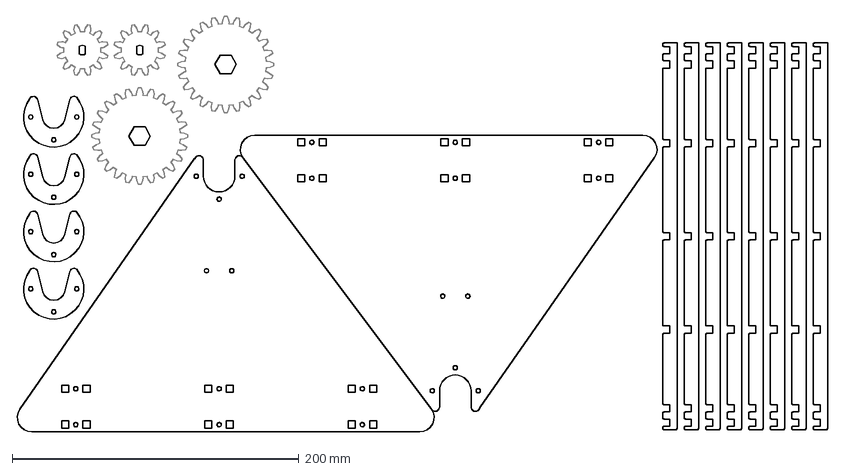
[picture p104: CAD file, 2010-04-11]
users/hoeken/parabola/sheet-2.dxf
566.0 x 289.9 mm
