jmil/makerbot/users/hoeken/plastruder-twindrive/front-plate.dxf

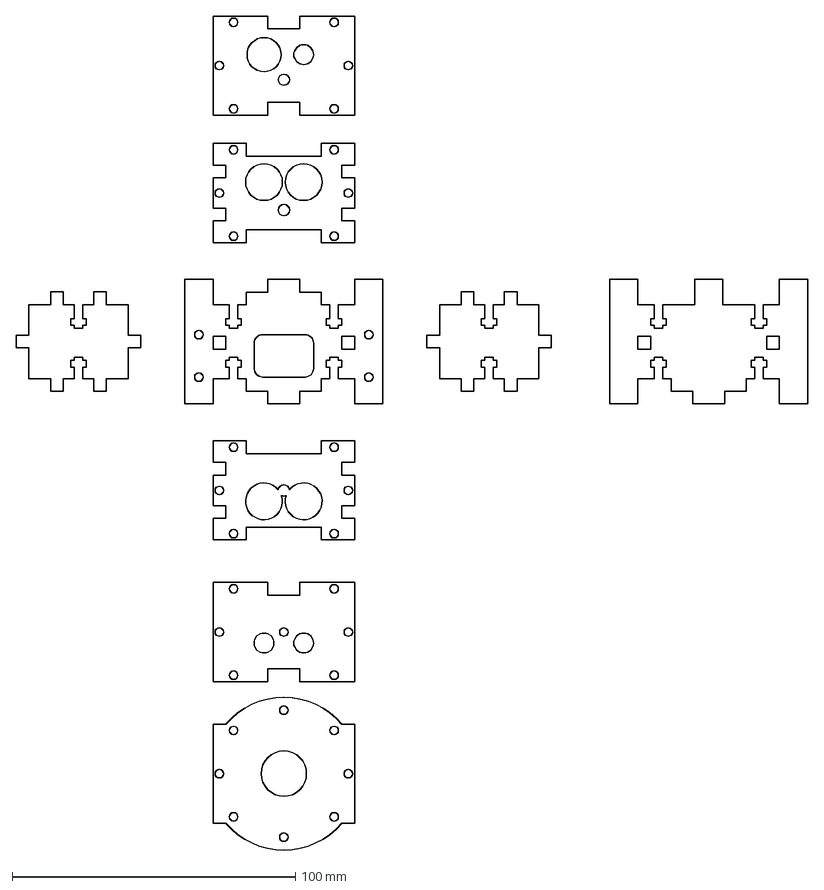
[picture p105: CAD file, 2009-09-01]
users/hoeken/plastruder-twindrive/front-plate.dxf
279.5 x 294.5 mm
