jmil/makerbot/users/hoeken/templates/plastruder-mk5-hardware-kit.dxf

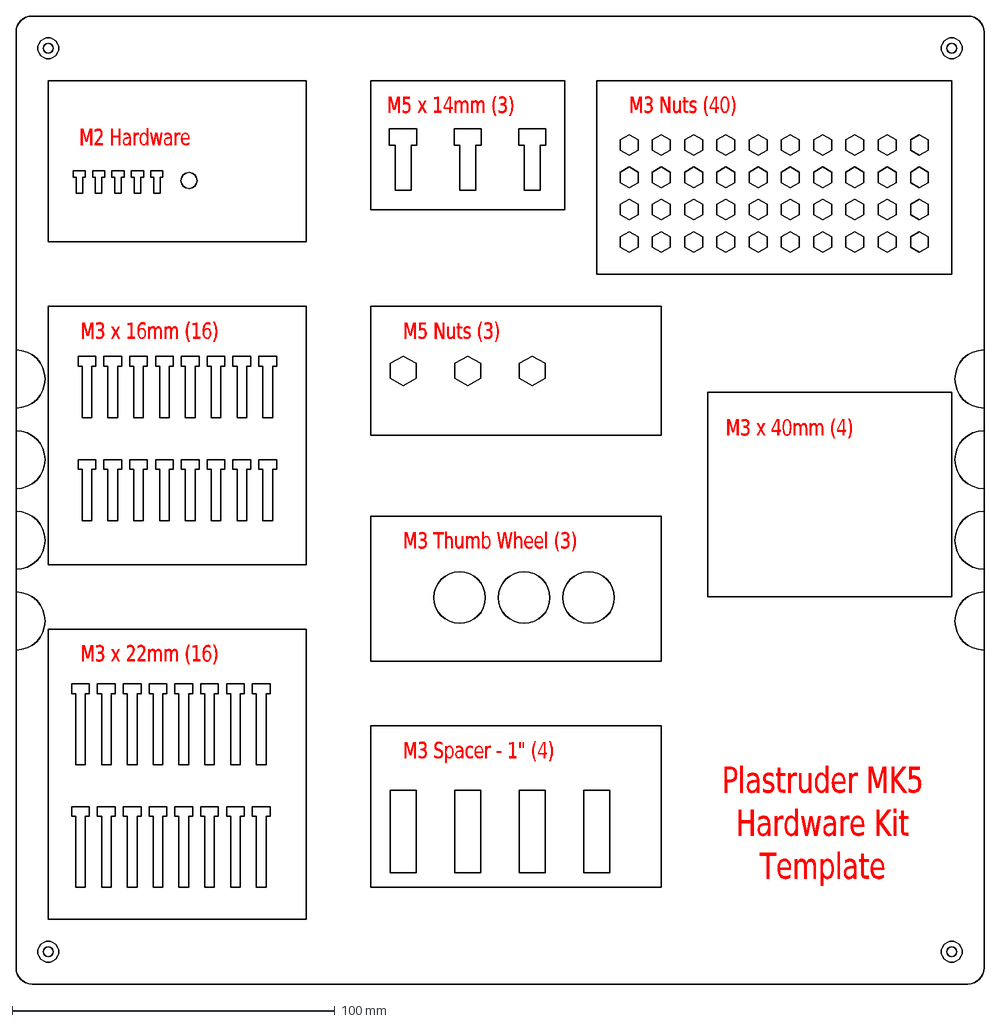
[picture p106: CAD file, 2010-06-07]
users/hoeken/templates/plastruder-mk5-hardware-kit.dxf
M3\~Nuts\~(40)
M3\~x\~40mm\~(4)
M5\~Nuts\~(3)
M3\~Thumb\~Wheel\~(3)
M3\~Spacer\~-\~1"\~(4)
M5\~x\~14mm\~(3)
Plastruder\~MK5 Hardware\~Kit Template
M2\~Hardware
M3\~x\~16mm\~(16)
M3\~x\~22mm\~(16)
