jmil/makerbot/users/hoeken/test-rigs/motherboard-test-rig.dxf

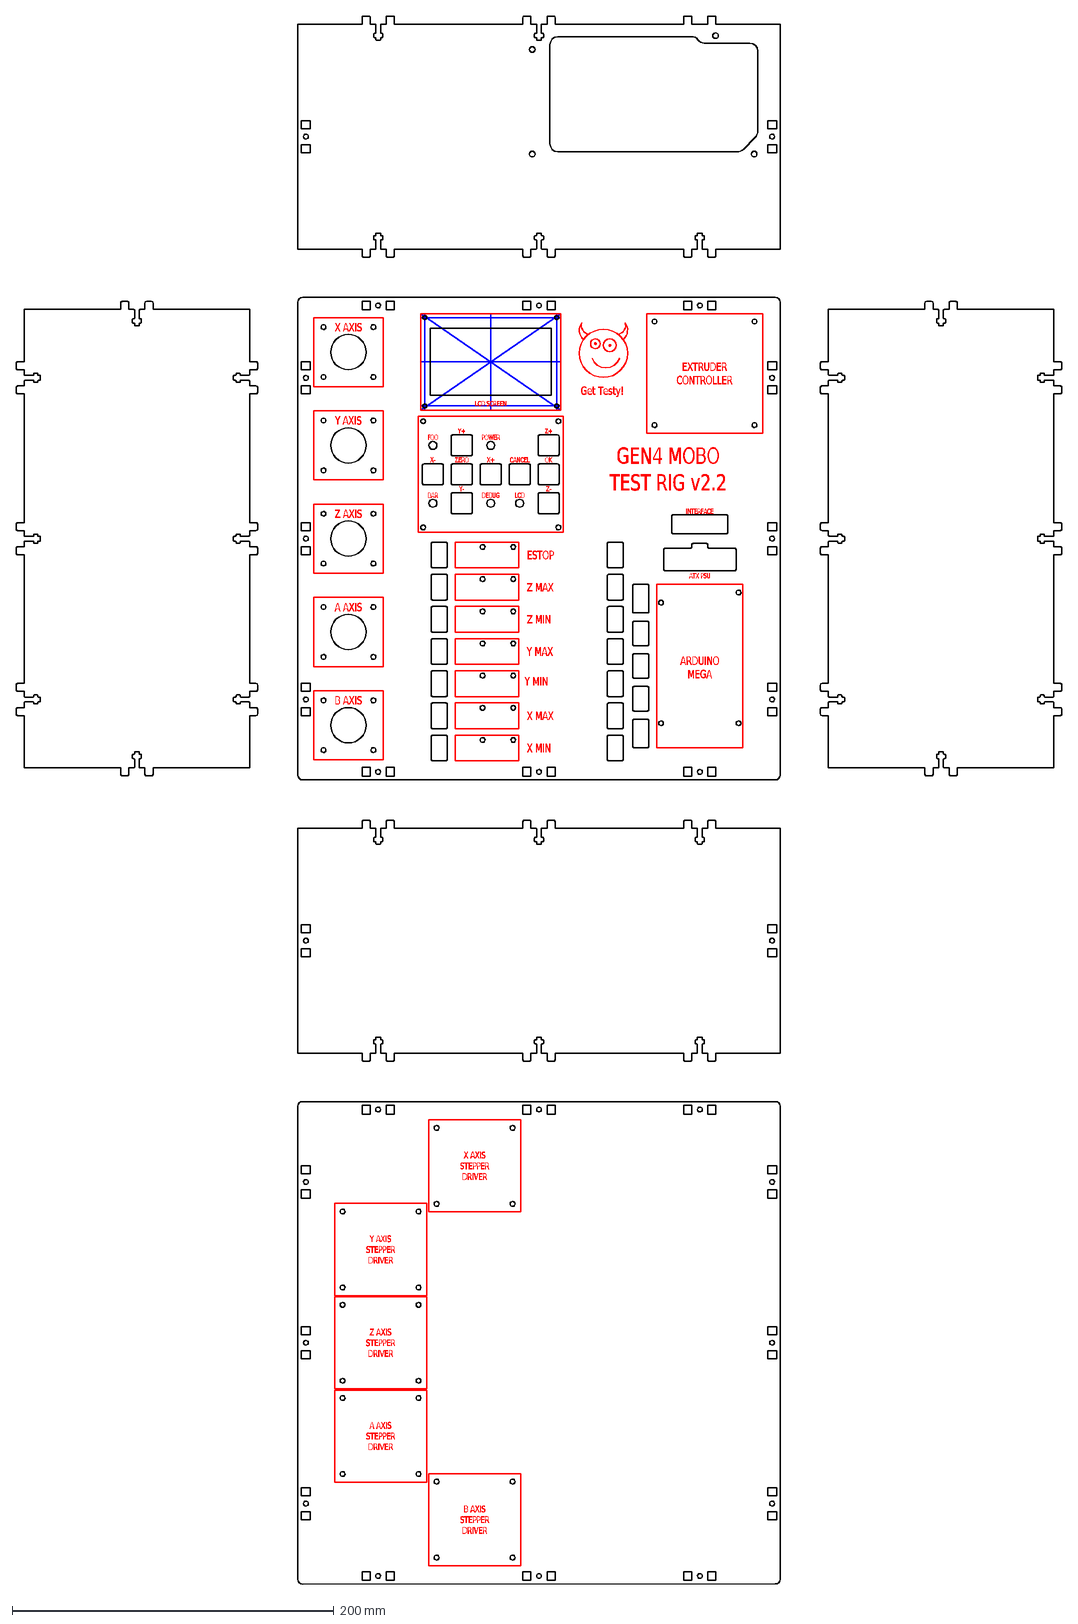
[picture p107: CAD file, 2010-04-15]
users/hoeken/test-rigs/motherboard-test-rig.dxf
EXTRUDER CONTROLLER
ARDUINO MEGA
X\~AXIS STEPPER DRIVER
Y\~AXIS STEPPER DRIVER
Z\~AXIS STEPPER DRIVER
B\~AXIS STEPPER DRIVER
A\~AXIS STEPPER DRIVER
X\~AXIS
Y\~AXIS
Z\~AXIS
A\~AXIS
B\~AXIS
Y+
X+
X-
ZERO
OK
CANCEL
Z+
Z-
POWER
Y-
FOO
BAR
DEBUG
LCD
LCD\~SCREEN
Z\~MAX
Z\~MIN
Y\~MAX
Y\~MIN
ESTOP
X\~MAX
X\~MIN
Get\~Testy!
GEN4\~MOBO TEST\~RIG\~v2.2
ATX\~PSU
INTERFACE
