jmil/makerbot/tags/cupcake-cnc-batch-3-4/cupcake-y-stage.dxf

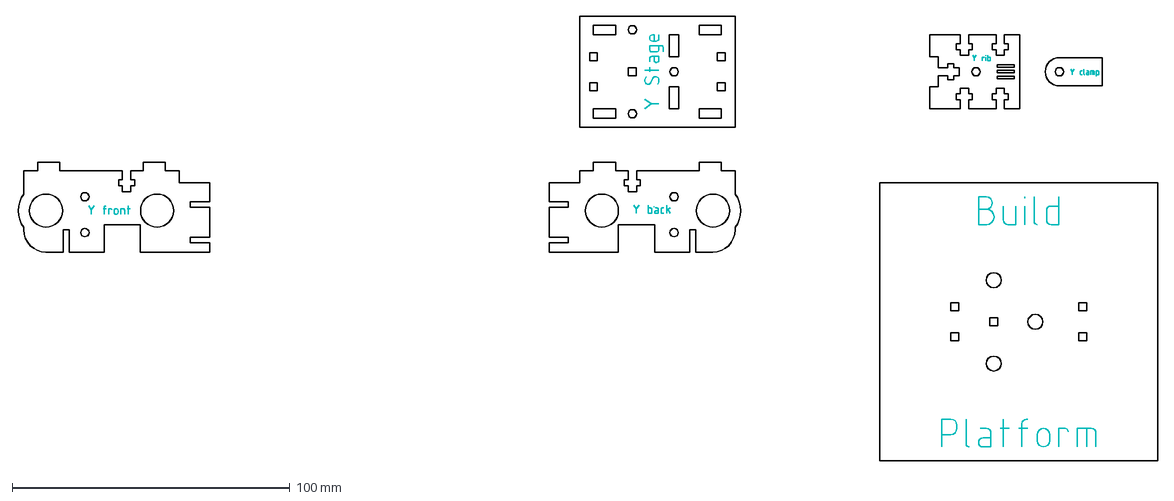
[picture p108: CAD file, 2009-05-19]
tags/cupcake-cnc-batch-3-4/cupcake-y-stage.dxf
410.7 x 160.0 mm
