jmil/makerbot/tags/thingomatic/z-rod.dxf

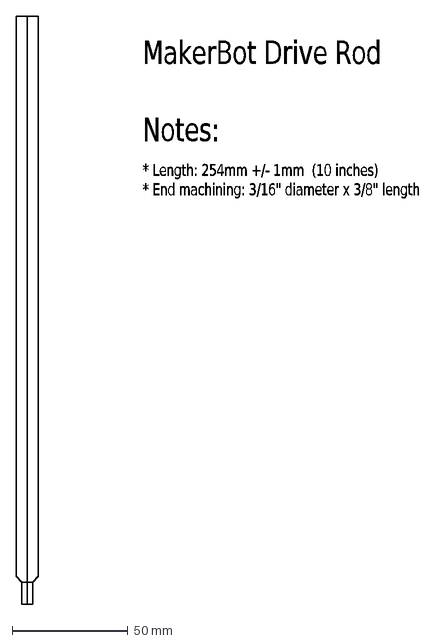
[picture p109: CAD file, 2010-07-12]
tags/thingomatic/z-rod.dxf
MakerBot\~Drive\~Rod Notes:
*\~Length:\~254mm\~+/-\~1mm\~\~(10\~inches) *\~End\~machining:\~3/16"\~diameter\~x\~3/8"\~length
