jmil/makerbot/trunk/cupcake/carriage1-2.dxf

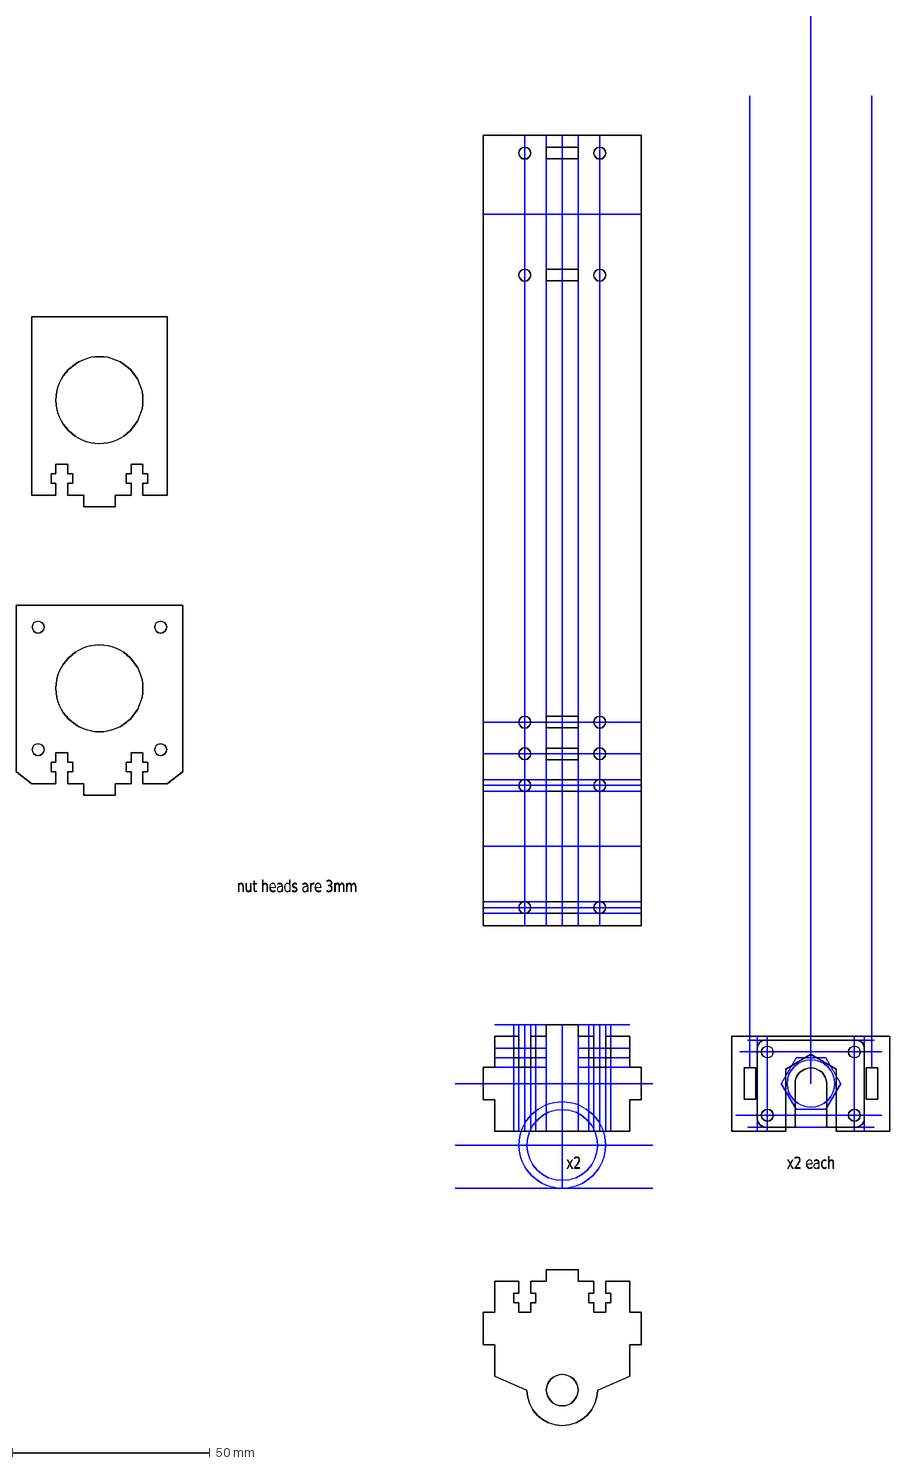
[picture p110: CAD file, 2009-03-02]
trunk/cupcake/carriage1-2.dxf
x2\~each
x2
nut\~heads\~are\~3mm
