jmil/makerbot/trunk/cupcake/lasercut-parts/y-stage/back.dxf

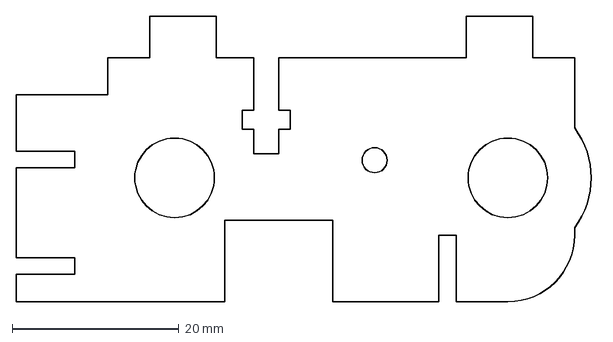
[picture p111: CAD file, 2009-07-01]
trunk/cupcake/lasercut-parts/y-stage/back.dxf
69.7 x 34.3 mm
