jmil/makerbot/users/charles/bowden/filament-box-layout.dxf

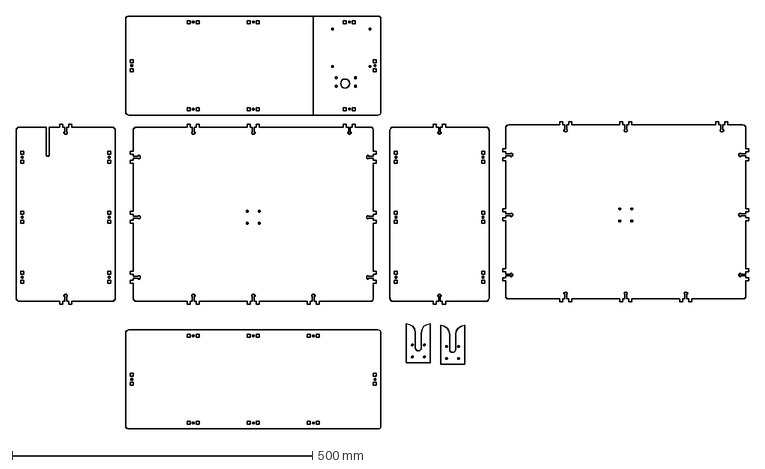
[picture p112: CAD file, 2010-01-25]
users/charles/bowden/filament-box-layout.dxf
1220.2 x 687.5 mm
