jmil/makerbot/users/charles/paxtruder/Paxtruder-0.4.dxf

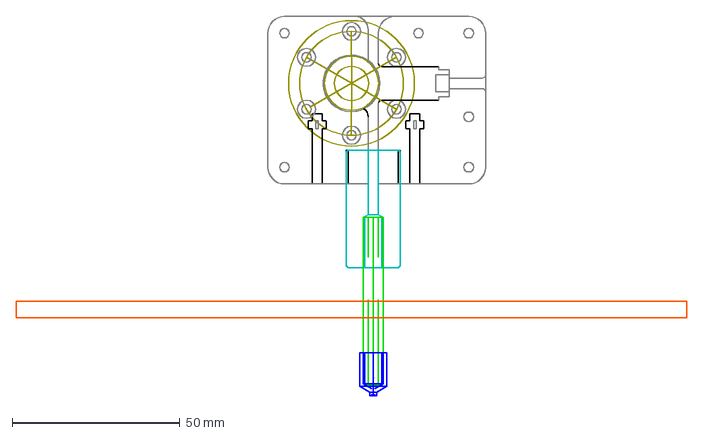
[picture p113: CAD file, 2010-02-21]
users/charles/paxtruder/Paxtruder-0.4.dxf
200.0 x 113.2 mm
