jmil/makerbot/users/hoeken/art/lolcat.dxf

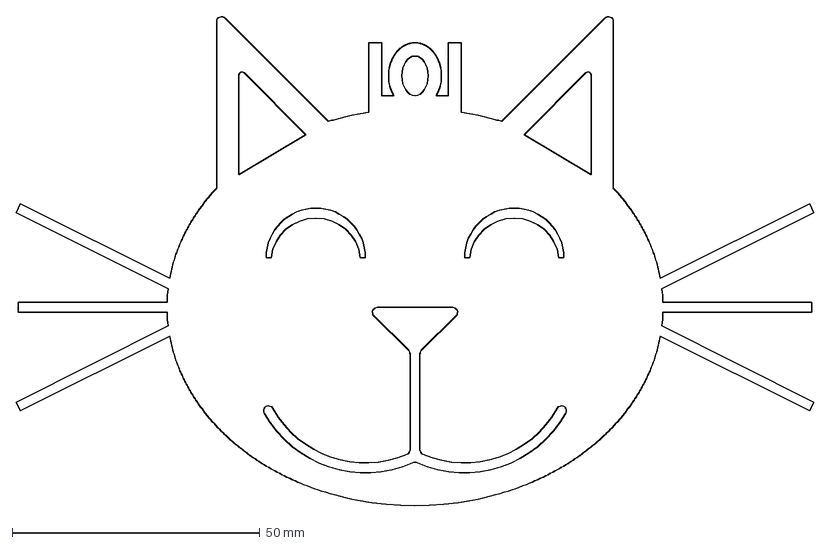
[picture p114: CAD file, 2010-04-18]
users/hoeken/art/lolcat.dxf
160.9 x 98.7 mm
