jmil/makerbot/users/hoeken/micro-cnc/bottom-plate.dxf

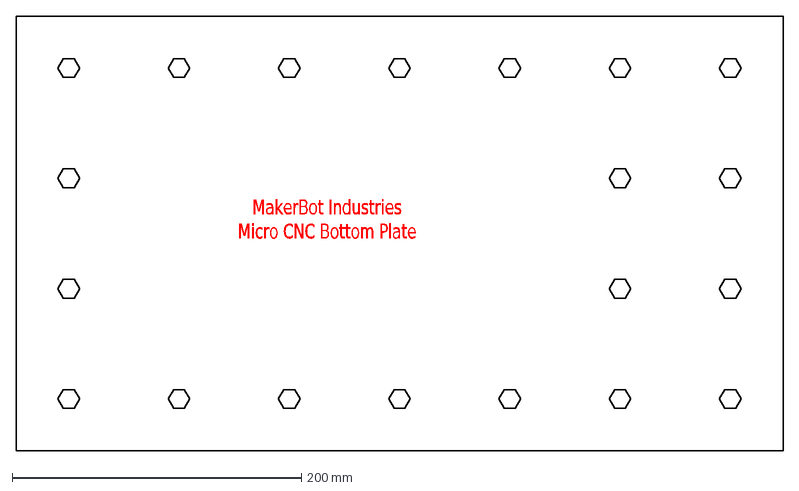
[picture p115: CAD file, 2009-09-17]
users/hoeken/micro-cnc/bottom-plate.dxf
MakerBot\~Industries Micro\~CNC\~Bottom\~Plate
