jmil/makerbot/users/hoeken/parabola/sheet-1.dxf

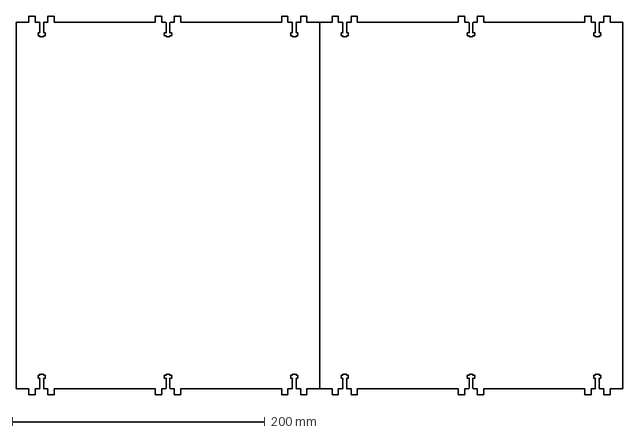
[picture p116: CAD file, 2010-04-11]
users/hoeken/parabola/sheet-1.dxf
480.0 x 300.0 mm
