jmil/makerbot/users/hoeken/plastruder-twindrive/bottom-plate.dxf

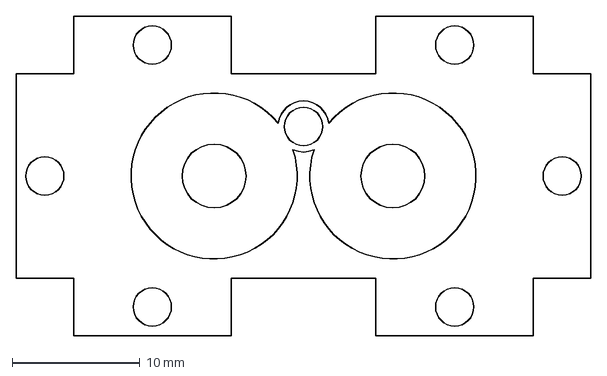
[picture p117: CAD file, 2009-09-01]
users/hoeken/plastruder-twindrive/bottom-plate.dxf
45.0 x 25.0 mm
