jmil/makerbot/users/hoeken/test-rigs/plastruder-test-rig.dxf

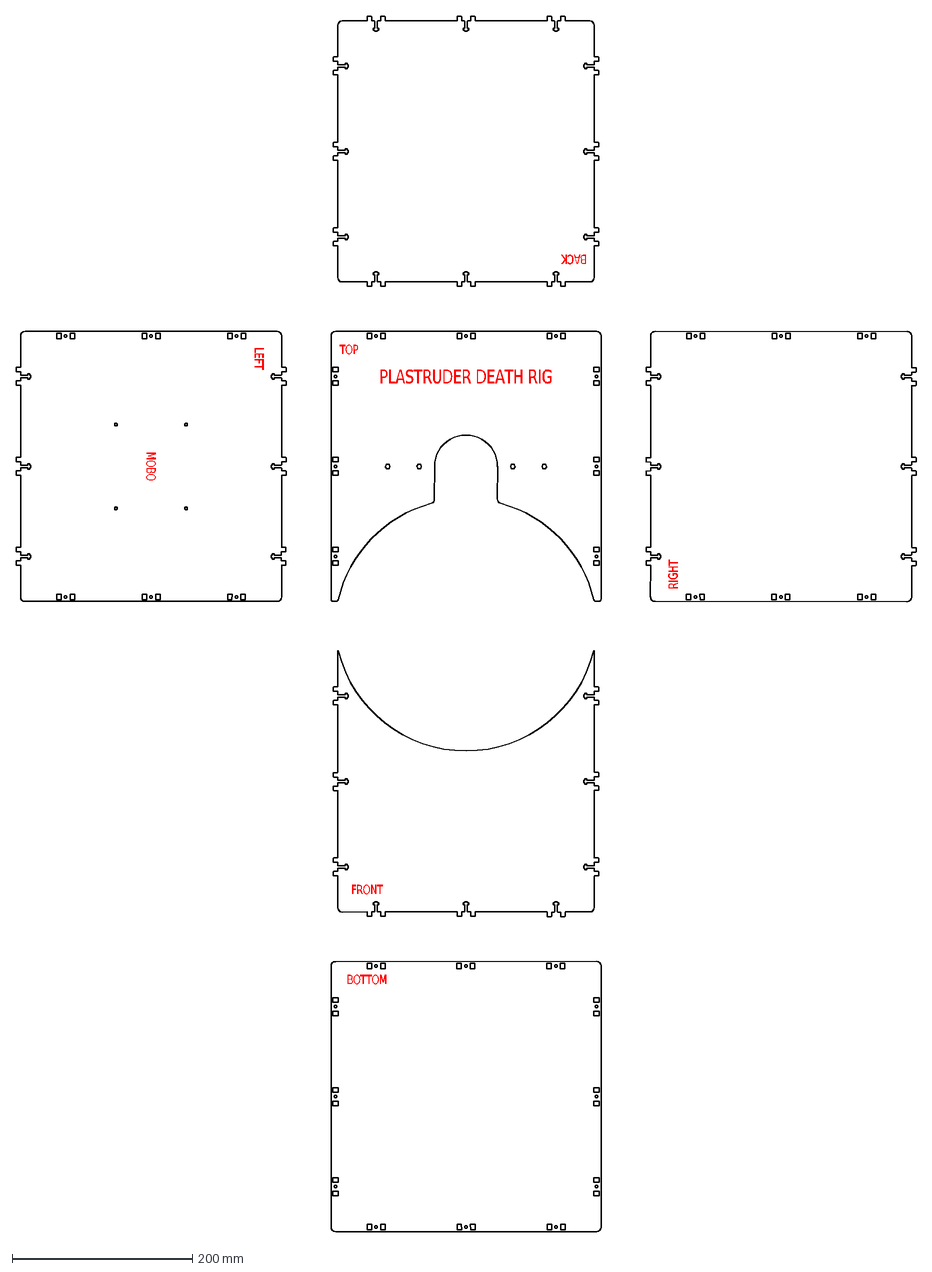
[picture p118: CAD file, 2010-03-30]
users/hoeken/test-rigs/plastruder-test-rig.dxf
MOBO
RIGHT
LEFT
BACK
BOTTOM
PLASTRUDER\~DEATH\~RIG
TOP
FRONT
