jmil/makerbot/tags/cupcake-cnc-batch-3-4/cupcake-x-stage.dxf

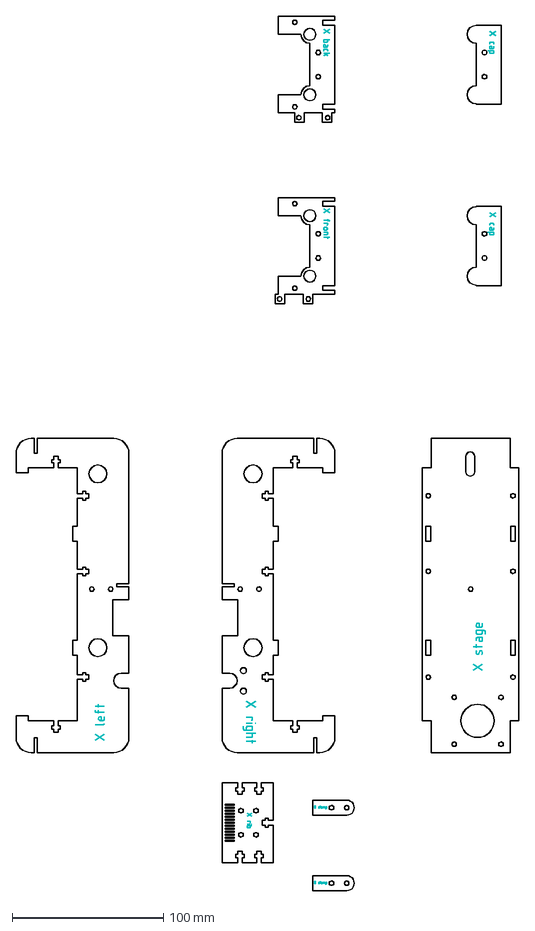
[picture p119: CAD file, 2009-05-19]
tags/cupcake-cnc-batch-3-4/cupcake-x-stage.dxf
332.9 x 578.8 mm
