jmil/makerbot/tags/thingomatic/z-stage-tester.dxf

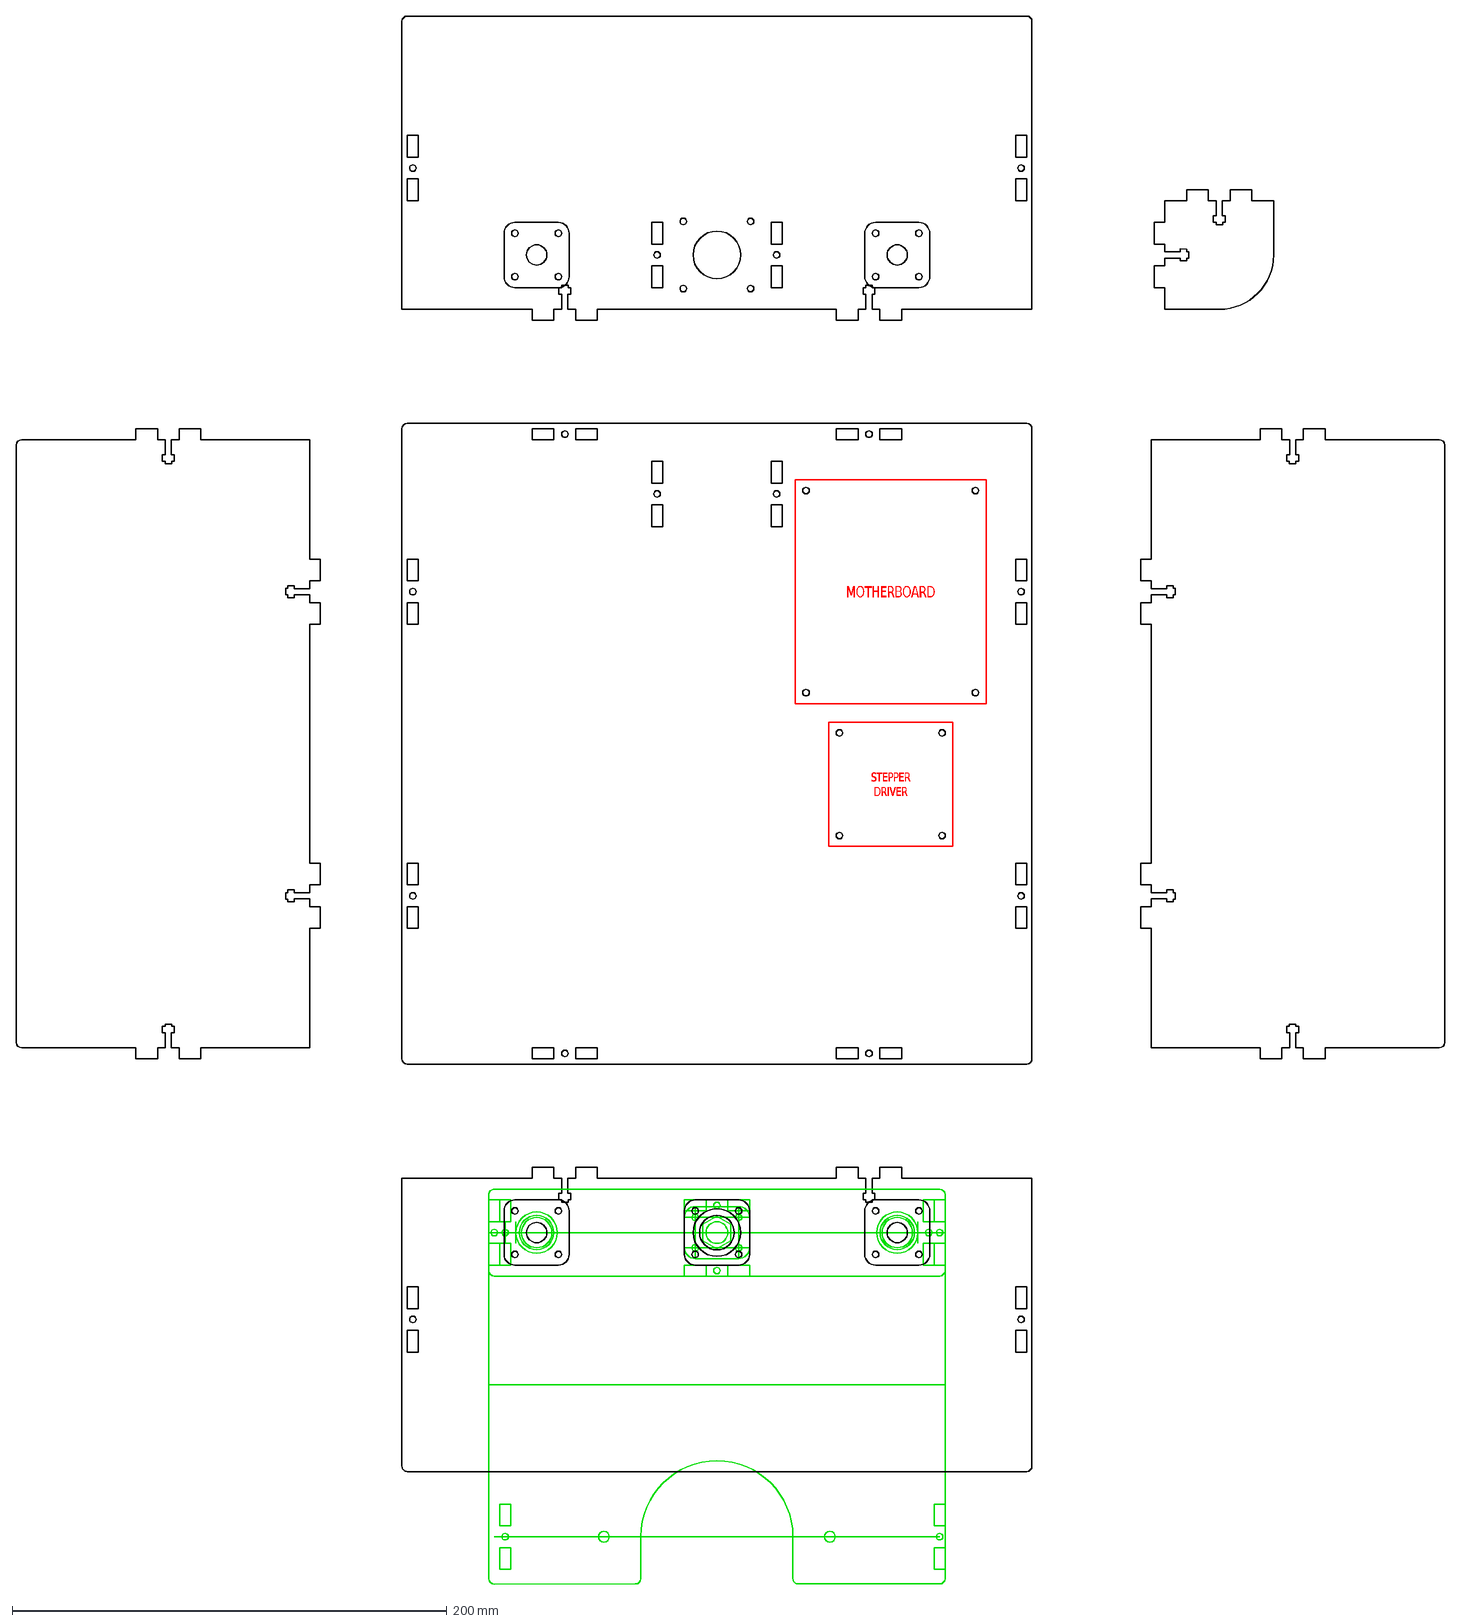
[picture p120: CAD file, 2010-07-01]
tags/thingomatic/z-stage-tester.dxf
MOTHERBOARD
STEPPER DRIVER
