jmil/makerbot/trunk/cupcake/carriage1-1.dxf

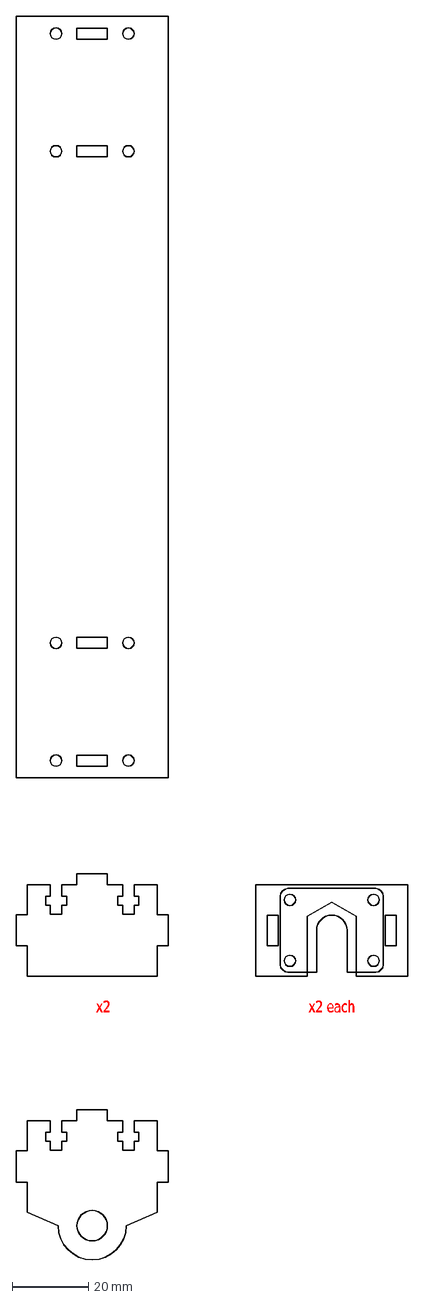
[picture p121: CAD file, 2009-03-02]
trunk/cupcake/carriage1-1.dxf
x2\~each
x2
