jmil/makerbot/trunk/cupcake/lasercut-parts/y-stage/front.dxf

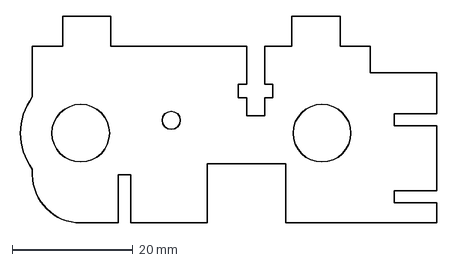
[picture p122: CAD file, 2009-07-01]
trunk/cupcake/lasercut-parts/y-stage/front.dxf
69.7 x 34.3 mm
