jmil/makerbot/users/charles/bowden/drive-pulley.dxf

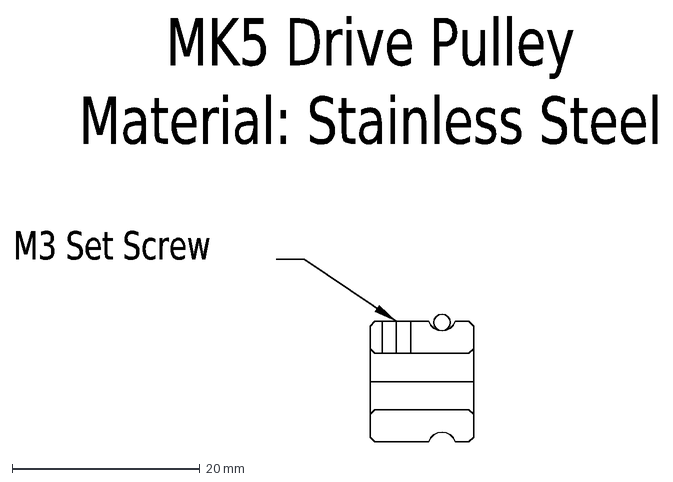
[picture p123: CAD file, 2010-01-23]
users/charles/bowden/drive-pulley.dxf
M3\~Set\~Screw
MK5\~Drive\~Pulley Material:\~Stainless\~Steel
