jmil/makerbot/users/charles/paxtruder/Paxtruder-0.2.dxf

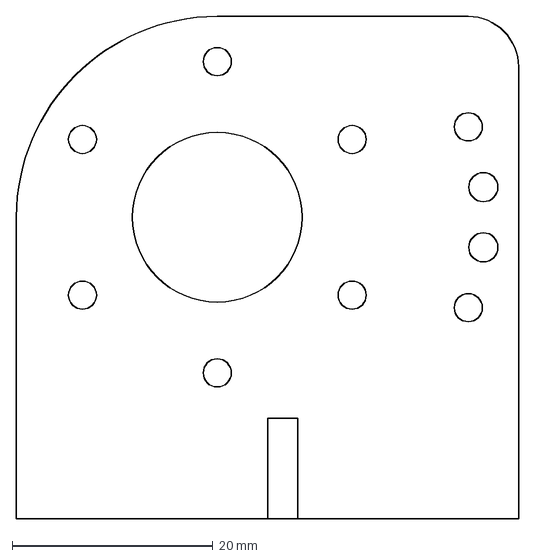
[picture p124: CAD file, 2010-02-21]
users/charles/paxtruder/Paxtruder-0.2.dxf
50.0 x 50.0 mm
