jmil/makerbot/users/hoeken/art/atom.dxf

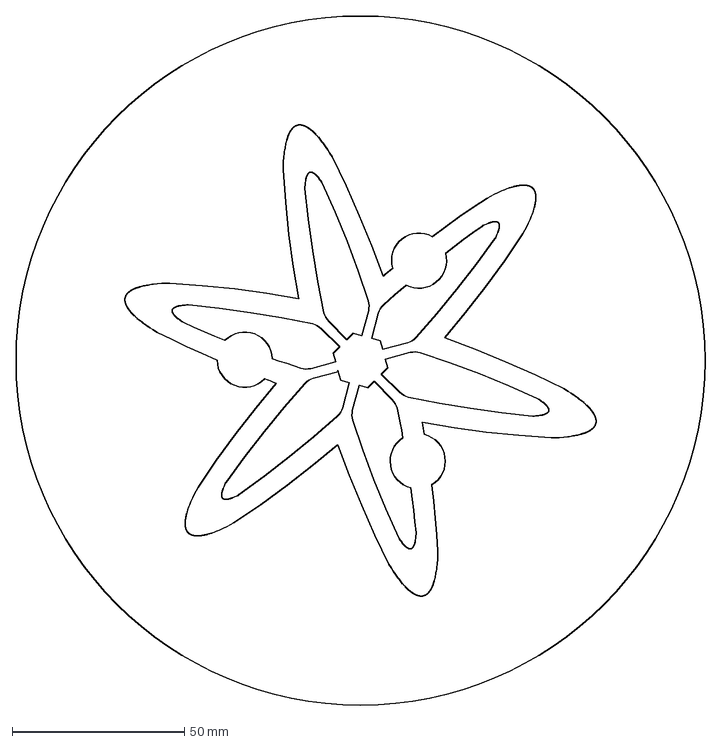
[picture p125: CAD file, 2010-04-07]
users/hoeken/art/atom.dxf
200.0 x 200.0 mm
