jmil/makerbot/users/hoeken/plastruder-twindrive/bottom-plate-inner.dxf

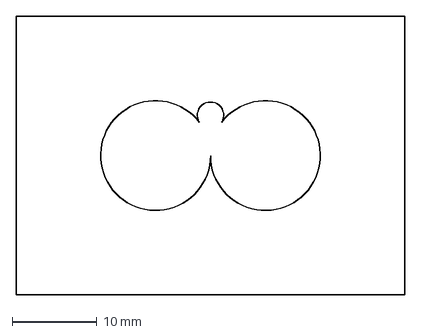
[picture p126: CAD file, 2009-08-05]
users/hoeken/plastruder-twindrive/bottom-plate-inner.dxf
46.0 x 33.0 mm
