jmil/makerbot/users/hoeken/test-rigs/motherboard-stepper-driver.dxf

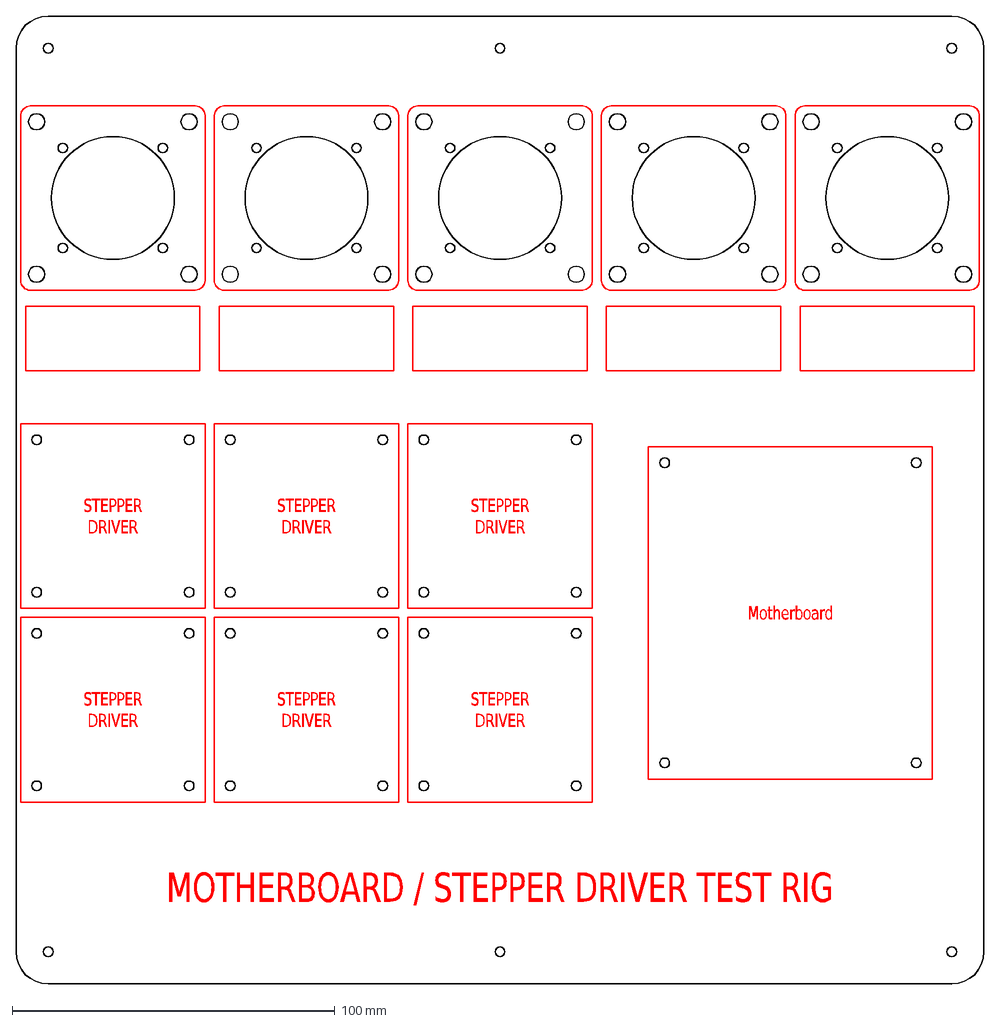
[picture p127: CAD file, 2010-03-16]
users/hoeken/test-rigs/motherboard-stepper-driver.dxf
Motherboard
STEPPER DRIVER
MOTHERBOARD\~/\~STEPPER\~DRIVER\~TEST\~RIG
