jmil/makerbot/tags/cupcake-cnc-batch-3-4/bearing-cover.dxf

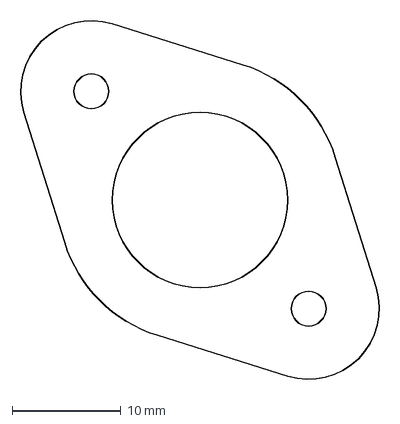
[picture p128: CAD file, 2009-05-16]
tags/cupcake-cnc-batch-3-4/bearing-cover.dxf
33.9 x 33.9 mm
