jmil/makerbot/tags/thingomatic/primary-stage-tester.dxf

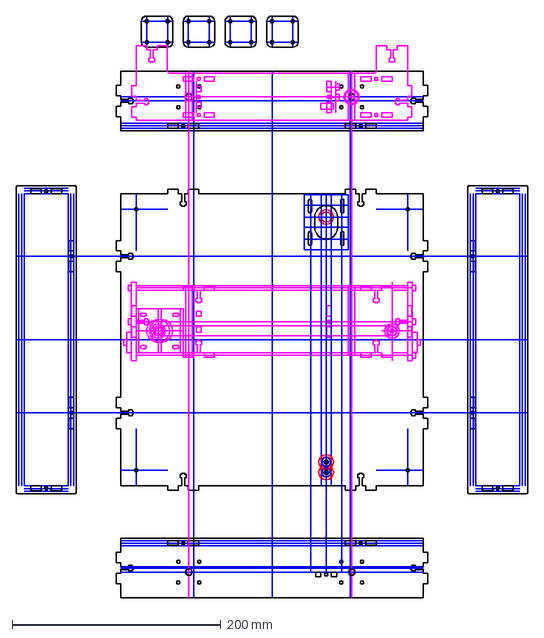
[picture p129: CAD file, 2010-06-25]
tags/thingomatic/primary-stage-tester.dxf
489.6 x 557.3 mm
