jmil/makerbot/trunk/cupcake/carriage1-0.dxf

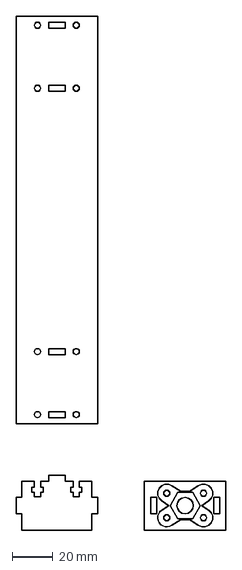
[picture p130: CAD file, 2009-03-01]
trunk/cupcake/carriage1-0.dxf
102.9 x 252.0 mm
