jmil/makerbot/users/charles/paxtruder/Paxtruder-0.4-2009.11.22.2341.dxf

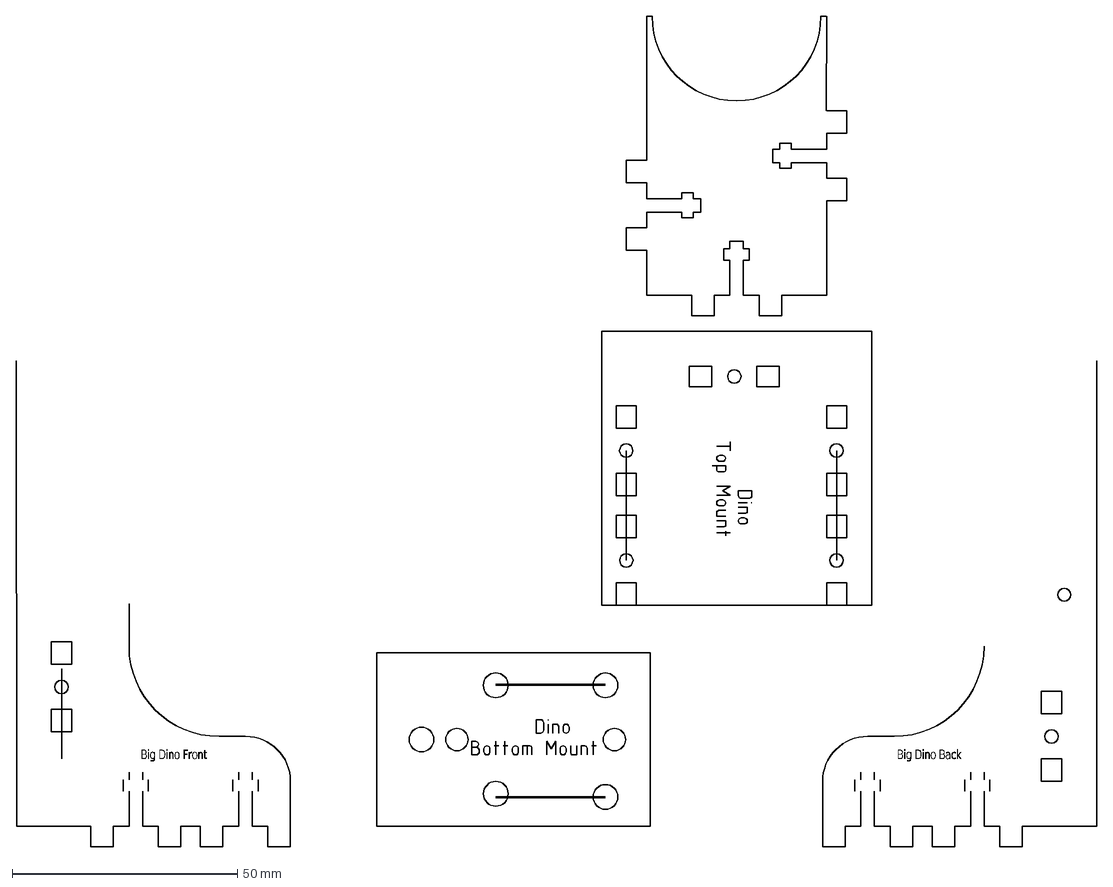
[picture p131: CAD file, 2010-02-21]
users/charles/paxtruder/Paxtruder-0.4-2009.11.22.2341.dxf
Big\~Dino\~Front
Big\~Dino\~Back
