jmil/makerbot/users/hoeken/art/logo.dxf

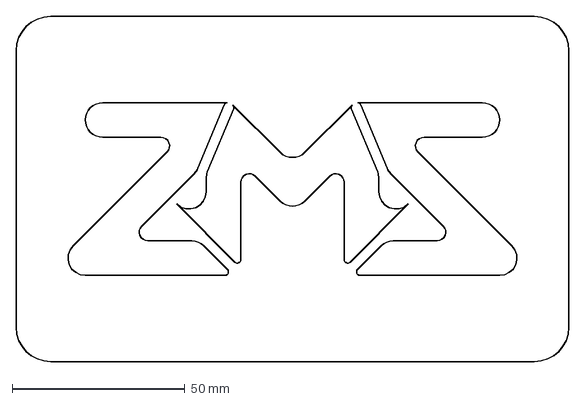
[picture p132: CAD file, 2010-04-07]
users/hoeken/art/logo.dxf
160.0 x 100.0 mm
