jmil/makerbot/users/hoeken/test-rigs/plastruder-fail-force.dxf

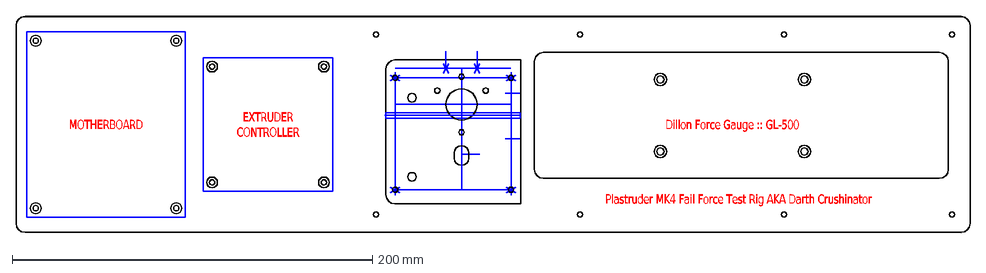
[picture p133: CAD file, 2010-03-04]
users/hoeken/test-rigs/plastruder-fail-force.dxf
EXTRUDER CONTROLLER
MOTHERBOARD
Dillon\~Force\~Gauge\~::\~GL-500
Plastruder\~MK4\~Fail\~Force\~Test\~Rig\~AKA\~Darth\~Crushinator
