jmil/makerbot/tags/thingomatic/xy-stackup.dxf

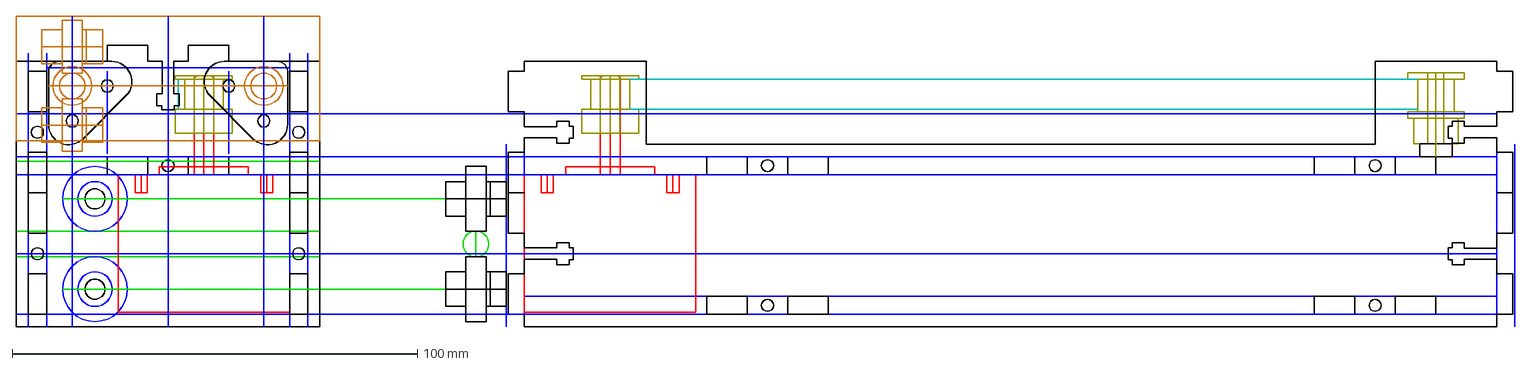
[picture p134: CAD file, 2010-06-19]
tags/thingomatic/xy-stackup.dxf
370.0 x 76.6 mm
