jmil/makerbot/users/charles/paxtruder/Paxtruder-0.2-layout.dxf

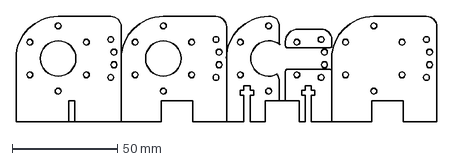
[picture p135: CAD file, 2010-02-21]
users/charles/paxtruder/Paxtruder-0.2-layout.dxf
200.0 x 50.0 mm
