jmil/makerbot/tags/cupcake-cnc-batch-3-4/z-mount.dxf

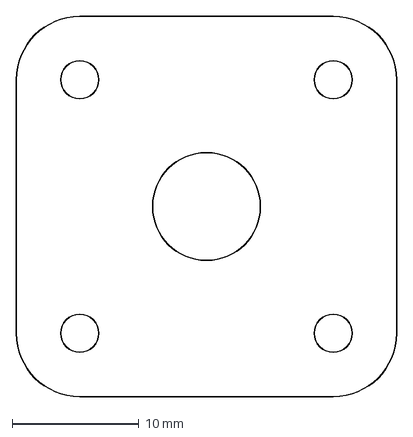
[picture p136: CAD file, 2009-05-09]
tags/cupcake-cnc-batch-3-4/z-mount.dxf
30.0 x 30.0 mm
