jmil/makerbot/tags/thingomatic/idler-bearing-stackup.dxf

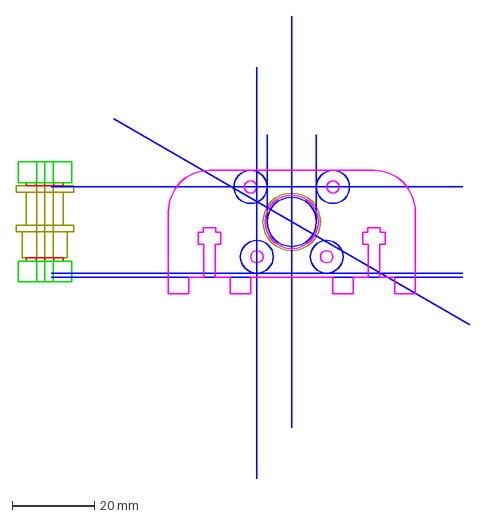
[picture p137: CAD file, 2010-06-19]
tags/thingomatic/idler-bearing-stackup.dxf
110.3 x 112.5 mm
