jmil/makerbot/users/charles/paxtruder/Paxtruder-0.4-2009.11.22.1909.dxf

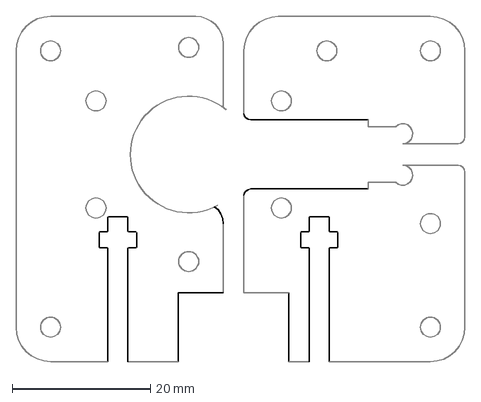
[picture p138: CAD file, 2010-02-21]
users/charles/paxtruder/Paxtruder-0.4-2009.11.22.1909.dxf
65.0 x 50.0 mm
