jmil/makerbot/users/charles/paxtruder/Paxtruder-0.1.dxf

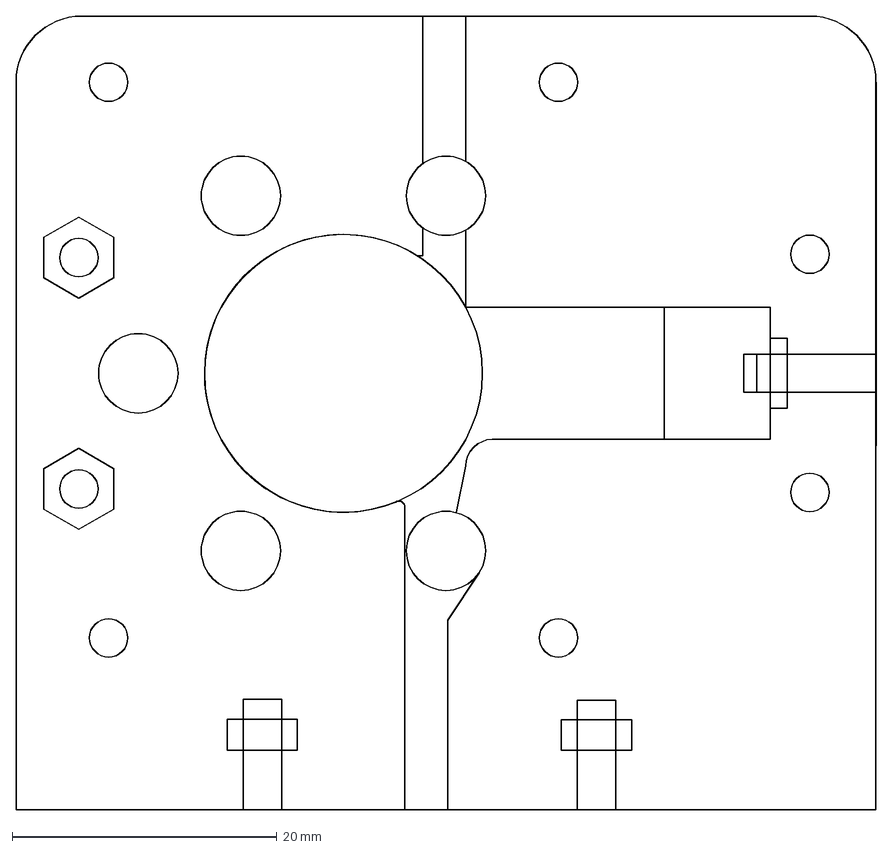
[picture p139: CAD file, 2010-02-21]
users/charles/paxtruder/Paxtruder-0.1.dxf
65.0 x 60.0 mm
