jmil/makerbot/tags/cupcake-cnc-batch-3-4/gator-clip.stl

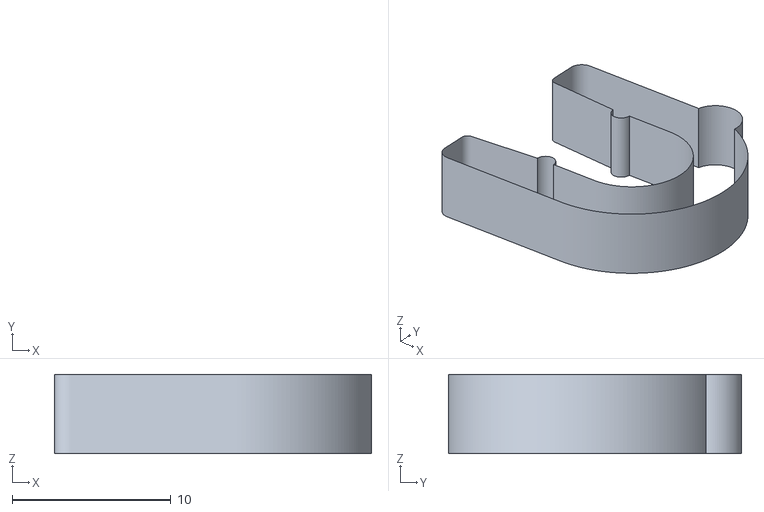
[picture p140: CAD file, 2009-05-03]
tags/cupcake-cnc-batch-3-4/gator-clip.stl
20.0 x 18.5 x 5.00
