jmil/makerbot/users/charles/paxtruder/Paxtruder-0.4-2009.11.29.1735.dxf

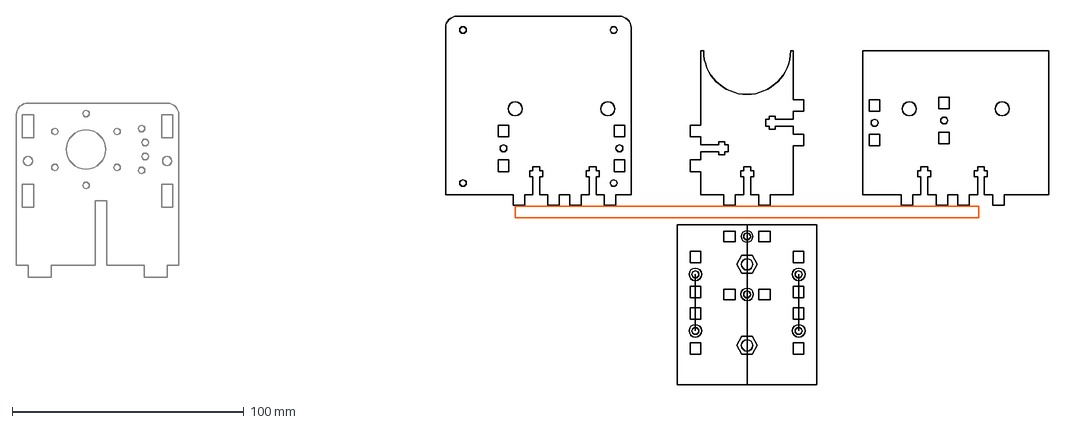
[picture p141: CAD file, 2010-01-02]
users/charles/paxtruder/Paxtruder-0.4-2009.11.29.1735.dxf
445.0 x 159.0 mm
