jmil/makerbot/(list of files, cad)

Other CAD files:
tags/thingomatic/body-assembly.dxf
trunk/filament-spindle/layout.dxf
users/charles/bowden/bowden.dxf
users/charles/conveyor/conveyor-layout.dxf
users/charles/muffin/muffin-z-body.dxf
users/hoeken/makerwave/body.dxf
tags/thingomatic/secondary-stage.dxf
tags/thingomatic/z-stage.dxf
users/charles/bowden/filament-box.dxf
tags/cupcake-cnc-batch-3-4/y-axis-cover.dxf
tags/cupcake-cnc-batch-3-4/cupcake-z-body.dxf
tags/cupcake-cnc-batch-3-4/3d-idler-pulley-606.dxf
tags/cupcake-cnc-batch-3-4/3d-idler-pulley-606.stl
tags/cupcake-cnc-batch-3-4/foamcore-layout.dxf
tags/cupcake-cnc-batch-3-4/gator-clip.dxf
tags/cupcake-cnc-batch-3-4/guides/m8-3mm-plywood-guide.dxf
tags/cupcake-cnc-batch-3-4/idler-pulley-606.dxf
tags/cupcake-cnc-batch-3-4/idler-pulley-608.dxf
tags/frostruder-mk1/frostruder.dxf
tags/frostruder-mk1/frostruder2.dxf
tags/frostruder-mk1/frostruder3.dxf
tags/frostruder-mk1/frostruder5.dxf
tags/frostruder-mk1/frostruder6.dxf
tags/frostruder-mk1/syringe bit.dxf
tags/plastruder-mk4/heater-barrel.dxf
tags/plastruder-mk4/insulator-retainer.dxf
tags/plastruder-mk4/layout-1-8.dxf
tags/plastruder-mk4/layout-3-16.dxf
tags/plastruder-mk4/main-assembly.dxf
tags/plastruder-mk4/nozzle.dxf
tags/plastruder-mk4/thermal-insulator.dxf
trunk/makerscan/mirror_galv_mount.blend
users/hoeken/makerwave/z-drive-screw.dxf
users/hoeken/micro-cnc/washer-jig-1.dxf
users/hoeken/micro-cnc/washer-jig-2.dxf
users/hoeken/micro-cnc/washer-jig-3.dxf
users/hoeken/micro-cnc/washer-jig-4.dxf
users/hoeken/openscad/projector-mount/projector-mount.dxf
users/hoeken/plastruder-mk5/hot-end/thermal-barrier-support.dxf
users/hoeken/plastruder-printable/retainer-washer.dxf
users/hoeken/plastruder-twindrive/drive-screw.dxf
