jmil/makerbot/tags/cupcake-cnc-batch-3-4/rod-cutting-guide.odt

MakerBot Industries Rod Cutting Guide

Instructions for cutting one set of rods:

Z Rods – 4 per set (M8 Threaded Rod)

- Length: 330mm (a hair under 13 inches)
- Cut all M8 Threaded Rod to the same length
- No bevel needed.
- You should be able to get 3 Z rods per 1 meter rod.

Y Rods – 2 per set (M8 Smooth Rod)

- Length: 290mm (about 11-7/16 inches)
- We need the same number of Y rods as X Rods
- Please slightly bevel the ends of the rods.
- You should be able to get 3 Y rods per 3 foot rod.

X Rods – 2 per set (M8 Smooth Rod)

- Length: 170mm (about 6-1/2 inches)
- We need the same number of X rods as Y Rods
- Please slightly bevel the ends of the rods.
- You should be able to get 5 X rods per 3 foot rod.

Please take extra care not to damage the threads or smooth surfaces of the rods as they are critical for smooth operation of our robots.
