jmil/makerbot/trunk/electronics/machine-controller/Instructions.rtf

Files
gerber/BottomCream.pho – Bottom Solder Paste (cream) Layer
gerber/BottomSilkScreen.pho – Bottom Silkscreen Layer
gerber/ComponentTraces.pho – Top (1st) Copper Routing Layer
gerber/Layer2Copper.pho – Second Copper Routing Layer
gerber/Layer3Copper.pho – Third Copper Routing Layer
gerber/CopperTraces.pho – Bottom (4th) Copper Routing Layer
gerber/FabDrawing.pho – Fab Drawing Showing Parts Placement
gerber/dc-servo-controller.drd – Drill Hole Location File
gerber/dc-servo-controller.drl – Drill Size File
gerber/SolderMaskComponent.pho – Top Solder Mask (resist) Layer
gerber/SolderMaskCopper.pho – Bottom Solder Mask (resist) Layer
gerber/TopCream.pho – Top Solder Paste (cream) Layer
gerber/TopSilkScreen.pho – Top Silkscreen Layer

PCB Specifications

4 Layer PCB – Layer Stackup (Top to Bottom):
gerber/ComponentTraces.pho – Top (1st) Copper Routing Layer
gerber/Layer2Copper.pho – Second Copper Routing Layer
gerber/Layer3Copper.pho – Third Copper Routing Layer
gerber/CopperTraces.pho – Bottom (4th) Copper Routing Layer

Please use 1 oz. Copper on all layers.
Black solder mask color.
PCB Material should be FR-4
PCB Thickness should be 0.062”
