jmil/makerbot/tags/electronics/thingomatic-heater-board-1.1/Instructions.rtf

Files
gerber/BottomCream.pho – Bottom Solder Paste (cream) Layer
gerber/BottomSilkScreen.pho – Bottom Silkscreen Layer
gerber/ComponentTraces.pho – Top Copper Routing Layer
gerber/CopperTraces.pho – Bottom Copper Routing Layer
gerber/FabDrawing.pho – Fab Drawing Showing Parts Placement
gerber/thingomatic-heater-board.drd – Drill Hole Location File
gerber/thingomatic-heater-board.drl – Drill Size File
gerber/SolderMaskComponent.pho – Top Solder Mask (resist) Layer
gerber/SolderMaskCopper.pho – Bottom Solder Mask (resist) Layer
gerber/TopCream.pho – Top Solder Paste (cream) Layer
gerber/TopSilkScreen.pho – Top Silkscreen Layer

PCB Specifications
Note: This is a heater board which operates at 110 C.
PCB Material should be FR-4
PCB Thickness should be 0.062”
Please use 2 oz. copper.
Please use red solder mask.
Please fill all vias.
Please make the top solder mask as even as possible. We will bolt an aluminum heat spreader to it.
Please use a high temperature solder mask.
Board is 120 mm x 120 mm
0,0 is lower left corner of board.
