jmil/makerbot/trunk/electronics/magnetic-linear-encoder/Instructions.rtf

Files
gerber/BottomCream.pho – Bottom Solder Paste (cream) Layer
gerber/BottomSilkScreen.pho – Bottom Silkscreen Layer
gerber/ComponentTraces.pho – Top Copper Routing Layer
gerber/CopperTraces.pho – Bottom Copper Routing Layer
gerber/FabDrawing.pho – Fab Drawing Showing Parts Placement
gerber/magnetic-linear-encoder.drd – Drill Hole Location File
gerber/magnetic-linear-encoder.drl – Drill Size File
gerber/SolderMaskComponent.pho – Top Solder Mask (resist) Layer
gerber/SolderMaskCopper.pho – Bottom Solder Mask (resist) Layer
gerber/TopCream.pho – Top Solder Paste (cream) Layer
gerber/TopSilkScreen.pho – Top Silkscreen Layer

PCB Specifications

Please use 1 oz. copper.
Green solder mask color.
PCB Material should be FR-4
PCB Thickness should be 0.062”
