jmil/makerbot/tags/automated-build-platform-v1/belt-dimensions.jpg

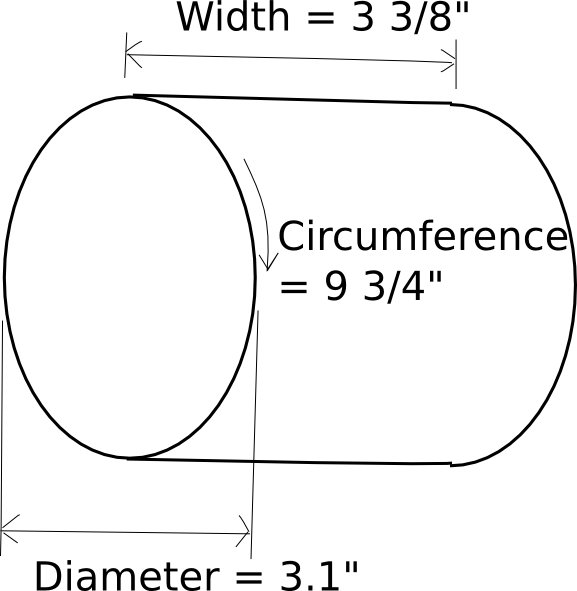
tags/automated-build-platform-v1/belt-dimensions.jpg
