jmil/makerbot/tags/plastruder-mk4/washer-template.pdf

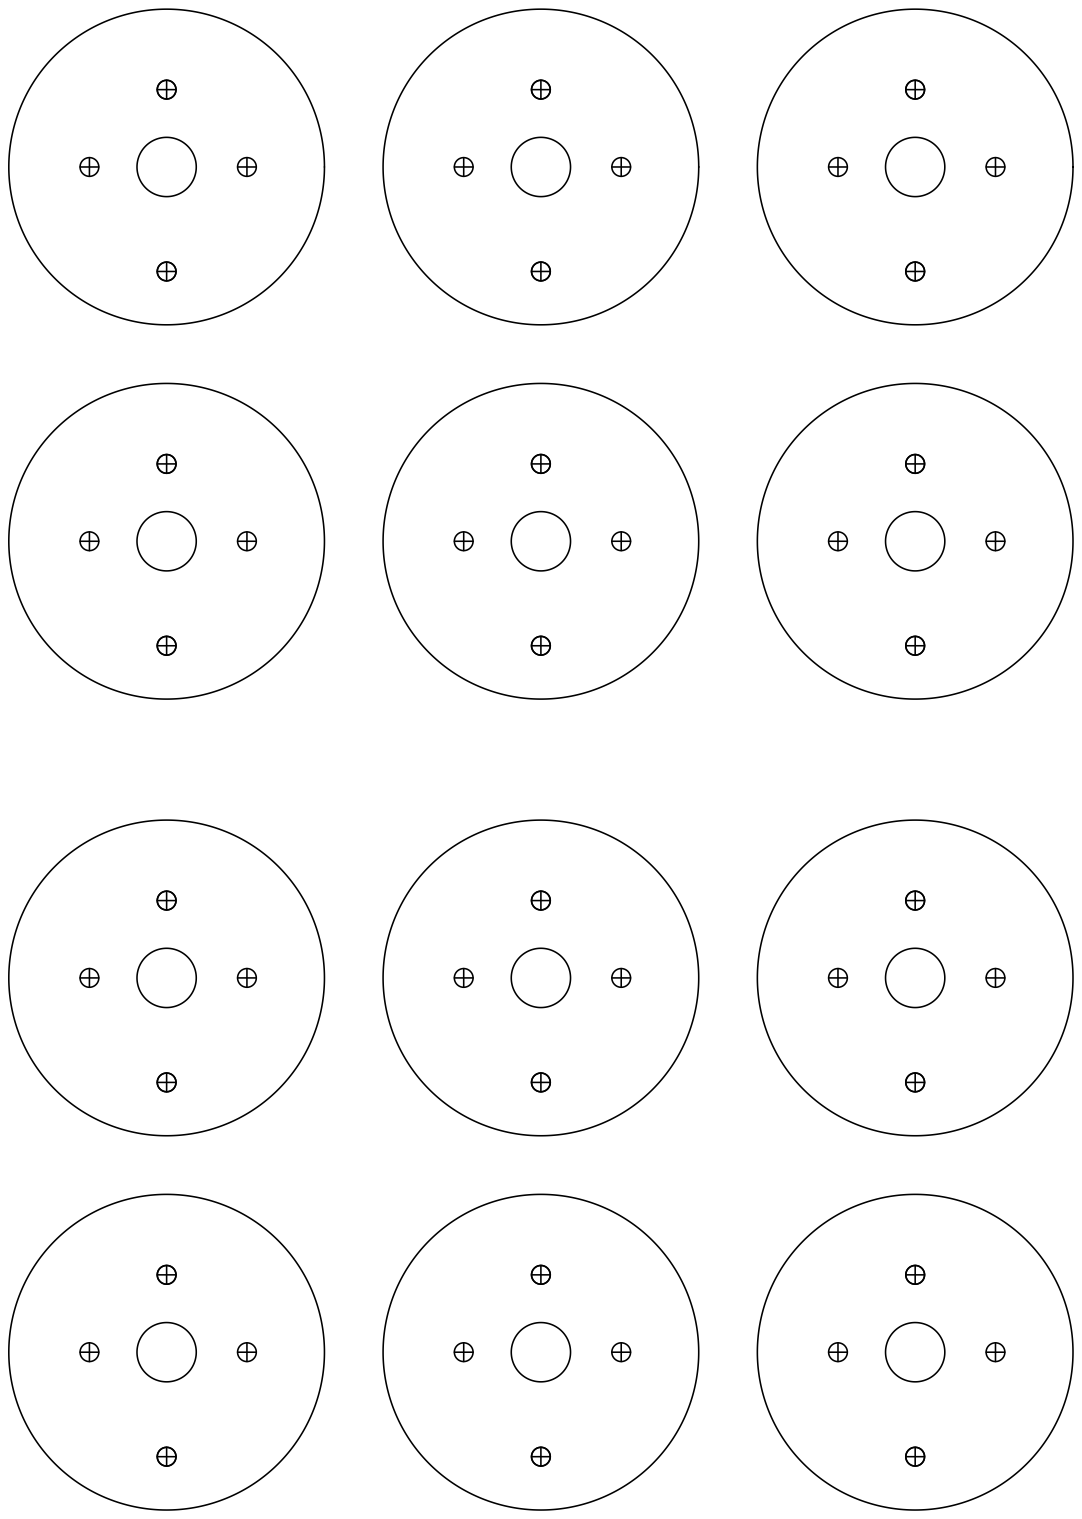
[picture p143: page 1]
