jmil/makerbot/(commit log)

2009-02-25 added basic framework for svn.
2009-03-01 Initial add of cupcake plans
    [M8_c.dxf, breadbox.dxf, catbox.dxf, cheesebox.dxf, cheeseboxlegs.dxf, cupcake with benefits1-0.dxf, cupcake.dxf, cupcake1-3.dxf]
2009-03-01 ok, deleted the lame ones.
    [breadbox.dxf, cheesebox.dxf, cheeseboxlegs.dxf, cupcake with benefits1-0.dxf, cupcake1.dxf, cupcake2.dxf, cupcakecatbox1-6sides1-0.dxf, cupcakecatbox1-6sides1-1.dxf]
2009-03-01 initial checkin of carriage revision
    [carriage1-0.dxf, carriage1-1.dxf]
2009-03-02 move tensioning bolts to allow slide-on
    [carriage1-1.dxf]
2009-03-02 new holes and a slot!
    [cupcake1-4.dxf]
2009-03-02 added mounting points for x carriage
    [carriage1-2.dxf]
2009-03-02 new track mount
    [carriage1-2.dxf]
2009-03-04 initial checkin of roller carriage assmbly
    [roller_carriage_1-0.dxf]
2009-03-04 minus total fail
    [roller_carriage_1-0.dxf]
2009-03-04 deeper holes; shallower tabs; random innuendo
    [roller_carriage_1-0.dxf]
2009-03-04 last cut of obsolete roller carriage; y axis motor mount
    [cc-y-axis-1-0.dxf]
2009-03-04 modifications for cleanup
    [cc-y-axis-1-0.dxf]
2009-03-04 added doc
    [cc-y-axis-1-0.dxf]
2009-03-04 skeleton layout for x axis mechanism
    [cc-x-axis-1-0.dxf]
2009-03-04 skeleton multiplication
    [cc-x-axis-1-0.dxf]
2009-03-04 cuts for motor plate and bridge supports
    [cc-x-axis-1-0.dxf]
2009-03-04 ready for test cut
    [cc-x-axis-1-0.dxf]
2009-03-04 Moved up bearing by 2mm to match top of belt on far end
    [cc-y-axis-1-0.dxf]
2009-03-05 adjusted rod placement (wasn't compensating for clearance I'd already added at edges)
    [cc-x-axis-1-0.dxf]
2009-03-05 added stuff for y axis and to make room for the "disk drives"
    [cupcake1-4.dxf]
2009-03-05 added clamping for belt
    [cc-x-axis-1-0.dxf]
2009-03-06 revisions: two members; more support and bracing; nicer edges
    [cc-x-axis-1-0.dxf]
2009-03-06 finishing up this revision
    [cc-x-axis-1-0.dxf]
2009-03-06 get all changes in
    [cc-x-axis-1-0.dxf]
2009-03-07 4.6 mm wood m3s and disc drive
    [cupcake1-5.dxf]
2009-03-07 Going hi-rise
    [cupcake1-5.dxf]
2009-03-08 fix for break
    [cc-x-axis-1-0.dxf]
2009-03-08 x carriage
    [cc-carriage-1-0.dxf]
2009-03-08 so much more awesome.
    [cupcake1-5.dxf]
2009-03-08 fix for belt alignment issue
    [cc-carriage-1-0.dxf]
2009-03-08 now with improved comb and wider mouth
    [cupcake1-5.dxf]
2009-03-08 added top mounting plate
    [cc-carriage-1-0.dxf]
2009-03-08 fixed the tslots
    [cupcake1-5.dxf]
2009-03-08 now with cable routing holes
    [cupcake1-6.dxf]
2009-03-08 least amount of screw ups so far.
    [cupcake1-7.dxf]
2009-03-09 1st try
    [frostruder.dxf]
2009-03-09 a bit for the inside of the syringe
    [syringe bit.dxf]
2009-03-09 made it a bit bigger and smaller
    [syringe bit.dxf]
2009-03-10 test jig for pressfit bearings
    [test-pressfit-bearing-m8.dxf]
2009-03-10 modified slider holes to accept m8 pressfit bearings
    [cc-carriage-1-0.dxf, cc-x-axis-1-0.dxf]
2009-03-10 differentiate sides, added setscrew access hole
    [cc-x-axis-1-0.dxf]
2009-03-10 version 2 now with all acrylic
    [frostruder2.dxf]
2009-03-10 fixed a few bits
    [frostruder2.dxf]
2009-03-10 better syringe ring... hopefully
    [frostruder2.dxf]
2009-03-11 next one with plates for frostruder and tpe
    [cupcake1-8.dxf]
2009-03-12 updated for prototype
    [frostruder2.dxf]
2009-03-12 Almost done
    [frostruder2.dxf]
2009-03-12 Finished (hopefully)
    [frostruder2.dxf]
2009-03-12 now with bigger and thicker syringe!
    [frostruder2.dxf]
2009-03-12 Yarr doin this for the z stage plate
    [cupcake2-1.dxf]
2009-03-13 still to go: Motormount Power Trap More holes for zip ties check x holes m4 nuts
    [cupcake2-1.dxf]
2009-03-13 testing nuts
    [frostruder2.dxf]
2009-03-18 adding belt latch mechanism to repository.
    [belt_latch.dxf]
2009-03-18 v1.1 of the carriage
    [cc-carriage-1-1.dxf]
2009-03-18 tightened belt clamp (moved over .2mm), added more clearance for unclamped end of belt, added holes for top plate
    [cc-carriage-1-1.dxf]
2009-03-19 next version of y carriage
    [cc-x-axis-1-1.dxf]
2009-03-20 added skeinforge prefs for us to centralize.
    [analyze.csv, behold.csv, carve.csv, clip.csv, comb.csv, comment.csv, cool.csv, export.csv]
2009-03-20 imported plastruder from reprap subversion
    [heater-barrel.dxf, heater-block.dxf, insulator-retainer.dxf, layout-1-4.dxf, layout-1-8.dxf, layout-3-16.dxf, main-assembly.dxf, nozzle.dxf]
2009-03-20 hacked on the layout and such to get ready for production.
    [insulator-retainer.dxf, layout-1-4.dxf, layout-1-8.dxf, layout-3-16.dxf, main-assembly.dxf]
2009-03-20 added mcmaster nameplate templates
    [mcmaster-nameplate-templates.dxf]
2009-03-21 adding "pulley" sides
    [cc-x-axis-1-1.dxf]
2009-03-21 hacked on the plastruder a bit. almost there!
    [insulator-retainer.dxf, main-assembly.dxf]
2009-03-21 WILL SVN EVER WORK
    [cc-x-axis-1-1.dxf, cc-xycuts-1-1.dxf]
2009-03-21 Added cuts for clamping belt
    [cc-x-axis-1-1.dxf]
2009-03-21 cleaned up a file that was messing up qcad.
    [pulley-test.dxf]
2009-03-21 moved frostruder to its own folder.
    [frostruder.dxf, frostruder2.dxf]
2009-03-21 more moving of stuff.
    [analyze.csv, behold.csv, carve.csv, clip.csv, comb.csv, comment.csv, cool.csv, export.csv]
2009-03-22 added 606 idler pulley
    [idler-pulley-606.dxf]
2009-03-22 added the 608 pulley design.
    [idler-pulley-608.dxf]
2009-03-22 hacked on the idler pulley drawings.
    [idler-pulley-606.dxf, idler-pulley-608.dxf]
2009-03-22 adjustments for new, smaller pulley rib directly adjacent to belt slot
    [cc-x-axis-1-1.dxf]
2009-03-23 New and shiny
    [cupcake2-2.dxf]
2009-03-23 fixed top and bottom
    [cupcake2-2.dxf]
2009-03-23 added alternate clamping for carriage
    [cc-carriage-1-1.dxf]
2009-03-23 fixed slots/tbars
    [cupcake2-2.dxf]
2009-03-23 stronger clamp
    [cc-carriage-1-1.dxf]
2009-03-23 fixed some bugs
    [cupcake2-2.dxf]
2009-03-24 updated our skeinforge prefs and hacked on various things a bit more.
    [carve.csv, fill.csv, pulley-test.dxf, raft_ABS.csv, skeinforge.csv, speed.csv]
2009-03-24 added a few useful files.
    [foamcore-template.dxf, makerbot.dxf]
2009-03-24 hacked on the insulator retainer a bunch.
    [insulator-retainer.dxf]
2009-03-24 insulator retainer = go.
    [insulator-retainer.dxf]
2009-03-24 added 2nd dino.
    [main-assembly.dxf]
2009-03-24 added a template for the new 100x100mm build area.
    [foamcore-template-100mm.dxf]
2009-03-25 new version with lots of improvements
    [cupcake2-4.dxf]
2009-03-25 * added opto endstops * flattened bottom of stage * make new cuts setup, including pulley
    [cc-carriage-1-1.dxf, cc-x-axis-1-1.dxf, cc-xycuts-1-1.dxf]
2009-03-25 i think it's done
    [cupcake2-5.dxf]
2009-03-25 little fixes made
    [cupcake2-5.dxf]
2009-03-26 added endstops for y axis fixed slot on carriage
    [cc-carriage-1-1.dxf, cc-x-axis-1-1.dxf, cupcake2-5.dxf]
2009-03-26 new with improved location of boards and tape holder also improved z stage
    [cupcake2-6.dxf]
2009-03-26 added badges and PSD docs to the repo.
    [makerbot.dxf]
2009-03-28 moved around the endstops
    [cupcake2-6.dxf]
2009-03-30 hacked on the build platform for the bot.
    [cc-carriage-1-1.dxf]
2009-03-30 widened slot to accomodate larger pulleys
    [cc-x-axis-1-1.dxf]
2009-03-30 moved the bearing mounting slot
    [cupcake2-6.dxf]
2009-03-31 * lowered endstops 2mm * raised y platform 1mm * adapted to larger bearings * added text to y carriage * added preload tension to bars
    [cc-carriage-1-1.dxf, cc-x-axis-1-1.dxf]
2009-03-31 new with bonus holes
    [cupcake2-7.dxf]
2009-03-31 total cut (still needs text etch)
    [cc-xycuts-1-1.dxf]
2009-04-01 skeinforge prefs rock now.
    [carve.csv, fill.csv, inset.csv, oozebane.csv, skeinforge.csv, speed.csv]
2009-04-01 lots of mini changes!
    [cupcake2-7.dxf]
2009-04-02 removed failmode skeinforge file.
    [skeinforge.csv]
2009-04-02 hacked on skeinforge to move the startup commands to it.
    [export.csv]
2009-04-02 updated raft prefs a bit.
    [raft_ABS.csv]
2009-04-02 more tweeks
    [cupcake2-7.dxf]
2009-04-03 * fixed mounting holes for new bearings * slightly enlarged m8 bearer holes to avoid cracking frame
    [cc-carriage-1-1.dxf, cc-x-axis-1-1.dxf]
2009-04-03 updated fill prefs, assets, and extruder drawings.
    [fill.csv, insulator-retainer.dxf, main-assembly.dxf, makerbot.dxf]
2009-04-04 added text and duplicated parts on x stage created broken-out idler cutsheets
    [cc-x-axis-1-1.dxf, idler-pulley-606-cut.dxf, idler-pulley-608-cut.dxf]
2009-04-04 RC1 cuts.
    [cc-xycuts-1-1.dxf]
2009-04-04 exploded text
    [cc-xycuts-1-1.dxf]
2009-04-04 last bits of unexploded text
    [cc-xycuts-1-1.dxf]
2009-04-04 ... and all layers enabled please.
    [cc-xycuts-1-1.dxf]
2009-04-04 fixed bottom and drawing
    [cupcake2-7.dxf]
2009-04-04 few fixes and added bearing thingamajigs
    [cupcake2-7.dxf]
2009-04-05 little changes
    [cupcake2-7.dxf]
2009-04-05 fix motor/pulley mount positioning
    [cupcake2-7.dxf]
2009-04-05 fixed wonky bit on middle
    [cupcake2-7.dxf]
2009-04-07 * added tie holes for wires * switched labels on front and back of carriage
    [cc-carriage-1-1.dxf, cc-x-axis-1-1.dxf, cc-xycuts-1-1.dxf]
2009-04-07 final final tweaks!
    [cupcake2-7.dxf]
2009-04-07 final pre-production tweaks, added production layout dxfs.
    [insulator-retainer.dxf, layout-1-4.dxf, layout-1-8-four.dxf, layout-1-8-three.dxf, layout-1-8-two.dxf, layout-1-8.dxf, layout-3-16-two.dxf, layout-3-16.dxf]
2009-04-07 hacked on skeinforge prefs some more.
    [carve.csv, comb.csv, fill.csv, inset.csv, raft_ABS.csv]
2009-04-08 removed non-production file.
    [heater-block.dxf]
2009-04-08 added plastruder-mk3 tag.
    [heater-barrel.dxf, insulator-retainer.dxf, layout-1-8-four.dxf, layout-1-8-three.dxf, layout-1-8-two.dxf, layout-1-8.dxf, layout-3-16-two.dxf, layout-3-16.dxf]
2009-04-09 added rod cutting guide.
2009-04-09 updated tag directory to be clean.
    [layout-1-8-four.dxf, layout-1-8-three.dxf, layout-1-8-two.dxf, layout-1-8.dxf, layout-3-16-two.dxf, layout-3-16.dxf]
2009-04-10 added extra rings to cut
    [cc-xycuts-1-1.dxf]
2009-04-11 added foamcore layout.
    [foamcore-layout.dxf]
2009-04-11 exploded foamcore layout
    [foamcore-layout.dxf]
2009-04-11 showed the full drawing.
    [foamcore-layout.dxf]
2009-04-11 erasing olds
    [cupcake1-3.dxf, cupcake1-4.dxf, cupcake1-5.dxf, cupcake1-6.dxf, cupcake1-7.dxf, cupcake1-8.dxf, cupcake2-1.dxf, cupcake2-5.dxf]
2009-04-11 old deleting
    [catbox.dxf, cupcake.dxf, cupcake2-2.dxf, cupcake2-4.dxf, cupcake2-7.dxf]
2009-04-12 * moved a lot of cruft to the archives directory * moved a bunch of test guides to the guides directory * created a cutting-layout directory for cuts * renamed x and y stages to be more clear
    [bearing-sleeve-holes.dxf, belt_latch.dxf, carriage1-0.dxf, carriage1-1.dxf, carriage1-2.dxf, cc-carriage-1-0.dxf, cc-x-axis-1-0.dxf, cupcake-x-stage.dxf]
2009-04-12 a few tweaks to the skeinforge scripts.
    [fill.csv]
2009-04-14 updated the foamcore layout.
    [foamcore-layout.dxf]
2009-04-14 adding build platform layout
    [build_platforms_6.dxf]
2009-04-16 skeinforge prefs are pretty nice now.
    [raft_ABS.csv, speed.csv]
2009-04-20 nuked a bunch of stuff in preparation for cupcake v1
    [M8_c.dxf, belt_latch.dxf, carriage1-0.dxf, carriage1-1.dxf, carriage1-2.dxf, foamcore-template-100mm.dxf, foamcore-template.dxf, idler-pulley-606-cut.dxf]
2009-04-20 Final Final
    [CupcakeBodyFinalFinal.dxf]
2009-04-20 final commits to the first batch design.
    [cupcakefinal.dxf, syringe bit.dxf]
2009-04-20 added experimental prefs dir.
    [behold.csv, carve.csv, clip.csv, comb.csv, comment.csv, cool.csv, export.csv, fill.csv]
2009-04-20 first batch tag.
    [bearing-sleeve-holes.dxf, build_platforms_6.dxf, cupcake-x-stage.dxf, cupcake-xy-layout.dxf, cupcake-y-stage.dxf, foamcore-layout.dxf, idler-pulley-606.dxf, idler-pulley-608.dxf]
2009-04-20 added z body dxf.
    [cupcake-z-body.dxf]
2009-04-20 added missing file.
    [cupcake-z-body.dxf]
2009-04-23 added the new 3d modeled idler pulley.
    [3d-idler-pulley-608.dxf, 3d-idler-pulley-608.stl]
2009-04-28 new body for batch 2
    [cupcakebodybatch2.dxf]
2009-04-28 added words to the small parts
    [cupcakebodybatch2.dxf]
2009-04-29 tweaked the 608 idler design a bit.
    [3d-idler-pulley-608.dxf, 3d-idler-pulley-608.stl]
2009-04-30 fixed a few text bits
    [cupcakebodybatch2.dxf]
2009-05-03 added 606 pulley and the gator clips.
    [3d-idler-pulley-606.dxf, 3d-idler-pulley-606.stl, gator-clip.dxf, gator-clip.stl]
2009-05-04 * added extra endcap support bolt
    [cupcake-x-stage.dxf, cupcake-xy-layout.dxf]
2009-05-05 tweaked the 608 design to be more printable.
    [3d-idler-pulley-608.dxf, 3d-idler-pulley-608.stl]
2009-05-05 just making sure it's here
    [cupcakebodybatch2.dxf]
2009-05-05 holy epic skeinforge update.
    [behold.csv, carve.csv, clip.csv, comb.csv, comment.csv, cool.csv, fill.csv, fillet.csv]
2009-05-05 moved some stuff around.
    [analyze.csv, behold.csv, carve.csv, clip.csv, comb.csv, comment.csv, cool.csv, export.csv]
2009-05-06 Frostruder3 lives
    [frostruder3.dxf]
2009-05-07 just checking in
    [frostruder3.dxf]
2009-05-08 updated skeinforge prefs.
    [analyze.csv, multiply.csv, raft_ABS.csv, skeinview.csv, speed.csv]
2009-05-09 added the covers and such.
    [bearing-cover.dxf, y-axis-cover.dxf, z-mount.dxf]
2009-05-09 oops, no spline.
    [bearing-cover.dxf]
2009-05-11 added parts lists to subversion.
    [Cupcake Parts List.ods, RepRap Master BOM Part 2.ods, RepRap Master BOM.ods]
2009-05-13 removing clamps and rings
    [cupcake-xy-layout.dxf]
2009-05-13 5mm version of the cupcake y stage.
    [cupcake-y-stage-5mm.dxf]
2009-05-13 5mm designs for xy
    [cupcake-x-stage-5mm.dxf, cupcake-xy-layout-5mm.dxf]
2009-05-13 adjusted for non-shorteded end bits
    [cupcake-x-stage-5mm.dxf]
2009-05-14 updated pulley design and moved frostruder file to the right directory.
    [3d-idler-pulley-608.dxf, 3d-idler-pulley-608.stl, frostruder3.dxf]
2009-05-14 removed old cupcake files.
    [CupcakeBodyFinalFinal.dxf, cupcake-z-body.dxf]
2009-05-14 renamed the body dxf.
    [cupcake-z-body.dxf]
2009-05-14 added the batch 2 tag.
    [3d-idler-pulley-606.dxf, 3d-idler-pulley-606.stl, 3d-idler-pulley-608.dxf, 3d-idler-pulley-608.stl, bearing-cover.dxf, bearing-sleeve-holes.dxf, build_platforms_6.dxf, cupcake-x-stage-5mm.dxf]
2009-05-14 removed new files.
    [cupcake-x-stage-5mm.dxf, cupcake-y-stage-5mm.dxf]
2009-05-14 lifting the supports 2mm
    [cupcake-x-stage-5mm.dxf]
2009-05-15 y-shaped y clamp
    [cupcake-y-stage-5mm.dxf]
2009-05-15 new layout
    [cupcake-xy-layout-5mm.dxf]
2009-05-16 updated build platform for new y stage.
    [bearing-cover.dxf, cupcake-y-stage-5mm.dxf]
2009-05-17 added a fix for the belt clamp. now to test.
    [cupcake-y-stage-5mm.dxf]
2009-05-18 moved the idler wheel in one mm and added dino things.
    [main-assembly.dxf]
2009-05-18 hacked on y stage a bit more.
    [cupcake-y-stage-5mm.dxf]
2009-05-18 narrowing magnet and bearing holes
    [cupcake-y-stage-5mm.dxf]
2009-05-19 tweaks to bearing and magnet holes, widen slots as per rt126
    [cupcake-x-stage-5mm.dxf, cupcake-x-stage.dxf, cupcake-y-stage-5mm.dxf, cupcake-y-stage.dxf]
2009-05-19 widen bolt slots
    [cupcake-xy-layout.dxf]
2009-05-19 made sure we reduced build stage magnet holes; reduced bearing holes for reals
    [cupcake-y-stage-5mm.dxf]
2009-05-20 added the acrylic etched build surface.
    [build-surface-2.5mm.dxf]
2009-05-20 hacked on the plastruder a bit.
    [heater-barrel.dxf, insulator-retainer.dxf]
2009-05-20 added electronics dir and first electronics board...
    [led-strip.brd, led-strip.sch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]
2009-05-20 updated the electronics to be makerbot specific.
    [led-strip.brd]
2009-05-25 added build surfaces for cutting.
    [build-surface.dxf, build-surfaces.dxf]
2009-05-25 tweaked the build layout a bit.
    [build-surfaces.dxf]
2009-05-27 tagged batch #3
    [3d-idler-pulley-606.dxf, 3d-idler-pulley-606.stl, 3d-idler-pulley-608.dxf, 3d-idler-pulley-608.stl, analyze.csv, bearing-cover.dxf, bearing-sleeve-holes.dxf, behold.csv]
2009-05-28 added bolt holes to the various parts.
2009-06-02 fixing tags dir.
    [3d-idler-pulley-606.dxf, 3d-idler-pulley-606.stl, 3d-idler-pulley-608.dxf, 3d-idler-pulley-608.stl, bearing-cover.dxf, bearing-sleeve-holes.dxf, build-surface-2.5mm.dxf, build-surface.dxf]
2009-06-02 more fixing
    [analyze.csv, behold.csv, carve.csv, clip.csv, comb.csv, comment.csv, cool.csv, export.csv]
2009-06-02 more fixing of tags
    [3d-idler-pulley-606.dxf, 3d-idler-pulley-606.stl, 3d-idler-pulley-608.dxf, 3d-idler-pulley-608.stl, bearing-cover.dxf, bearing-sleeve-holes.dxf, build-surface-2.5mm.dxf, build-surface.dxf]
2009-06-02 added captive nut holes to most parts.
2009-06-03 added retainer and tons of mods to plastruder mk4
    [retainer.dxf]
2009-06-04 getting closer.... left dino done.
    [z-platform.dxf]
2009-06-04 started work on electronics mount, cleaned up insulator retainer plate, etc.
    [insulator-retainer.dxf, retainer-washer.dxf]
2009-06-04 eliminated a few captive nuts in favor of bolt-on-plastic
2009-06-04 added mount holes for electronics, shrunk it a bit.
2009-06-06 moved all the important files to the plastruder 4 dir.
    [insulator-retainer.dxf, retainer-washer.dxf, z-platform.dxf]
2009-06-06 removed pulley
    [pulley-test.dxf, retainer.dxf]
2009-06-06 moved the plastruder mk4 design to trunk.
    [insulator-retainer.dxf, retainer-washer.dxf, z-platform.dxf]
2009-06-10 adding small rod alterations
    [cupcake-x-stage-small-rods.dxf, cupcake-y-stage-small-rods.dxf]
2009-06-10 cutting test guide
    [small-rod-test-guide.dxf]
2009-06-10 adjusted support holes to better fit rods
    [cupcake-x-stage-small-rods.dxf]
2009-06-10 Fixed holes
    [cupcake-x-stage-small-rods.dxf]
2009-06-11 adding a rod adapter for the new thinner rods
    [rod-adapter.dxf]
2009-06-14 makerscan first version
    [makerscanbody.dxf]
2009-06-14 Now with more flexibility
    [makerscanbody.dxf]
2009-06-15 no idea where this went, but it's back
    [cupcakebodybatch2.dxf]
2009-06-16 added individual parts for outsourcing.
    [back.dxf, bearing-bracket.dxf, bottom.dxf, front.dxf, left.dxf, middle.dxf, power.dxf, right.dxf]
2009-06-16 renamed it to be appropriate.
    [back.dxf, bearing-bracket.dxf, bottom.dxf, front.dxf, left.dxf, middle.dxf, power.dxf, right.dxf]
2009-06-16 added printed parts dir.
2009-06-16 moved some printed parts around.
    [3d-idler-pulley-606.dxf, 3d-idler-pulley-606.stl, idler-pulley-608.dxf, idler-pulley-608.stl]
2009-06-16 nuked a bunch of old files.
    [bearing-cover.dxf, build-surface-2.5mm.dxf, cupcakebodybatch2.dxf, gator-clip.dxf, gator-clip.stl, idler-pulley-606.dxf, idler-pulley-608.dxf, rod-adapter.dxf]
2009-06-16 a bit more reshuffling.
    [build-surface.dxf, cupcake-z-body.dxf, foamcore-layout.dxf]
2009-06-16 argh, more moving.
    [back.dxf, bearing-bracket.dxf, bottom.dxf, front.dxf, left.dxf, middle.dxf, power.dxf, right.dxf]
2009-06-16 Adding designs for 5mm small rod designs that accept 16mm m3 screws
    [cupcake-x-stage-5mm-small-rods.dxf, cupcake-y-stage-5mm-small-rods.dxf]
2009-06-16 added more teeth, adjusted bolts, fix build platform
    [cupcake-y-stage-5mm-small-rods.dxf]
2009-06-16 fix slot widths
    [cupcake-y-stage-5mm-small-rods.dxf]
2009-06-16 removed old production files.
    [cupcake-x-stage-5mm-small-rods.dxf, cupcake-x-stage-5mm.dxf, cupcake-x-stage-small-rods.dxf, cupcake-x-stage.dxf, cupcake-y-stage-5mm-small-rods.dxf, cupcake-y-stage-5mm.dxf, cupcake-y-stage-small-rods.dxf, cupcake-y-stage.dxf]
2009-06-16 updated colors a bit.
    [build-surface.dxf]
2009-06-17 Adapted slot to M5 bearing bolt; lengthened.
    [stage.dxf]
2009-06-18 updated to red etch lines for pololu.
    [back.dxf, bearing-bracket.dxf, bottom.dxf, build-platform.dxf, build-surface.dxf, cap.dxf, clamp.dxf, front.dxf]
2009-06-19 hacked on the 3d assembly a bit more.
    [back.dxf, bearing-bracket.dxf, bottom.dxf, front.dxf, left.dxf, right.dxf, top.dxf]
2009-06-19 added the aoi 3d model.
    [bottom.dxf]
2009-06-19 got most of the thing together.
    [middle.dxf]
2009-06-19 added precompiled firmwares.
    [main-assembly.dxf]
2009-06-23 fixed a couple problems and added the power plate to the 3d model.
    [power.dxf, top.dxf]
2009-06-25 added acme drive mods
    [brass-bearing-adaptor-plate.dxf, press-bearing-adaptor-plate.dxf, z-guide-acme.dxf, z-stage-acme.dxf]
2009-06-25 hacked on the design a bit more... z-stage rocking, various other rods and bits added too.
    [right.dxf, rod-cover.dxf, top.dxf, z-stage.dxf]
2009-06-25 woot, almost finished the z stage.
    [z-guide.dxf]
2009-06-25 added x stage to the 3d model. woot!
    [back.dxf, cap.dxf, clamp.dxf, front.dxf, left.dxf, rib.dxf, right.dxf, stage.dxf]
2009-06-25 added the datasheet for our custom stepper motor.
2009-06-28 renamed makerscan and a few other htings.
    [makerscanbody.dxf, mcmaster-nameplate-templates.dxf]
2009-06-30 hacked on the design a bunch.
    [back.dxf, build-platform.dxf, clamp.dxf, front.dxf, left.dxf, middle.dxf, right.dxf, stage.dxf]
2009-07-01 removed old / unneccessary designs.
    [bearing-sleeve-holes.dxf, build-surfaces.dxf, build_platforms_6.dxf, cupcake-xy-layout-5mm.dxf, cupcake-xy-layout.dxf, foamcore-layout.dxf, m8-3mm-plywood-guide.dxf, small-rod-test-guide.dxf]
2009-07-01 added the y stage to the bot.
    [back.dxf, build-platform.dxf, build-surface.dxf, clamp.dxf, front.dxf, rib.dxf, stage.dxf]
2009-07-01 x/y/z stages looking good.
    [middle.dxf, top.dxf]
2009-07-01 added 608 idler bearings in.
2009-07-01 added linear bearings to the model.
2009-07-01 okay, added nema17 motor drawings to the model.
2009-07-16 updated design for lasermation specs.
    [middle.dxf, top.dxf, z-stage.dxf]
2009-07-16 added tag for batch 5.
    [back.dxf, bearing-bracket.dxf, bottom.dxf, brass-bearing-adaptor-plate.dxf, build-platform.dxf, build-surface.dxf, cap.dxf, clamp.dxf]
2009-07-28 wider hole for power supply connection
    [power.dxf]
2009-07-29 hacked on the plastruder mk4 design
    [insulator-retainer.dxf, layout-1-8.dxf, layout-3-16.dxf, main-assembly.dxf]
2009-07-29 moved the misnamed mk4 design to my home dir.
    [insulator-retainer.dxf, retainer-washer.dxf, z-platform.dxf]
2009-07-29 removed old layout files.
    [layout-1-8-four.dxf, layout-1-8-three.dxf, layout-1-8-two.dxf, layout-3-16-two.dxf]
2009-07-29 added 625 idler pulley design.
    [idler-pulley-625.dxf, idler-pulley-625.stl]
2009-07-29 updated the drawing slightly to fit better.
    [idler-pulley-625.dxf, idler-pulley-625.stl]
2009-07-30 tightening up subtitles, gutter reduced to 3/16th in.
2009-07-31 hacked on the pulleys and a bit more movement.
    [idler-pulley-625.stl, insulator-retainer.dxf, retainer-washer.dxf, z-platform.dxf]
2009-08-05 hacked on the build platform and surface to add m3 bolt mounts.
    [build-platform.dxf, build-surface.dxf]
2009-08-05 tweaked the sizes on a few of the bolt holes and such for the plastruder.
    [main-assembly.dxf]
2009-08-05 added the twindrive experimental part.
    [bottom-plate-inner.dxf, drive-screw.dxf]
2009-08-07 updated build platform, and washer template.
    [build-platform.dxf]
2009-08-08 Few tweaks
    [doublewide.dxf]
2009-08-09 added text and a few changes
    [doublewide.dxf]
2009-08-09 May be quadrupel tall!
    [doubletall.dxf]
2009-08-12 few bug fixes
    [doubletall.dxf]
2009-08-12 updated drive screw drawing.
    [drive-screw.dxf]
2009-08-12 updated mk4 for production.
    [insulator-retainer.dxf, main-assembly.dxf]
2009-08-12 modified cupcake design to use all internal electronics.
    [bottom.dxf, front.dxf, left.dxf, power.dxf, right.dxf]
2009-08-12 did more work on the new body setup.
    [bottom.dxf, left.dxf, middle.dxf, power.dxf, right.dxf]
2009-08-12 updated power plate after real-world test on paper.
    [power.dxf]
2009-08-13 did a bunch of work on the LED strip board.
    [led-strip.brd, led-strip.sch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]
2009-08-13 tagged v1.1 release of the LED strip
    [led-strip.brd, led-strip.sch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]
2009-08-13 added a whole bunch of the reprap boards to makerbot svn to consolidate.
    [extruder-controller.brd, extruder-controller.sch, extruder-controller.xls, magnetic-rotary-encoder.brd, magnetic-rotary-encoder.sch, mechanical-endstop.brd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]
2009-08-13 did a ton of work on the motherboard v3.0
    [motherboard.brd, motherboard.sch]
2009-08-14 tagged mk4 release of the plastruder.
    [heater-barrel.dxf, insulator-retainer.dxf, layout-1-8.dxf, layout-3-16.dxf, main-assembly.dxf, nozzle.dxf, thermal-insulator.dxf]
2009-08-14 added writing
    [doubletall.dxf]
2009-08-16 creating a branch for v2
    [back.dxf, bearing-bracket.dxf, bottom.dxf, brass-bearing-adaptor-plate.dxf, build-platform.dxf, build-surface.dxf, cap.dxf, clamp.dxf]
2009-08-16 Adapting for new connectors, v3.0 endstops
    [back.dxf, front.dxf]
2009-08-16 merging cupcake-v2 back into head
    [back.dxf, front.dxf]
2009-08-16 branch closed
    [back.dxf, bearing-bracket.dxf, bottom.dxf, brass-bearing-adaptor-plate.dxf, build-platform.dxf, build-surface.dxf, cap.dxf, clamp.dxf]
2009-08-17 moved a few thigns around and hacked on other stuff.
    [bottom.dxf, doubletall.dxf, doublewide.dxf, left.dxf, right.dxf]
2009-08-17 Imported firmware sources from reprap repository
    [Configuration.h]
2009-08-17 changing *s bracketing part no. to left/right parens
2009-08-18 moved bres directory
    [doubletall.dxf, doublewide.dxf]
2009-08-18 a couple more fixes.
2009-08-19 * removed SD-support hacked buffer * fixed buffering in fat16 with FAT16_BELAY_SIZE_UPDATE; now no longer writes the directory block on size changes until the file is closed * got all the pipe flushe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
    [PacketProcessor.pde]
2009-08-20 * a few small cleanups, ensuring that multiple remote prints can occur in sequence
2009-08-28 Tagging v1.3 of the firmware
    [Configuration.h]
2009-08-31 * upped to version 1.4 * added WDT reset command to firmware
    [PacketProcessor.pde, SanguinoMaster.pde]
2009-09-01 hacked a bunch on the twindrive extruder design.
    [bottom-plate.dxf, pressure-bearing-drawing.dxf, top-plate.dxf]
2009-09-01 few updates.
    [drive-screw.dxf, top-plate.dxf]
2009-09-01 fixed side panels
    [doublewide.dxf]
2009-09-01 I'm stupid! I fixed it again!
    [doublewide.dxf]
2009-09-01 hacked a ton on the design.
    [front-plate.dxf, top-plate.dxf, totem-pole.dxf]
2009-09-01 shortened by 5cm
    [doubletall.dxf]
2009-09-02 Oops; left out the new stepper code
2009-09-02 Zach has monster titties!
    [totem-pole.dxf]
2009-09-03 worked a bit more on the twindrive.
    [totem-pole.dxf]
2009-09-03 added text and fixed motor mount
    [totem-pole.dxf]
2009-09-07 broke out PSU to .h/.cpp
    [SanguinoMaster.pde]
2009-09-08 Fixup: properly break out of switch statement
    [PacketProcessor.pde]
2009-09-14 new frostruder updated by will
    [frostruder5.dxf]
2009-09-14 Really .6 prototype
    [frostruder6.dxf]
2009-09-14 More small changes
    [frostruder6.dxf]
2009-09-15 Tagging 1.4 firmware
    [Configuration.h]
2009-09-15 Fix for hanging bug in extruder firmware on bad transmit
2009-09-17 updated a bunch of different things.
    [build-surface.dxf, drive-screw.dxf, layout-1-8.dxf, pressure-bearing-drawing.dxf, totem-pole.dxf]
2009-09-17 hacked on the layout a bunch.
    [micro-layout.dxf]
2009-09-17 added all the cnc design file stuff in.
    [bottom-plate.dxf, washer-jig-1.dxf, washer-jig-2.dxf, washer-jig-3.dxf, washer-jig-4.dxf]
2009-09-17 updated layout and created the flush milling script.
    [micro-layout.dxf]
2009-09-18 the surface milling script rocks now.
2009-09-18 added washer drilling script.
2009-09-22 Remove spurious #errors so arduino stops whining like a little baby.
2009-09-24 lots of R&D work coming down the pipe.
    [drive-screw.dxf, motherboard.brd, motherboard.sch, pressure-bearing-drawing.dxf]
2009-09-24 * upped version to 1.5 in extruder firmware
2009-09-24 Tagging firmware for 1.5 release
    [Configuration.h]
2009-09-25 worked on the totem extruder drawing.
    [totem-pole.dxf]
2009-09-28 more R&D.
    [motherboard.brd, motherboard.sch, totem-pole.dxf]
2009-09-29 Refactor of stepper code; fix for homing model
    [SanguinoMaster.pde]
2009-09-30 Start of extruder code refactor
2009-10-01 last bits of refactor before integrating PID patch
2009-10-01 Applied Tim Myrtle's PID heating patch; disabled until we get some params
2009-10-01 Switched on PID control; getting very good results
2009-10-02 Checkin of v1.6 release of firmware
    [Configuration.h]
2009-10-02 updated files with the latest build surfaces.
    [build-platform.dxf, build-surface.dxf]
2009-10-02 renamed the batch stuff a bit.
    [3d-idler-pulley-606.dxf, 3d-idler-pulley-606.stl, 3d-idler-pulley-608.dxf, 3d-idler-pulley-608.stl, bearing-cover.dxf, bearing-sleeve-holes.dxf, build-surface-2.5mm.dxf, build-surface.dxf]
2009-10-03 finished attaching all the pins to appropriate hardware.
    [motherboard.brd, motherboard.sch]
2009-10-06 added and hacked on bres design.
    [frostruder.dxf]
2009-10-06 fixed a few mistakes.
    [frostruder.dxf]
2009-10-07 Automated build for extruder
2009-10-08 added frosting clamps and widened the tippytop.
    [frostruder.dxf]
2009-10-08 moved the solenoids to the inside.
    [frostruder.dxf]
2009-10-11 did some more work on the frostruder.
    [frostruder.dxf]
2009-10-11 tagged old frostruder as mk1
    [frostruder.dxf, frostruder2.dxf, frostruder3.dxf, frostruder5.dxf, frostruder6.dxf, syringe bit.dxf]
2009-10-11 removed old frostruder design.
    [frostruder.dxf, frostruder2.dxf, frostruder3.dxf, frostruder5.dxf, frostruder6.dxf, syringe bit.dxf]
2009-10-11 moved frostruder mk2 to trunk.
    [frostruder.dxf]
2009-10-11 added mount holes, added rubber band cutouts, etc.
    [totem-pole.dxf]
2009-10-12 reverted to old mounting holes.
    [totem-pole.dxf]
2009-10-12 fixed mounting holes and worked on the plastruder design.
    [frostruder.dxf, totem-pole.dxf]
2009-10-18 fixing the power section of the plate.
    [power.dxf]
2009-10-18 updated teh design for production. need real measurements on solenoid.
    [frostruder.dxf]
2009-10-18 separated out top/bottom clamps.
    [bottom-clamp.dxf, frostruder.dxf, top-clamp.dxf]
2009-10-21 worked on the motherboard a bunch.
    [motherboard.brd, motherboard.sch]
2009-10-22 routed the x/y/z stepper headers.
    [motherboard.brd, motherboard.sch]
2009-10-22 29 airwires left.
    [motherboard.brd, motherboard.sch]
2009-10-24 Mounting for connectors on new crazy solenoids
    [frostruder.dxf]
2009-10-25 finished routing the motherboard!
    [motherboard.brd, motherboard.sch]
2009-10-25 a few tweaks for the mk5 design.
    [insulator-retainer.dxf, main-assembly.dxf]
2009-10-25 created a nice, compact rotary encoder with simple connector.
    [magnetic-rotary-encoder.brd, magnetic-rotary-encoder.sch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]
2009-10-25 added new rotary encoder board to plastruder mk5.
    [magnetic-rotary-encoder.brd, magnetic-rotary-encoder.dxf, main-assembly.dxf]
2009-10-26 nuked the old firmware dirs.
    [Configuration.h]
2009-10-26 got the plastruder up and running.
    [main-assembly.dxf, plastruder.scad]
2009-10-27 added a bunch of mods for the mk5 design.
    [main-assembly.dxf]
2009-10-27 added rough draft of magnetic linear encoder.
    [magnetic-linear-encoder.brd, magnetic-linear-encoder.sch, magnetic-rotary-encoder.brd]
2009-10-27 finished the rough draft on the linear encoder.
    [magnetic-linear-encoder.brd, magnetic-linear-encoder.sch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]
2009-10-27 a few last minute tweaks pre-release.
    [magnetic-linear-encoder.brd, magnetic-linear-encoder.sch, magnetic-rotary-encoder.brd, magnetic-rotary-encoder.sch]
2009-10-28 cleaned up mobo v2.0 to prep for release.
    [motherboard.brd, motherboard.sch]
2009-10-28 fixed a silkscreen problem on the magnetic rotary encoder.
    [magnetic-rotary-encoder.brd]
2009-10-28 fixed an offset bug in the mle.
    [magnetic-linear-encoder.brd, magnetic-linear-encoder.sch]
2009-10-28 did a bit of hacking.
    [main-assembly.dxf]
2009-10-28 started work on v3.0 of the extruder controller.
    [extruder-controller.brd, extruder-controller.sch]
2009-10-28 did motherboard .drl.
    [motherboard.drl]
2009-10-29 fixed a couple silkscreen bugs and added a couple things to the motherboard.
    [extruder-controller.brd, extruder-controller.sch, magnetic-linear-encoder.brd, magnetic-linear-encoder.sch, magnetic-rotary-encoder.brd, magnetic-rotary-encoder.sch, motherboard.brd, motherboard.sch]
2009-10-29 added silkscreen to the mobo.
    [motherboard.brd, motherboard.sch]
2009-10-29 reordered the stepepr things.
    [motherboard.sch]
2009-10-29 hacked on the design a bunch. dual-head!
    [main-assembly.dxf]
2009-10-30 worked a bunch on the layering. getting closer.
    [main-assembly.dxf]
2009-10-30 audited all the pins on the ec v3.0
    [extruder-controller.brd, extruder-controller.sch]
2009-10-31 i think i finished the schematic. up next: layout + routing.
    [extruder-controller.brd, extruder-controller.sch]
2009-10-31 ugh. been fighing with this design for too long today.
    [main-assembly.dxf]
2009-11-01 worked on the extruder controller board a bit.
    [extruder-controller.brd, extruder-controller.sch]
2009-11-02 added the proper holes for the frostruder valves.
    [frostruder.dxf]
2009-11-02 added frostruder valve datasheet
2009-11-02 cleaned up the frostruder drawing.
    [frostruder.dxf]
2009-11-02 consolidated clamp files.
    [bottom-clamp.dxf, clamp.dxf]
2009-11-02 tagged and bagged the frostruder mk2.
    [clamp.dxf, frostruder.dxf]
2009-11-02 autorouted the extruder controller. not bad for a first run. 97%
    [extruder-controller.brd, extruder-controller.sch]
2009-11-03 extruder controller laid out and silkscreened. just gotta check any errors then its off to production.
    [extruder-controller.brd, extruder-controller.sch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]
2009-11-03 ec v3.0 ready for production.
    [extruder-controller.brd]
2009-11-08 mk5 is ready for prototype.
    [main-assembly.dxf]
2009-11-08 updated a bit of hole spacing and such.
    [main-assembly.dxf, plastruder.scad]
2009-11-09 started working on the openscad design
    [main-assembly.dxf, plastruder.scad]
2009-11-10 dinos are complete in openscad.
    [main-assembly.dxf, plastruder.scad]
2009-11-10 insulator retainers are ready to rock.
    [main-assembly.dxf, plastruder.scad]
2009-11-10 openscad model is pretty much done.
    [main-assembly.dxf, plastruder.scad]
2009-11-10 moved some nut holes around a bit.
    [main-assembly.dxf]
2009-11-11 MakerBot Watch!
    [MBW1.brd, MBW1.sch]
2009-11-12 moved makerbot watch to trunk.
    [MBW1.brd, MBW1.sch]
2009-11-12 tidied up files.
    [watch.brd, watch.sch]
2009-11-12 worked on bres design a bit.
    [watch.brd, watch.sch]
2009-11-13 updated and fixed bugs on MLE v1.1
    [magnetic-linear-encoder.brd, magnetic-linear-encoder.sch]
2009-11-13 updated to eagles drc.
    [magnetic-linear-encoder.brd]
2009-11-14 Adding test platform
    [test_platform.dxf]
2009-11-14 initial commit of 3d models
    [mirror_galv_mount.blend, mounting_ring.scad]
2009-11-15 updated the mounting ring drawing.
    [mounting_ring.scad]
2009-11-15 hacked on the mobo design a bit more.
    [motherboard.brd, motherboard.sch]
2009-11-15 worked on the mobo a bit.
    [motherboard.brd]
2009-11-15 switched to M5, switched to 1/8 filament guide, made mounts better, bigger washer, etc.
    [main-assembly.dxf, plastruder.scad]
2009-11-16 fixed a minor bug with the frostruder.
    [frostruder.dxf, frostruder.scad]
2009-11-16 modeled the crap out of the frostruder.
    [clamp.dxf, frostruder.scad]
2009-11-16 removed unneccessary caps.
    [stepper-motor-driver.brd, stepper-motor-driver.sch]
2009-11-16 Hmm, I had this committed and now recommitting. Odd.
    [MBV2.dxf]
2009-11-17 implemented a few of nopheads fixes.
    [stepper-motor-driver.brd, stepper-motor-driver.sch]
2009-11-18 Yup, it's almost done
    [MBV2.dxf]
2009-11-19 First complete version
    [MBV2.dxf]
2009-11-19 split the front down themiddle.
    [MBV2.dxf]
2009-11-19 added zstage
    [MBV2.dxf]
2009-11-19 2nd spacer plate, narrower filament guide, wider dinos, no front edge of dinos, all corners rounded, and dinos hug motor tighter.
    [main-assembly.dxf]
2009-11-20 bug fixed!
    [MBV2.dxf]
2009-11-22 added rough cut of cantilevered z stage.
    [z-stage.dxf]
2009-11-23 fixed xy
    [MBV2.dxf]
2009-11-23 fixed the switch issue
    [watch.sch]
2009-11-23 switch size fixed
    [watch.brd]
2009-11-23 added production files.
    [extruder-controller.brd, extruder-controller.sch, stepper-motor-driver.brd, watch.brd, watch.sch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]
2009-11-23 Modification for right-angle version of switch
    [mechanical-endstop.brd, mechanical-endstop.sch]
2009-11-23 added variants of omron switch to lib
2009-11-24 watch case prototype
    [watchcase.dxf]
2009-11-29 started work on flipping the bitch.
    [body.dxf]
2009-11-29 started work on flipping the x stage.
    [x-stage.dxf]
2009-11-29 almost done with x stage.
    [x-stage.dxf]
2009-11-29 x finished all critical parts of x stage. almost ready for first cut.
    [x-stage.dxf]
2009-11-30 added inital outside frame. this is looking good!
    [makerwave.dxf]
2009-11-30 got the y axis integrated with the frame. electronics in too.
    [makerwave.dxf, x-stage.dxf]
2009-11-30 renamed file to be accurate.
    [y-axis.dxf]
2009-11-30 updated cantilever z stage to work with new design.
    [makerwave.dxf, z-axis.dxf]
2009-11-30 added z axis drawings to main layout.
    [makerwave.dxf]
2009-12-01 got the preliminary upper z mount up and running.
    [makerwave.dxf]
2009-12-01 worked on the z axis a bit and other stuff.
    [z-axis.dxf, z-drive-screw.dxf]
2009-12-03 fixed what is hopefully the final bug and made it all single sided.
    [magnetic-linear-encoder.brd, magnetic-linear-encoder.sch, main-assembly.dxf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]
2009-12-03 hacked on the extruder controller a bit more.
    [extruder-controller.brd, extruder-controller.sch]
2009-12-03 fixed the walls and stuff.
    [makerwave.dxf]
2009-12-04 updated power panel and more tweaks.
    [makerwave.dxf, model.scad]
2009-12-04 removed old file.
    [body.dxf]
2009-12-04 renamed file properly.
    [body.dxf]
2009-12-04 got a new code name.
    [body.dxf, model.scad, y-axis.dxf, z-axis.dxf, z-drive-screw.dxf]
2009-12-04 got the body modeled in openscad.
    [body.dxf, model.scad]
2009-12-04 added drive pulley drawing
    [extruder-drive-pulley.dxf]
2009-12-06 added interface, fixed tab bugs, and a bunch of general hackery.
    [body.dxf]
2009-12-06 hacked on the interface a bunch.
    [body.dxf, z-axis.dxf]
2009-12-06 added the interface board.
    [interface.brd, interface.sch]
2009-12-06 hacked on the interface board a ton.
    [interface.brd, interface.sch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]
2009-12-06 Makerbot pop-up holiday card initial checkin
    [pop-bot.dxf]
2009-12-06 stretching bottom to make it look a bit less squat
    [pop-bot.dxf]
2009-12-06 looking proper now.
    [interface.brd, interface.sch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]
2009-12-06 body + xy is ready to cut.
    [body.dxf, y-axis.dxf]
2009-12-06 z axis and body are ready for testing.
    [body.dxf, z-axis.dxf]
2009-12-06 all lasercut
    [watchcase.dxf]
2009-12-06 small changes
    [watchcase.dxf]
2009-12-07 fixed a couple minor mistakes in teh design.
    [body.dxf]
2009-12-07 more bits
    [watchcase.dxf]
2009-12-07 just a pocketwatch and a wristwatch.
    [watchcase.dxf]
2009-12-07 a few more last minute tweaks.
    [body.dxf]
2009-12-07 hacked on the mech endstop design a bit more.
    [mechanical-endstop.brd, mechanical-endstop.sch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]
2009-12-07 renamed mech endstop board for production
    [mechanical-endstop.brd, mechanical-endstop.sch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]
2009-12-07 hacked on the ec 3.1 board a bunch.... re-added h-bridge, etc.
    [body.dxf, extruder-controller.brd, extruder-controller.sch]
2009-12-08 fixed some of the bugs from the prototype cut.
    [body.dxf, z-axis.dxf]
2009-12-08 added tensioning motor mount to the design.
    [body.dxf]
2009-12-08 implemented a ton of nopheads suggestions and routed a bunch of traces.
    [stepper-motor-driver.brd, stepper-motor-driver.sch]
2009-12-08 finished routing v3.1 pcb.
    [stepper-motor-driver.brd]
2009-12-09 stepper driver is ready for production... just need nopheads okay.
    [stepper-motor-driver.brd, stepper-motor-driver.sch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]
2009-12-09 a small silkscreen tweak.
    [stepper-motor-driver.brd]
2009-12-09 this motherboard is gonna be a fucker to route.
    [extruder-controller.brd, extruder-controller.sch, motherboard.brd, motherboard.sch]
2009-12-09 implemented a bunch of nopheads suggestions.
    [stepper-motor-driver.brd, stepper-motor-driver.sch]
2009-12-10 a bit more mobo routing.
    [motherboard.brd, motherboard.sch]
2009-12-10 added catarinas shapes library.
    [extruder-drive-pulley.dxf, shapes.scad]
2009-12-11 okay, ready for v3.1 prototype.
    [stepper-motor-driver.brd]
2009-12-11 hacked a bit on various designs.
    [body.dxf, extruder-worm-pulley.dxf]
2009-12-11 worked on the extruder a bit more.
    [extruder-controller.brd, extruder-controller.sch]
2009-12-12 routed most of the board.
    [extruder-controller.brd, extruder-controller.sch]
2009-12-12 new extruder controller routed. waiting on adrians feedback now.
    [extruder-controller.brd, extruder-controller.sch]
2009-12-14 did a bunch of work on the y axis.
    [y-axis.dxf]
2009-12-14 small fix on the y axis
    [y-axis.dxf]
2009-12-14 added first cut x-stage.
    [stage.dxf, x-axis.dxf, z-stage.dxf]
2009-12-14 x axis tweaks.
    [x-axis.dxf]
2009-12-15 did a bunch of fixes from the first cut.
    [y-axis.dxf]
2009-12-15 a few more tweaks to the design.
    [body.dxf, y-axis.dxf]
2009-12-15 standardized the bracket mounts.
    [body.dxf]
2009-12-17 finished adrians changes and routed most of it.
    [extruder-controller.brd, extruder-controller.sch]
2009-12-17 more routing... time to autoroute.
    [extruder-controller.brd]
2009-12-17 woot. finished routing the latest version.
    [extruder-controller.brd, extruder-controller.sch]
2009-12-17 extruder controller should be ready for production.
    [extruder-controller.brd, extruder-controller.sch]
2009-12-17 the interface board is almost ready for action.
    [interface.brd, interface.sch]
2009-12-17 board finished, ready for production.
    [extruder-controller.brd, extruder-controller.sch]
2009-12-17 okay. shouts added. board ready for production.
    [extruder-controller.brd]
2009-12-17 tagged v3.1 release of extruder controller.
    [extruder-controller.brd, extruder-controller.sch, extruder-controller.xls, stepper-motor-driver-2.3.xls, stepper-motor-driver.brd, stepper-motor-driver.sch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]
2009-12-17 board is ready for production.
    [interface.brd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]
2009-12-17 tagged v1.0 interface.
    [interface.brd, interface.sch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]
2009-12-17 hacking on the motherboard a bit more.
    [motherboard.brd, motherboard.sch]
2009-12-22 pants status: in iowa
    [extruder-controller.brd, extruder-controller.sch, motherboard.brd]
2009-12-23 this board is gonna rock! front face should be done
    [motherboard.brd, motherboard.sch]
2009-12-23 i think i fixed all the footprint issues.
    [motherboard.brd, motherboard.sch]
2009-12-30 trying out motherboard with 4 layers.
    [motherboard.brd, motherboard.sch]
2009-12-30 4 layer mobo is almost done.
    [motherboard.brd, motherboard.sch]
2009-12-30 motherboard is 100% routed. fuck yeah.
    [motherboard.brd, motherboard.sch]
2009-12-30 fixed a bunch of drc errors in the layout.
    [motherboard.brd, motherboard.sch]
2010-01-01 added missing drawing.
    [mk5-machined-parts.dxf]
2010-01-01 worked on a bunch of updates to the designs.
    [extruder-drive-pulley.dxf, mk5-machined-parts.dxf]
2010-01-02 did a bunch more hacking on the new mobo design.
    [motherboard.brd]
2010-01-02 more finishing touches on the motherboard.
    [motherboard.brd, motherboard.sch]
2010-01-02 Filament drive mechanism designed for MakerBot Industries by Charles Edward Pax <charles.pax@gmail.com>.
    [bowden.dxf]
2010-01-02 Removed some unnecessary layers from the original Pastruder design.
    [bowden.dxf]
2010-01-02 moved some parts around and switched to a straight in ethernet connector.
    [motherboard.brd, motherboard.sch]
2010-01-02 silkscreen is done and board looks good.
    [motherboard.brd, motherboard.sch]
2010-01-02 added lasercut files for a series of test rigs.
    [plastruder-fail-force.dxf]
2010-01-03 updates with appropriate license.
    [watch.brd, watch.sch]
2010-01-03 changed font size in license
    [watch.sch]
2010-01-03 Removed A few more Paxtruder parts. The thumb screw nut will be removable.
    [bowden.dxf]
2010-01-04 motherboard ready for prototype.
    [motherboard.brd, motherboard.sch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]
2010-01-04 added electronics mounts to the test rig.
    [plastruder-fail-force.dxf]
2010-01-05 A NEMA 17 may now also be used with the same design. Assembly holes moved to 32 mm for NEMA 17 mounting. Motor plate layer hole widened to accomidate a NEMA 17 shoulder.
    [bowden.dxf]
2010-01-05 Changed housing size to match with NEMA 17 motor.
    [bowden.dxf]
2010-01-05 Added mount system for encoder board.
    [bowden.dxf]
2010-01-05 Updated encoder board drawing. Motor mount bolt heads are no longer recessed in the retainer plate because the encoder board will fit between them; this allows the bolts to be removed without removin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
    [bowden.dxf]
2010-01-05 retainingMechanism.png - Added a sketch of a mechanism to retain the connector.
    [bowden.dxf]
2010-01-05 A few minor fixes.
    [bowden.dxf]
2010-01-05 Trivial changes.
    [bowden.dxf]
2010-01-06 I'm having trouble with blocks disappearing. Added bowden-layout.dxf.
    [bowden-layout.dxf, bowden.dxf]
2010-01-06 Changed the encoder mount to accomidate washers. Enlarged the thumb screw nut slot.
    [bowden-layout.dxf, bowden.dxf]
2010-01-06 Added a notes document containing design parameters and general notes. Changed bowden.dxf to include the captive coupling design elements from retainingMechanism-0.2.png. The T-slots may be a weak po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
    [bowden-layout.dxf, bowden.dxf]
2010-01-06 Added the new drive pulley.
    [bowden.dxf]
2010-01-07 modified extruder controller a bit.
    [extruder-controller.brd, extruder-controller.sch]
2010-01-07 Modified the filament guide layer to accomidate a 3 mm filament. Enlarged encoder board mounting nut holes in filament guide layer.
    [bowden.dxf]
2010-01-07 Minor cleanup.
    [bowden.dxf]
2010-01-07 Relocated coupling hole based on a thinner filament drive layer.
    [bowden.dxf]
2010-01-07 Changed filament layer thickness to reflect a 3.18 mm acetal sheet. Added a layout SVG. Make coupling retaining layer screw holes approximately square about the extrusion hole. Minor changes to accom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
    [bowden-layout.dxf, bowden.dxf]
2010-01-08 Minor fixes.
    [bowden-layout.dxf, bowden.dxf]
2010-01-08 Changed thumb screw slot to accomidate an M3 screw due to the thinner layer. Fixed coupling retainer to match the body thickness. Added a plunger to the filament guide layer.
    [bowden.dxf]
2010-01-08 updated layout and SVG.
    [bowden-layout.dxf]
2010-01-08 Added some curves. Smallerized the pusher.
    [bowden.dxf]
2010-01-09 Added a corrugated cardboard filament spool like the one found at http://cardboardspools.com/corrugated_reels.htm.
    [spool.dxf]
2010-01-12 Added the filament box.
    [filament-box.dxf]
2010-01-12 extruder v3.2 pcb is basically ready for production.
    [extruder-controller.brd, extruder-controller.sch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]
2010-01-12 replaced all 0805 caps/resistors/leds with the sparkfun library.
    [interface.brd, interface.sch, magnetic-linear-encoder.brd, magnetic-linear-encoder.sch, magnetic-rotary-encoder.brd, magnetic-rotary-encoder.sch, mechanical-endstop.brd, mechanical-endstop.sch]
2010-01-12 Filament box is coming along nicely. It needs modifications to accomidate the drive mechanism.
    [filament-box.dxf]
2010-01-13 Done for the day.
    [filament-box.dxf]
2010-01-13 extruder v3.2 ready for production.
2010-01-13 a bunch of tweaks to the various electronics boards.
    [extruder-controller.brd, extruder-controller.sch, magnetic-linear-encoder.brd, magnetic-linear-encoder.sch, mechanical-endstop.brd]
2010-01-13 added heated build platform from jordan.
    [heated-build-platform.brd, heated-build-platform.sch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]
2010-01-14 extended board area to prevent broken traces.
    [heated-build-platform.brd]
2010-01-14 a few last minute tweaks of the stepper driver. mostly cosmetic.
    [stepper-motor-driver.brd, stepper-motor-driver.sch]
2010-01-14 couldnt help it... io expander board.
    [expandio.brd, expandio.sch]
2010-01-14 added the 3 chips i want to the expandio.
    [expandio.brd, expandio.sch]
2010-01-18 Added a drive mechanism drawing. Moved reel axis to middle of box body. Filament drive mechanism will be bolted to the box top using the four bolts around the filament output. The box top is in three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
    [bowden-layout.dxf, bowden.dxf, filament-box-layout.dxf, filament-box.dxf]
2010-01-18 Changed box size because the 12x24 inch wood was actually a bit short.
    [filament-box-layout.dxf, filament-box.dxf]
2010-01-18 Added a filament-box-layout-svg.
2010-01-19 Changed spool size to better fit the filament box.
    [spool.dxf]
2010-01-19 legacy commit.
    [expandio.brd, mk5-machined-parts.dxf]
2010-01-19 tidied up a bunch of stuff.
    [drive-pulley.dxf, extruder-worm-pulley.dxf, heater-block.dxf]
2010-01-19 moved drive pulley to proper location.
    [drive-pulley.dxf]
2010-01-19 broke out the proper files.
    [heater-block.dxf, nozzle.dxf, ptfe-barrier.dxf]
2010-01-20 fix for new idler pulleys.
    [cap.dxf, front.dxf]
2010-01-23 did a bit more work on the plastruder parts.
    [heater-block.dxf, nozzle.dxf, ptfe-barrier.dxf]
2010-01-23 updated the new machined parts for production.
    [drive-pulley.dxf, heater-block.dxf, nozzle.dxf, ptfe-barrier.dxf]
2010-01-24 did a bit of work on a few boards.
    [expandio.brd, expandio.sch, interface.brd, interface.sch]
2010-01-24 did a bunch of wiring work on the board.
    [expandio.brd, expandio.sch]
2010-01-25 Added outline for extrude conroller board. Changed the height, so the reel fits in the box. I'm considering moving the drive mechanism further off center to allow the extruder controller board to fit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
    [filament-box.dxf]
2010-01-25 Changed the gender of the filament box bottom face. This gives an extra 5 mm of vertical clearence for the filament reel.
    [filament-box.dxf]
2010-01-25 Added an extruder controller board graphic. Reversed the orientation and location of the extruder to allow access to the controller board's screw terminals. The controller board can be mounted to the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
    [filament-box.dxf]
2010-01-25 Bowden and filament-box SVG layouts are ready to be laser cut in prototype.
    [filament-box-layout.dxf, filament-box.dxf]
2010-01-25 switched to arduino for PWM/servo outputs.
    [expandio.brd, expandio.sch]
2010-01-25 added input buffers to all input pins.
    [expandio.brd, expandio.sch]
2010-01-25 output buffers implemented now.
    [expandio.brd, expandio.sch]
2010-01-25 added the heat spreader file.
    [heat-spreader.dxf]
2010-01-25 added glass build surface file.
    [glass-build-surface.dxf]
2010-01-25 added cupcake heater board and a few tweaks to expandio.
    [cupcake-heater-board.brd, cupcake-heater-board.sch, expandio.sch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]
2010-02-07 modified the heat spreader plate.
    [heat-spreader.dxf]
2010-02-08 got the design ready for v1.1
    [cupcake-heater-board.brd, cupcake-heater-board.sch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]
2010-02-08 final tweaks to the design.
    [cupcake-heater-board.brd, cupcake-heater-board.sch]
2010-02-11 removed old heated platform.
    [cupcake-heater-board.brd, heated-build-platform.brd, heated-build-platform.sch, motherboard.brd, motherboard.sch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]
2010-02-11 added a central hole for thermistor.
    [cupcake-heater-board.brd]
2010-02-14 Widened thubm screw nut path.
    [bowden.dxf]
2010-02-15 Lengthened the pusher. Widened the gap between the thumb screw nut retaining bolts.
    [bowden.dxf]
2010-02-16 Added a conveyor belt design.
    [conveyor.dxf]
2010-02-16 Added a shavt retainer plate. Decreased bushing hole size.
    [conveyor.dxf]
2010-02-16 widened the bushing holes.
    [conveyor.dxf]
2010-02-16 Last few adjustments before going home.
    [conveyor.dxf]
2010-02-17 Added drawings for the heated build platform. Started a version to be made of acetal.
    [conveyor-acetal.dxf]
2010-02-17 Added some notes: use a push-to-connect fitting! Changed the conveyor design a little: the side will be made of Delrin rather than wood with a bushing or bearing.
    [conveyor-acetal.dxf]
2010-02-19 Adding heated plat support
2010-02-19 Small design changes. Added links to the conveyor purchase list.
    [conveyor-acetal.dxf]
2010-02-20 Added a conveyor design that includes a tensioner.
    [conveyor-acetal-with-tensioner.dxf]
2010-02-20 Minor changes.
    [conveyor-acetal-with-tensioner.dxf]
2010-02-20 Minor conveyor fixes.
    [conveyor-acetal-with-tensioner.dxf]
2010-02-21 Added paxtruder-0.1.
    [Paxtruder-0.1.dxf]
2010-02-21 Paxtruder-0.2, paxtruder-0.3, and paxtruder-0.4 added.
    [Paxtruder-0.2-layout.dxf, Paxtruder-0.2-pusher.dxf, Paxtruder-0.2.dxf, Paxtruder-0.3-layout.dxf, Paxtruder-0.3.dxf, Paxtruder-0.4-2009.11.22.1909.dxf, Paxtruder-0.4-2009.11.22.2233.dxf, Paxtruder-0.4-2009.11.22.2341.dxf]
2010-02-21 Added the muffin CNC.
    [muffin-z-body.dxf]
2010-02-24 a bit of work on the heater and interface.
    [cupcake-heater-board.brd, cupcake-heater-board.sch, extruder-controller.brd, extruder-controller.sch, interface.brd, interface.sch]
2010-02-24 updated files for production.
    [cupcake-heater-board.brd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]
2010-02-24 a few tweaks to designs.
    [heater-block.dxf, right.dxf]
2010-02-24 added a couple new prototype ideas.
    [heater-block.dxf, hex-heater-block.dxf, thermal-break.dxf]
2010-02-24 a few changes to the x front and plastruder.
    [cap.dxf, cupcake-heater-board.brd, front.dxf, heat-spreader.dxf, main-assembly.dxf]
2010-02-25 Added an alternative drive mechanism mounting plate. This will allow the removal of the retaining plate from the drive mechanism and better expose the pipe fittin for the bowden tube.
    [conveyor-acetal-with-tensioner.dxf, filament-box.dxf]
2010-02-26 got the 2nd prototype design ready.
    [hex-heater-block.dxf]
2010-02-26 removed old heater block.
    [heater-block.dxf]
2010-02-26 renamed hex heater block back to old one.
    [heater-block.dxf]
2010-03-01 fixed a minor silkscreen bug.
    [interface.brd]
2010-03-01 started expandio2 board, updated script to handle top and bottom gerbers.
    [expandio.brd, expandio.sch]
2010-03-04 rotated extruder and moved gauge a bit closer.
    [plastruder-fail-force.dxf]
2010-03-04 moved old dev stuff to its own folder.
    [MBV2.dxf, back.dxf, bearing-bracket.dxf, bottom.dxf, brass-bearing-adaptor-plate.dxf, build-platform.dxf, build-surface.dxf, cap.dxf]
2010-03-04 added kapton diecut drawing.
    [kapton-diecut.dxf]
2010-03-04 next prototype version.
    [heater-block.dxf]
2010-03-05 added conveyor table drawing.
    [arm.dxf]
2010-03-05 changed page size on kapton.
    [kapton-diecut.dxf]
2010-03-05 moved the tag.
    [back.dxf, bearing-bracket.dxf, bottom.dxf, brass-bearing-adaptor-plate.dxf, build-platform.dxf, build-surface.dxf, cap.dxf, clamp.dxf]
2010-03-05 moved it back to cupcake.
    [back.dxf, bearing-bracket.dxf, bottom.dxf, brass-bearing-adaptor-plate.dxf, build-platform.dxf, build-surface.dxf, cap.dxf, clamp.dxf]
2010-03-07 its working!
    [arm.dxf]
2010-03-15 Added a thermal barrier, heater barrel, and nozzle to the bowden drive mechanism drawing. Also added a version of the coupling retainer plate to hold a thermal barrier in place. It looks like no sign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
    [bowden.dxf]
2010-03-15 Added bowden-washer-compatible.dxf. (off the clock)
    [bowden-washer-compatible.dxf]
2010-03-15 Removed bowden-washer-compatble. The centers of the thermal barrier and washer holes will not form a line. (off the clock)
    [bowden-washer-compatible.dxf]
2010-03-16 added test rig for motherboard and stepper drivers
    [motherboard-stepper-driver.dxf]
2010-03-16 The bowden filament drive mechanism is now also the new Paxtruder. I added extra parts to bowden.dxf for using with a thermal barrier, heater barrel, and nozzle, and for mounting. (off the clock)
    [bowden.dxf]
2010-03-18 Added a paxtruder/bowden layout files ready for cutting.
    [bowden-layout.dxf]
2010-03-18 added better heat pad for the v3.3 and updated teh schematic
    [extruder-controller.brd, extruder-controller.sch]
2010-03-18 switched the led strip board to all SMT.
    [led-strip.brd, led-strip.sch]
2010-03-19 finished the v3.3 rev of the extruder controller.
    [extruder-controller.brd, extruder-controller.sch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]
2010-03-19 connected TC to ground for better readings.
    [extruder-controller.brd, extruder-controller.sch]
2010-03-19 worked on the mobo and started a mega footprint.
    [motherboard.brd, motherboard.sch]
2010-03-19 forked mobo shield
    [motherboard-1.2.xls, motherboard.brd, motherboard.sch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]
2010-03-20 rerouted the entire shield in a couple hours. AAAARGH!
    [motherboard.brd, motherboard.sch]
2010-03-20 added the solar snarfer circuit.
    [micro_solar.brd, micro_solar.sch]
2010-03-20 solar snarfer circuit ready for prototyping!.
    [micro_solar.brd, micro_solar.sch]
2010-03-20 added a tiny regulator to the library.
2010-03-20 a bunch of work on the solar snarfer board.
    [micro_solar.brd, micro_solar.sch]
2010-03-20 renamed stuff properly.
    [solar-snarfer.brd, solar-snarfer.sch]
2010-03-20 rearranged stuff.
    [solar-snarfer.brd, solar-snarfer.sch]
2010-03-20 Added thumb schrew retaining screw holes to the filimant guide layer. (Off the clock)
    [bowden.dxf]
2010-03-20 Change the bowden-layout.dxf and bowden-layout.svg to include changes from bowden.dxf.
    [bowden-layout.dxf]
2010-03-20 got v1.0 ready for production.
    [solar-snarfer.brd, solar-snarfer.sch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]
2010-03-21 finished layout and routing. final check is all thats left.
    [motherboard.brd, motherboard.sch]
2010-03-21 did one last check of the pins.
    [motherboard.sch]
2010-03-21 removed old mobo design.
    [motherboard-1.2.xls, motherboard.brd, motherboard.sch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]
2010-03-21 moved to the proper folder.
    [motherboard-1.2.xls, motherboard.brd, motherboard.sch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]
2010-03-21 updated drill cfg and prepped for production
    [motherboard.brd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]
2010-03-21 one last silkscreen mod
    [motherboard.brd]
2010-03-22 Added two holes to the bowden extruder mounting bracket for mounting the retaining screws for the thermal barrier washer. Now a custom, flanged thermal barrier is unnecessary. An upgrade kit can now 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
    [bowden.dxf]
2010-03-22 Minor filament box changes.
    [filament-box.dxf]
2010-03-22 Added a divider to the spool.
    [spool.dxf]
2010-03-23 Changed mount to accomidate the washer retaining holes.
    [bowden-layout.dxf, bowden.dxf]
2010-03-24 Flipped the washer retaining holes, so the mount opening is toward the front to ease maintenance. Added the tube fittings to the bowden notes.
    [bowden.dxf]
2010-03-24 final tweaks before production.
    [stepper-motor-driver.brd, stepper-motor-driver.sch]
2010-03-26 did a ton of work on an arduino thingie.
    [cupcake-heater-board.brd, cupcake-heater-board.sch, expandio.brd, expandio.sch, extruder-controller.brd, extruder-controller.sch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]
2010-03-26 renamed board.
    [extruder-controller.brd, extruder-controller.sch, extruder-controller.xls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]
2010-03-26 more cleanup.
    [extruder-controller.xls]
2010-03-26 more renaming.
    [arduino-dev-stick.brd, arduino-dev-stick.sch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]
2010-03-26 making progress on the dev boards.
    [arduino-dev-stick.brd, arduino-dev-stick.sch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]
2010-03-29 added adaptor for mk4
    [mk4-adaptor.dxf]
2010-03-29 added plastruder test rig
    [plastruder-test-rig.dxf]
2010-03-30 lots of updates to my personal stuff
    [arm.dxf, mk4-adaptor.dxf, plastruder-test-rig.dxf]
2010-03-30 added test rig for plastruder extrusion
    [plastruder-test-rig.dxf]
2010-03-31 modified extruder to my liking.
    [bowden.dxf]
2010-04-01 All M3 bolt holes are now 1.5 mm radius. Some were 1.45 mm as an adjustment for kerf on the NYC Resistor laser.
    [bowden.dxf]
2010-04-01 Added layer material and thickness notes to bowden.
    [bowden.dxf]
2010-04-01 Bowden box M3 bolt holes are now 1.5 mm radius rather than 1.45 mm radius.
    [filament-box.dxf]
2010-04-01 Corrections made to bowden material list. Thicknesses are now correct.
    [bowden.dxf]
2010-04-05 added smoothing caps to extruder controller.
    [extruder-controller.brd, extruder-controller.sch]
2010-04-05 added some fixes and such for ec v3.4.
    [extruder-controller.brd, extruder-controller.sch]
2010-04-05 did some work on the MK5 hot end stuff.
    [drive-pulley.dxf, ss-heater-block.dxf]
2010-04-05 renamed to drive gear.
    [drive-pulley.dxf]
2010-04-07 added my art folder!
    [atom.dxf, logo.dxf]
2010-04-07 Adding endstop test rig
    [endstop test rig.dxf]
2010-04-09 updated file with better retainer design.
    [bowden.dxf]
2010-04-09 added design for hand prototyping.
    [diy-heater-block.dxf]
2010-04-11 added parabola design.
    [trough.dxf]
2010-04-11 added layout sheets.
    [sheet-1.dxf, sheet-2.dxf, sheet-3.dxf, trough.dxf]
2010-04-12 added arduino code
2010-04-12 started work on next prototypes
    [ptfe-barrier.dxf, thermal-barrier-support.dxf, thermal-break.dxf]
2010-04-12 combined nozzle and heater block
    [heater-block.dxf, ss-heater-block.dxf]
2010-04-12 housekeeping for next block of prototypes.
    [nozzle-block.dxf, nozzle.dxf]
2010-04-12 final tweaks before prototype round 3
    [nozzle-block.dxf, thermal-barrier-support.dxf]
2010-04-13 added tester firmware script.
    [motherboard.sch]
2010-04-14 added the mobo test rig.
    [motherboard-test-rig.dxf]
2010-04-14 finished first cut of the test rig.
    [motherboard-test-rig.dxf]
2010-04-15 a few more tweaks to the test rig
    [motherboard-test-rig.dxf]
2010-04-15 fixed the top panel to be much more user friendly.
    [motherboard-test-rig.dxf]
2010-04-15 added 450mm parabola.
    [foo.dxf]
2010-04-15 Fix for slow-heat problem.
2010-04-15 Add stepped heating to HBP
2010-04-16 Repairing hole alignment between platform and surface
    [build-platform.dxf]
2010-04-16 started merging for MK5 release.
    [bowden-layout.dxf, bowden.dxf, drive-pulley.dxf, filament-box-layout.dxf, filament-box.dxf, spool.dxf]
2010-04-16 combined mk5-hot-end stuff with plastruder lasercut stuff.
    [diy-heater-block.dxf, drive-gear.dxf, mk4-adaptor.dxf, nozzle-block.dxf, thermal-barrier-support.dxf]
2010-04-16 more tidying up of stuff.
    [bowden-layout.dxf, bowden.dxf, diy-heater-block.dxf, drive-pulley.dxf]
2010-04-16 moved filament box files to their own folder.
    [filament-box-layout.dxf, filament-box.dxf]
2010-04-16 more moving around of things
    [bowden.dxf, diy-heater-block.dxf, drive-gear.dxf, mk4-adaptor.dxf, nozzle-block.dxf, spool.dxf, thermal-barrier-support.dxf]
2010-04-16 renamed filament drive file.
    [filament-drive.dxf]
2010-04-16 added my custom mods to the box.
    [feed-box.dxf, filament-box-cut-1.dxf, filament-box-cut-2.dxf, filament-box-cut-3.dxf]
2010-04-17 added a gear to one side of the spindle.
    [feed-box.dxf]
2010-04-18 added lolcat
    [lolcat.dxf]
2010-04-18 added resistor dxf.
    [resistor.dxf, resistorflake.dxf]
2010-04-19 added horizontal table spindle.
    [horizontal-table.dxf]
2010-04-19 worked on the mk5 and filament box.
    [filament-drive.dxf, horizontal-table.dxf]
2010-04-19 should be ready for prototyping.
    [horizontal-table.dxf]
2010-04-19 rounded the tslots a bit.
    [horizontal-table.dxf]
2010-04-19 nuked old files in the spindle directory
    [feed-box.dxf, filament-box-cut-1.dxf, filament-box-cut-2.dxf, filament-box-cut-3.dxf, filament-box-layout.dxf, filament-box.dxf, spool.dxf]
2010-04-19 renamed folder.
    [horizontal-table.dxf]
2010-04-19 renamed filament spindle file.
    [filament-spindle.dxf]
2010-04-19 added bolt holes and layout files.
    [filament-spindle.dxf, layout-1.dxf, layout-2.dxf, layout-3.dxf]
2010-04-20 added the makerbot text and such.
    [filament-spindle.dxf]
2010-04-20 spindle is almost ready for production prototype
    [filament-spindle.dxf, layout-1.dxf, layout-2.dxf, layout-3.dxf]
2010-04-20 Bifurcating the "cap.dxf" files to keep both in order
    [cap-back.dxf, cap-front.dxf]
2010-04-20 Removed redundant line segments that have been there since the dawn of time
    [cap-back.dxf, cap-front.dxf]
2010-04-20 Adding a dxf file for the old build platforms.
    [pre-batch 5 build platform.dxf]
2010-04-20 re-did final layout for 3-16" acrylic test.
    [filament-spindle.dxf, layout-1.dxf, layout-2.dxf, layout-3.dxf]
2010-04-21 exploded layout 3
    [layout-3.dxf]
2010-04-21 added missing holes. argh!
    [filament-spindle.dxf, layout-1.dxf]
2010-04-21 changed up the whole filament pathways stuff.
    [filament-spindle.dxf, layout-1.dxf, layout-2.dxf, layout-3.dxf]
2010-04-22 modified the spindle for production prototype.
    [filament-spindle.dxf, layout.dxf]
2010-04-22 sent production files off to lasermation.
    [filament-spindle.dxf, layout.dxf]
2010-04-23 moved filament spindle to trunk.
    [filament-spindle.dxf, layout.dxf]
2010-04-23 tagged the mk1 filament spindle release.
    [filament-spindle.dxf, layout.dxf]
2010-04-23 added groove for PTFE cap cover.
    [nozzle-block.dxf]
2010-04-23 added mk5 retainer board.
    [mk5-retainer.brd, mk5-retainer.sch]
2010-04-23 added new retainer board.
    [mk5-retainer.brd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]
2010-04-23 added taste tester to test printing speeds.
2010-04-26 Added an MK4 adapter to the Dino Bracket layer or the MK5 drive mechanism. This will allow the MK4 hot end to be used with the MK5 laser cut parts.
    [filament-drive.dxf]
2010-04-28 Changed conveyor.dxf to be motorized.
    [conveyor-layout.dxf, conveyor.dxf]
2010-04-28 a ton of work on all the scripts across the board.
2010-04-28 added test gcode file.
    [test.dxf]
2010-04-29 added test2 dxf file.
    [test2.dxf]
2010-05-02 fixed the url!
    [filament-spindle.dxf]
2010-05-04 removed old test files.
    [test.dxf, test2.dxf]
2010-05-04 added the default frostforge prefs.
    [behold.csv, carve.csv, clip.csv, comb.csv, comment.csv, cool.csv, export.csv, fill.csv]
2010-05-04 tweaked the filament spindle design for lower cost and manufacturability.
    [filament-spindle.dxf, layout.dxf]
2010-05-05 pre-production updates and tweaks.
    [filament-drive.dxf, layout-acrylic.dxf, layout-delrin.dxf, thermal-barrier-support.dxf]
2010-05-06 tweaked the tabs to work with plywood.
    [filament-spindle.dxf, layout.dxf]
2010-05-08 added tp holder design.
    [arm.dxf, arm.stl, inner-tube.stl, outer-tube.stl, tp-holder.scad]
2010-05-08 tweaked the filament drive a bit.
    [filament-drive.dxf]
2010-05-10 tweaked height and spindle diameter for final production prototype. rev D.
    [filament-spindle.dxf, layout.dxf]
2010-05-10 v2.3 ready for production
    [motherboard.brd, motherboard.sch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]
2010-05-11 tweaked a few hole placements.
    [filament-drive.dxf]
2010-05-11 made a small tweak.
    [filament-drive.dxf]
2010-05-11 symmetrized filament drive mount and reset all t slots to 16mm.
    [filament-drive.dxf]
2010-05-11 hacked a ton on the new plastruder design.
    [filament-drive.dxf]
2010-05-12 added some random openscad stuff.
    [projector-mount.dxf, projector-mount.scad, projector-mount.stl, shelf.scad, strut-profile.dxf]
2010-05-12 added some initial sketches for mk6.
    [filament-drive.dxf, sketch1.dxf, sketch2.dxf]
2010-05-12 more plastruder tweaks.
    [filament-drive.dxf]
2010-05-12 added a tab to the motor plate and fixed a spacing issue.
    [filament-drive.dxf, shelf.scad]
2010-05-12 added old art files.
    [harshicord.dxf, rose.dxf]
2010-05-12 fixed the mount bug and added a few extra tabs.
    [filament-drive.dxf]
2010-05-12 fully parametrized the tp arm.
    [arm.dxf, arm.stl, inner-tube.stl, outer-tube.stl, tp-holder.scad]
2010-05-12 moved things to proper layers.
    [filament-drive.dxf]
2010-05-13 Edited the conveyor design. Added a bend test rig.
    [bend-test.dxf, conveyor.dxf]
2010-05-13 turned off drawing layer.
    [filament-spindle.dxf]
2010-05-13 not quite the final design.;
    [filament-spindle.dxf, layout.dxf]
2010-05-13 added the latest spindle design.
    [filament-spindle.dxf, layout.dxf]
2010-05-13 tweaked the bolt path.
    [filament-drive.dxf]
2010-05-14 rounded base corners more.
    [filament-drive.dxf]
2010-05-14 added the branding.
    [filament-spindle.dxf]
2010-05-14 re-did the mk5 retainer with new spacing.
    [mk5-retainer.brd]
2010-05-17 a few cosmetic teweaks and a re-layout.
    [filament-drive.dxf, layout-acrylic.dxf, layout-delrin.dxf]
2010-05-17 updated the layout with the proper file.
    [layout.dxf]
2010-05-17 did some preliminary investigations into the mk6 design.
    [mockup.scad]
2010-05-18 tweaked the design a bit.
    [mockup.scad]
2010-05-18 added lathe tool to scad.
    [lathe-tool.scad]
2010-05-18 To conveyor, added tensioning geometry and scraper.
    [conveyor-acetal-with-tensioner.dxf, conveyor-acetal.dxf, conveyor-layout.dxf, conveyor.dxf]
2010-05-18 Added a conveyor-layout.svg file.
2010-05-19 To conveyor.dxf added a motor cable arrester to remove strain from the motor-wire solder joints. Updated conveyor-layout.dxf and .svg.
    [conveyor-layout.dxf, conveyor.dxf]
2010-05-19 To conveyor design added two more shaft gears to test size.
    [conveyor-layout.dxf, conveyor.dxf]
2010-05-19 From conveyor design removed the extra test gears. Current gears now work well.
    [conveyor-layout.dxf, conveyor.dxf]
2010-05-19 iteration 1 of alpha firmware eliminates oversampling bug introduced w/ configurable sample time periods
2010-05-21 did a bunch of stuff.
    [sketch.dxf]
2010-05-22 Updated conveyor layout stuff.
    [conveyor-layout.dxf, conveyor.dxf]
2010-05-23 added some tech crunch disrupt designs.
    [cube.stl, cuboid.stl, design.scad, m.dxf, wire_harness.scad]
2010-05-24 did a bunch of mods based on the latest prototypes.
    [nozzle-block.dxf, nozzle.dxf]
2010-05-24 renamed a few parts for consistancy.
    [heater-block.dxf, thermal-barrier-tube.dxf]
2010-05-24 a few cleanups for pre-production.
    [heater-block.dxf, nozzle.dxf]
2010-05-25 added the noise suppressor circuitry.
    [mk5-retainer.brd, noise-suppressor.brd, noise-suppressor.sch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]
2010-05-26 got the noise suppressor circuit ready for production.
    [noise-suppressor.brd, noise-suppressor.dxf, noise-suppressor.sch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]
2010-05-26 Moving tool-sweet from users/hoeken
    [behold.csv, carve.csv, clip.csv, comb.csv, comment.csv, cool.csv, export.csv, fill.csv]
2010-05-26 Moved to trunk/frostruder/tool-sweet
    [behold.csv, carve.csv, clip.csv, comb.csv, comment.csv, cool.csv, export.csv, fill.csv]
2010-05-28 fixed a bug with the dinos.
    [filament-drive.dxf, layout-acrylic.dxf, layout-delrin.dxf]
2010-05-28 fixed a layout bug
    [layout-acrylic.dxf]
2010-05-28 fixed the hole spacing to match mk5
    [magnetic-rotary-encoder.brd, magnetic-rotary-encoder.sch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]
2010-05-28 fixed a typo in noise suppressor.
    [noise-suppressor.sch]
2010-06-01 switched to 2.2k resistor for 12v indicator.
    [extruder-controller.brd, extruder-controller.sch, motherboard.brd, motherboard.sch]
2010-06-01 added templates.
    [inch_full_scale.dxf, inch_half_scale.dxf, mm_full_scale.dxf, mm_half_scale.dxf]
2010-06-01 Modified for Kysan 1153029 motor.
    [conveyor-layout.dxf, conveyor.dxf]
2010-06-01 Added conveyor layout to include press fit test gears.
    [conveyor-layout.dxf]
2010-06-02 a few more fixes to the tester code.
    [tester.pde]
2010-06-03 a few pre-production tweaks.
    [motherboard.brd, motherboard.sch]
2010-06-03 some pre-production tweaks to the design.
    [extruder-controller.brd, extruder-controller.sch]
2010-06-03 To conveyor, added drawings for 17 mm and 20 mm Kysan motors.
    [conveyor.dxf]
2010-06-03 To conveyor added mount for brush.
    [conveyor-layout.dxf, conveyor.dxf]
2010-06-04 added smoother sketch.
    [smoother.scad]
2010-06-04 added cape to the plastruder design.
    [filament-drive.dxf]
2010-06-06 removed old plastruder trunk.
    [heater-barrel.dxf, insulator-retainer.dxf, layout-1-8.dxf, layout-3-16.dxf, main-assembly.dxf, nozzle.dxf, plastruder.scad, thermal-insulator.dxf]
2010-06-06 added note on heater block.
    [heater-block.dxf]
2010-06-06 did a bunch of pre-release cleanup.
    [diy-heater-block.dxf, sketch.dxf]
2010-06-06 moved the mk5 design to trunk.
    [drive-gear.dxf, filament-drive.dxf, heater-block.dxf, layout-acrylic.dxf, layout-delrin.dxf, mk4-adaptor.dxf, nozzle.dxf, thermal-barrier-tube.dxf]
2010-06-06 tagged mk5 release.
    [drive-gear.dxf, filament-drive.dxf, heater-block.dxf, layout-acrylic.dxf, layout-delrin.dxf, mk4-adaptor.dxf, nozzle.dxf, thermal-barrier-tube.dxf]
2010-06-07 added templates for hardware sorting.
    [plastruder-mk5-hardware-kit.dxf]
2010-06-07 added the relay board design.
    [relay-board.brd, relay-board.sch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]
2010-06-08 To conveyor added drawings and structure for a smaller brush. This one works much better.
    [conveyor.dxf]
2010-06-10 started work on kitten.
    [front.dxf]
2010-06-10 svn sucks.
    [MBV2.dxf, back.dxf, bearing-bracket.dxf, bottom.dxf, brass-bearing-adaptor-plate.dxf, build-platform.dxf, build-surface.dxf, cap.dxf]
2010-06-10 nuked a bunch of old stuff.
    [MBV2.dxf, back.dxf, bottom.dxf, idler-pulley-608.dxf, idler-pulley-608.stl, idler-pulley-625.dxf, idler-pulley-625.stl, left.dxf]
2010-06-10 brought out the body assembly stuff.
    [body-assembly.dxf]
2010-06-11 worked a bit on the body/z-stage.
    [body-assembly.dxf]
2010-06-11 started work on the cantilever build stage.
    [z-stage.dxf]
2010-06-11 worked on the z stage a bunch.
    [body-assembly.dxf, z-stage.dxf]
2010-06-11 moved the z stage to the kitten.
    [z-stage.dxf]
2010-06-12 added initial xy stage mockup.
    [body-assembly.dxf, xy-stage.dxf]
2010-06-12 more work on xy stage.
    [xy-stage.dxf]
2010-06-14 more work on the xy stage
    [body-assembly.dxf, xy-stage.dxf]
2010-06-15 some late changes to the xy stage.
    [xy-stage.dxf]
2010-06-15 renamed igus drawing.
    [igus-xy-stage.dxf]
2010-06-15 worked on the xy stage a bit more.
    [sdp-si-xy-stage.dxf]
2010-06-16 worked on the x axis stuff a bit more.
    [body-assembly.dxf, sdp-si-xy-stage.dxf]
2010-06-17 more tweaks on the xy stage and a kerf tester.
    [4mm-kerf-tester.dxf, sdp-si-xy-stage.dxf]
2010-06-17 worked on the kerf testers.
    [3mm-kerf-tester.dxf, 6mm-kerf-tester.dxf]
2010-06-17 got the test rig ready for the new bearing stuff.
    [sdp-si-xy-stage.dxf]
2010-06-17 fixed a bug in the xy stage.
    [sdp-si-xy-stage.dxf]
2010-06-18 tagged the relay board v1.0 release.
    [body-assembly.dxf, relay-board.brd, relay-board.sch, sdp-si-xy-stage.dxf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]
2010-06-18 xy stage is looking pretty decent.
    [igus-xy-stage.dxf, xy-stage.dxf, z-stage-tester.dxf]
2010-06-18 split out the x stage and x stage tester into 2 files.
    [x-stage-tester.dxf, xy-stage.dxf]
2010-06-18 added initial y stage import.
    [y-stage.dxf]
2010-06-18 removed old folder.
    [back.dxf, bearing-bracket.dxf, brass-bearing-adaptor-plate.dxf, build-platform.dxf, build-surface.dxf, cap.dxf, clamp.dxf, front.dxf]
2010-06-18 renamed files for better or worse.
    [primary-stage-tester.dxf, primary-stage.dxf, secondary-stage.dxf]
2010-06-19 started modeling more of the system to get a clearer picture.
    [idler-bearing-stackup.dxf, xy-stackup.dxf]
2010-06-19 got the primary stage/axis rocking pretty well now.
    [primary-stage.dxf, xy-stackup.dxf]
2010-06-19 added top caps for the primary stage.
    [primary-stage.dxf]
2010-06-19 worked on the secondary stage a bit more.
    [primary-stage.dxf, secondary-stage.dxf, xy-stackup.dxf]
2010-06-19 secondary stage is probably ready to cut.
    [secondary-stage.dxf]
2010-06-20 worked a bunch on the primary stage.
    [body-assembly.dxf, nema-17.dxf, primary-stage.dxf]
2010-06-20 worked on the kitten design a bit more.
    [primary-stage.dxf, secondary-stage.dxf, z-stage.dxf]
2010-06-21 Conveyor. Takes less space. New gears. Brush holder. PCB flat against top platform.
    [conveyor-layout.dxf, conveyor.dxf]
2010-06-21 Now includes brush retainer.
    [conveyor-layout.dxf]
2010-06-21 did a bunch of tweaks based on the first prototype.
    [primary-stage.dxf, secondary-stage.dxf]
2010-06-23 a few tweaks on the xy stage.
    [primary-stage.dxf, secondary-stage.dxf]
2010-06-24 To conveyor added a belt layout for adding a 3/4 inch adhesive strip.
    [conveyor-layout.dxf, conveyor.dxf]
2010-06-24 made a few fixes to the stages.
    [primary-stage-tester.dxf, primary-stage.dxf, secondary-stage.dxf]
2010-06-24 made hole for motor + pulley
    [primary-stage.dxf]
2010-06-25 more work on the rigs and such. getting ready for first run of z axis.
    [primary-stage-tester.dxf, primary-stage.dxf, z-stage-tester.dxf, z-stage.dxf]
2010-06-25 fixed improperly sized holes.
    [z-stage-tester.dxf]
2010-06-25 Minor changes to the conveyor to prepare for a 17 mm motor and 3 mm shaft. Life is good.
    [conveyor-layout.dxf, conveyor.dxf]
2010-06-28 worked on the z stage a bit more.
    [z-stage.dxf]
2010-06-28 Added conveyor belt dimension drawing.
2010-06-29 To ABP, bushings are snap-in. Things are looking good.
    [conveyor.dxf]
2010-06-29 made some tweaks to the z stage.
    [primary-stage.dxf, z-stage.dxf]
2010-06-29 worked on the z axis tester a bit more.
    [z-stage-tester.dxf]
2010-06-29 added proper drawing of flange nut.
    [z-stage.dxf]
2010-06-30 Changed belt size.
    [conveyor-layout.dxf]
2010-06-30 Improved shaft snap structure.
    [conveyor-layout.dxf, conveyor.dxf]
2010-07-01 various tweaks and such.
    [body-assembly.dxf, z-rod.dxf]
2010-07-01 fixed a few small bugs in the z stage and tester.
    [z-stage-tester.dxf, z-stage.dxf]
2010-07-01 a few body tweaks.
    [body-assembly.dxf]
2010-07-01 got PSU placement, electronics, and a flip of the xy axis going.
    [body-assembly.dxf, primary-stage.dxf, z-stage.dxf]
2010-07-02 added endstops, cleaned up the z stage file, keeping it real.
    [body-assembly.dxf, primary-stage.dxf, secondary-stage.dxf, z-stage.dxf]
2010-07-02 added etch text and cleaned up all layers on all files.
    [body-assembly.dxf, primary-stage.dxf, secondary-stage.dxf]
2010-07-02 nuked a bunch of old blocks.
    [body-assembly.dxf]
2010-07-02 tweaked the blocks a bit and more cleanup before dry run.
    [body-assembly.dxf]
2010-07-02 fixed some bugs in the body assembly.
    [body-assembly.dxf]
2010-07-05 Added scraper.
    [conveyor-layout.dxf, conveyor.dxf]
2010-07-05 worked on the kitten a bit more. ready for prototype v2.
    [body-assembly.dxf]
2010-07-05 Fixed ABP problem with parts not lining up correctly.
    [conveyor-layout.dxf, conveyor.dxf]
2010-07-05 a few tweaks based on the v2 prototype.
    [body-assembly.dxf]
2010-07-05 a few more tweaks to the body.
    [body-assembly.dxf]
2010-07-07 switched to 3/8in primary rods and evened the spacings.
    [body-assembly.dxf, primary-stage.dxf]
2010-07-07 modified the t-slot size and fixed datum point bug on z stage.
    [body-assembly.dxf, primary-stage.dxf, secondary-stage.dxf, z-stage.dxf]
2010-07-07 stupid z bug.
    [z-stage.dxf]
2010-07-07 did a bunch of hacking on the stages to get everything perfect.
    [body-assembly.dxf, primary-stage.dxf, z-stage.dxf]
2010-07-07 some tweaks to z stage zie.
    [z-stage.dxf]
2010-07-07 fixed more bugs.
    [body-assembly.dxf, z-stage.dxf]
2010-07-08 added build surface for etching.
    [secondary-stage.dxf]
2010-07-12 worked on the kitten design a bunch more.
    [body-assembly.dxf, primary-stage.dxf, secondary-stage.dxf, z-rod.dxf]
2010-07-13 flipped the xz and tweaked a few other things.
    [body-assembly.dxf, primary-stage.dxf]
2010-07-13 did a bunch more hacking on the kitten design.;
    [body-assembly.dxf, primary-stage.dxf, secondary-stage.dxf, z-stage.dxf]
2010-07-13 added nema 17 gasket template.
    [nema-17-gasket-layout.dxf, nema-17-gasket.dxf]
2010-07-13 To ABP, made compatible with 24 mm motor.
    [conveyor-layout.dxf, conveyor.dxf]
2010-07-14 To conveyor, make snap slots stronger.
    [conveyor-layout.dxf, conveyor.dxf]
2010-07-14 worked on the xy stages a bunch.
    [primary-stage.dxf, secondary-stage.dxf]
2010-07-15 Inserted pull-downs on gates of Q1-Q3 on Extruder Controller Inserted power connector on Extruder Controller Removed power from RJ-45 Inserted Testpoints throughout Replaced Q1-Q3 with low-threshold,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
    [extruder-controller.brd, extruder-controller.sch, mechanical-endstop.brd, mechanical-endstop.sch, motherboard.brd, motherboard.sch, stepper-motor-driver.brd, stepper-motor-driver.sch]
2010-07-15 fixed the mosfet connections.
    [extruder-controller.brd, extruder-controller.sch]
2010-07-15 prepared the extruder controller for release.
    [extruder-controller.brd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]
2010-07-15 Added testpoint
    [mechanical-endstop.brd]
2010-07-15 Added test points, inserted debug features in silk
    [motherboard.brd, motherboard.sch]
2010-07-15 big tidyup of the kitten design.
    [body-assembly.dxf, primary-stage.dxf, z-stage.dxf]
2010-07-15 worked on the body a bit more.
    [body-assembly.dxf]
2010-07-15 Added branding.
    [conveyor.dxf]
2010-07-16 tweaked the mounts on the y stage
    [secondary-stage.dxf]
2010-07-16 tweaked the design a bit more
    [body-assembly.dxf]
2010-07-16 Added test points and updated silk.
    [motherboard.sch]
2010-07-16 Added more test points, updated minor version.
    [stepper-motor-driver.brd, stepper-motor-driver.sch]
2010-07-16 Removed mask from test point.
    [mechanical-endstop.brd]
2010-07-16 Removed mask from test points Library element needs to be changed.
    [motherboard.brd]
2010-07-16 fixed mistake in RS-485 connector.
    [extruder-controller.brd, extruder-controller.sch]
2010-07-20 worked a bunch more on the kitten design. final tweaks now.
    [body-assembly.dxf, primary-stage.dxf, secondary-stage.dxf]
2010-07-20 Fixed ERC errors and sized PCB
    [motherboard.brd, motherboard.sch]
2010-07-21 lots of tweaks around the board for final prototyping.
    [body-assembly.dxf, primary-stage.dxf, secondary-stage.dxf, z-stage.dxf]
2010-07-22 made a few tweaks and stuff for betterness.
    [body-assembly.dxf, primary-stage.dxf, z-stage.dxf]
2010-07-22 fixed some bugs in the xyz assemblies.
    [body-assembly.dxf, primary-stage.dxf, secondary-stage.dxf]
2010-07-22 shrunk the x stage to fit entirely inside the box.
    [body-assembly.dxf, primary-stage.dxf, secondary-stage.dxf]
2010-07-22 fixed up the back panel a bit more.
    [body-assembly.dxf, primary-stage.dxf]
2010-07-22 minor bug with xy axis not fitting in 100%
    [body-assembly.dxf, primary-stage.dxf, secondary-stage.dxf]
2010-07-23 a bunch of work on kitten and cnc spindle action.
    [body-assembly.dxf, spindle.dxf, z-stage.dxf]
2010-07-24 updated linear encoder for production.
    [magnetic-linear-encoder.brd]
2010-07-26 To conveyor, moved thermistor hole.
    [conveyor.dxf]
2010-07-27 a bunch of tweaks to kitten. possibly dropping xy 624 bearings
    [body-assembly.dxf, primary-stage.dxf, secondary-stage.dxf]
2010-07-27 fixed a bug in the primary stage length.
    [primary-stage.dxf]
2010-07-27 removed stupid line
    [primary-stage.dxf]
2010-07-28 fixed idler retainer spacing problem.
    [primary-stage.dxf]
2010-07-28 a few of my own tweeks.
    [primary-stage.dxf, secondary-stage.dxf]
2010-07-28 worked a few mour mmm out of the z
    [body-assembly.dxf, primary-stage.dxf, secondary-stage.dxf]
2010-07-28 hacked on the spindle design a bit more.
    [spindle.dxf]
2010-07-28 figured out proper endstop spots
    [primary-stage.dxf]
2010-07-28 some tweaks to the xy stage.
    [primary-stage.dxf, secondary-stage.dxf]
2010-07-29 re-added bearings on x stage
    [body-assembly.dxf, primary-stage.dxf, secondary-stage.dxf]
2010-07-29 i think shes finally ready.
    [primary-stage.dxf, secondary-stage.dxf]
2010-07-29 small tweaks to the body.
    [body-assembly.dxf]
2010-07-29 a few more minor pre-production tweaks.
    [body-assembly.dxf, primary-stage.dxf]
2010-08-02 final pre-production tewaks.
    [body-assembly.dxf, primary-stage.dxf, secondary-stage.dxf, z-stage.dxf]
2010-08-06 worked on the spindle design a bit more.
    [spindle.dxf]
2010-08-06 a few minor tweaks.
    [spindle.dxf]
2010-08-06 To conveyor, unknown change. Probably something trivial.
    [conveyor-layout.dxf, conveyor.dxf]
2010-08-06 Makerbot controller V1.0
    [motherboard.brd, motherboard.sch]
2010-08-06 prep work for production.
    [motherboard.brd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]
2010-08-06 renamed g5 to machine controller.
    [motherboard.brd, motherboard.sch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]
2010-08-06 renamed the board a bit.
    [machine-controller.brd, machine-controller.sch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]
2010-08-11 * Adding firmware for v22 boards
2010-08-13 Added stepper
    [machine-controller.brd, machine-controller.sch]
2010-08-13 To Kitten secondary stage, moved the build platform mounting holes to 4 mm from each edge rather than the original 3 mm from each edge. This is to accomidate the structural requirements of the kitten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
    [secondary-stage.dxf]
2010-08-13 * Added firmware for EC2.2 stepper support
2010-08-19 * Adding fix to stepper version
2010-08-20 PAX wanted pads placed symetrically over center hole.
    [kitten-heater-board.brd]
2010-08-20 final tweaks to the kitten design.
    [body-assembly.dxf, primary-stage.dxf, secondary-stage.dxf, z-stage.dxf]
2010-08-20 Another bump for the stepper firmware
2010-08-20 Version 3.6
    [extruder-controller.brd, extruder-controller.sch]
2010-08-20 Updated silkscreen
    [extruder-controller.brd]
2010-08-20 made a few tweaks to wire sizes.
    [kitten-heater-board.brd]
2010-08-20 renamed the board.
    [thingomatic-heater-board.brd, thingomatic-heater-board.sch]
2010-08-20 added the dc servo controller board.
    [dc-servo-controller.brd, dc-servo-controller.sch]
2010-08-20 renamed the heater board.
    [thingomatic-heater-board.brd, thingomatic-heater-board.sch]
2010-08-23 Adding r4 of stepper extruder controller
2010-08-24 added test rig and firmware.
    [test-rig.dxf]
2010-09-01 Prior to final changes
    [machine-controller.brd, machine-controller.sch]
2010-09-02 * Bringing beta in line with release * Adding beta of relay firmware
2010-09-08 * adding new firmware for relay boards.
2010-09-10 Moved automated build platform to trunk.
    [automated-build-platform.dxf, conveyor.dxf]
2010-09-10 Tagged the ABPv1 release.
    [automated-build-platform.dxf]
2010-09-15 updated the instructions for the 3 new boards.
2010-09-16 changed 3.3v supply to be from atx power supply.
    [motherboard.brd, motherboard.sch]
2010-09-17 Added a rellay adapter.
    [relay-controller-adapter.dxf, relay-driver-adapter.dxf]
2010-09-20 got the thingomatic ready for production, updated ec v3.6
    [extruder-controller.xls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]
2010-10-05 Final changes before design review
    [machine-controller.brd, machine-controller.sch]
2010-10-05 more preproduction changes
    [machine-controller.brd, machine-controller.sch]
2010-10-07 added instructions, partlist, and drill/pov.
    [Machine-Controller-v-1.2-partlist.csv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]
2010-10-07 a few release mods.
    [thingomatic-heater-board-v1.1-bom.csv]
2010-10-08 Added my Bowden design from last year.
    [bowden-layout.dxf, bowden.dxf, drive-pulley.dxf, filament-box-layout.dxf, filament-box.dxf, spool.dxf]
2010-10-27 Added my test rig
    [electronics-test-mount.dxf, motherboard-test-rig.dxf]
2010-10-28 Updated t slots.
    [motherboard-test-rig.dxf]
2010-10-28 Added test rig for 37 mm DC gearmotor.
    [gear-motor-test-rig.dxf]
2010-11-11 * adding alpha of v2.4 for v12 boards
2010-11-26 tagged teh gen4 electronics
    [extruder-controller.brd, extruder-controller.sch, mechanical-endstop.brd, mechanical-endstop.sch, motherboard-1.2.xls, motherboard.brd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]
2010-11-30 tagged thingomatic source.
    [body-assembly.dxf, idler-bearing-stackup.dxf, primary-stage-tester.dxf, primary-stage.dxf, secondary-stage.dxf, xy-stackup.dxf, z-rod.dxf, z-stage-tester.dxf]
2010-12-03 * Adding 2.4/2.6 for old boards
2011-01-17 reconfigured board to be 100% PTC
    [interface.brd, interface.sch]
2011-01-19 fixed the lcd tester script and updated the interface to our current standards.
    [interface.brd, interface.sch]
2011-02-01 removed the 5v regulator from the extruder controller board.
    [extruder-controller.brd, extruder-controller.sch]
2011-03-21 pulled in harrys changes for 2.5
    [motherboard.brd, motherboard.sch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]
2011-10-20 * Removing assets
    [Cupcake Parts List.ods, RepRap Master BOM Part 2.ods, RepRap Master BOM.ods, makerbot.dxf, pop-bot.dxf]
