jmil/makerbot/(notices)

Notices in the files:
users/hoeken/gen5/watch/source/MakerBotWatch_V1.1.pde:
the Free Software Foundation; either version 3 of the License, or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
